Hoxford/tyler-woogduh/playground/RadioUpdater_Firmware/READ_ME.txt

This firmware is intended for use to update the BT radio module
See use instructions located in release directory
