Hoxford/tyler-woogduh/documents/mechanical/Daily Scrum and Status Reports for This Week/Kris's 10-01-14 Scrum Report.docx

10/1/2014 7:15:00 AM

Scrum Report For: Oct 1 2014

Yesterday’s Tasks

There were no OODG tasks scheduled yesterday due to other work commitments

Today’s Tasks

1. Write assembly procedure for EKG module. Identify any tools, etc., required for assembly.
2. When gaskets arrive, go to OODG and assemble Alpha 1 proto. Review and note problems or issues, and plan to make fixes. If Alpha 1 is OK, schedule visit to Out of Box.
3. Contact Sabic rep re material options, grades, etc.

GEBOWkris@gebow.com425-837-8700
