Hoxford/tyler-woogduh/documents/mechanical/Daily Scrum and Status Reports for This Week/Kris's 09-30-14 Scrum Report.docx

9/29/2014 5:12:00 PM

Scrum Report For: Sep 30 2014

Yesterday’s Tasks

Except for item 7, task list below is the same as in email sent yesterday PM with side grip pictures.

1. Reviewed Sabic site for color information. Have questions for them, left voice mail, waiting for call back.
2. Called Sabic rep re resin options, alternatives. Left voice mail, waiting for call back.
3. Talked to RTP, a materials supplier/compounder for Solid Concepts regarding resins and color input. They’ll have recommendations by sometime Wed Oct 1.
4. Could not find Skype email; could you please re-send invitation to join.
5. Sent updated cleaning instructions to Patrice cc Bob
6. Module with side grips
7. Bought adhesive and fiber washers for sealing leak test to

Today’s Tasks

Today I’ll be out of the office on other business. Please call if you have any questions. I’ll be back doing OODG work tomorrow.

Please let me know if the gaskets come in. I’ll come by ASAP to do fit checks.

GEBOWkris@gebow.com425-837-8700
