Hoxford/tyler-woogduh/documents/mechanical/Daily Scrum and Status Reports for This Week/Kris's x-x-14 Scrum Report.docx

7/9/2014 11:35:00 AM

Scrum Report For:

Yesterday’s Tasks

Today’s Tasks

GEBOWkris@gebow.com425-837-8700
