Hoxford/tyler-woogduh/documents/mechanical/Completion of PPR 100214.pdf

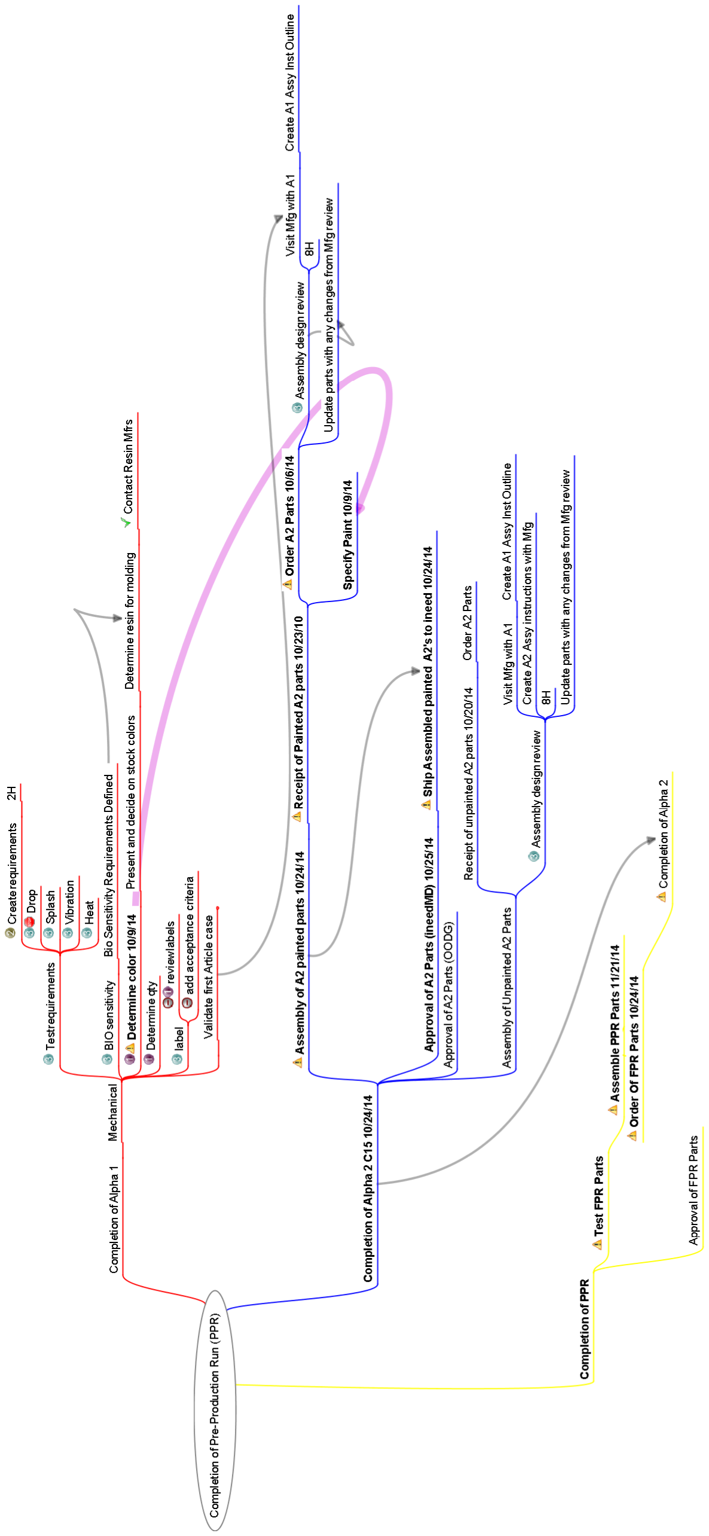
[picture p11: figure]
