Hoxford/tyler-woogduh/documents/mechanical/Current Design wAir Test Port/Notes and Parts Required for Leak Test.docx

Parts required for AT-Leakdown

1. Gauge – low pressure
2. Sealant
3. Manual Pump Bulb
4. Reservoir
5. Module fitting
6. Insert fitting
7. O-ring – 50 durometer
8. Air to Insert fitting
9. Tubing

GEBOWkris@gebow.com425-837-8700
