Hoxford/tyler-woogduh/documents/mechanical/Quotes/Ineed MD Mechanical Part Order List 090114.docx

Ineed MD Mechanical

09-01-14

Order list for proto 3

Item No | Name | P/N and Rev | Supplier | Qty | Cost (Ship not incld.) | Leadtime Business days | Quote/Notes
1 | Top | 10052 P3.3 | a. Fit Check Approval Parts a. Order 1 part from Fathom b. Shapeways Evaluation Part. Can Shapeways build good parts? c. In-house Parts - Shapeways a. After fit check Approval, order 8 parts d. Presentation Parts a. After fit check Approval, order 4 parts from Fathom | 1 1 8 2 | 120.25 26.84 214.72 240.49 | 4 est 7 7 4 | 10051_P33_10052_P33_10053_P33 Fathom quote A 10052 P3.3 Shapeways quote A 10052 P3.3 Shapeways quote C 10051_P33_10052_P33_10053_P33 Fathom quote A
2 | PCBA (Circuit Board Assy) | | See Brian, electrical assembly | 13 | 0
3 | Bottom | 10051 P3.3 | Same suppliers and instructions as Top a. Fit Check Approval Parts a. Order 1 part from Fathom, see quote b. Shapeways Evaluation Part. Can Shapeways build good parts? a. See quote c. In-house Parts - Shapeways a. After fit check Approval, order 8 parts from Shapeways, see quote d. Presentation Parts a. After fit check Approval, order 4 parts from Fathom | 1 1 8 2 | 117.61 31.58 252.64 235.23 | 4 est 7 7 4 | 10051_P33_10052_P33_10053_P33 Fathom quote A 10052 P3.3 Shapeways quote A 10052 P3.3 Shapeways quote D 10051_P33_10052_P33_10053_P33 Fathom quote B
4 | Label ineedMD 3 LED LR | 10059 P3.3 | Maverick Labels | 13 | 183.21 | | Need Artwork
5 | Lightpipe | 10053 P3.3 | From Stock | 39 | 0 | | 3 per assembly
6 | Screw Plastite or Equiv | 99461A286 | McMaster Carr | 50 | 25.00 | | Verify size 2 per assembly, order 2 pkgs of 25 Price includes shipping estimate
7 | Gasket | 10071 P3.3 | Stockwell | 150 | 230.00 | 12 | 10071 P3.3 Stockwell quote A 150 same price as 14 2 day ship est included
8 | Adhesive Pad | 10073 P3.3 | Gardico | 13 | 200.00 | | Estimate. quote coming soon
9 | Battery | | See Brian, electrical part | 13 | 0
10 | Foam Cushion | 10055 P3.4 | Stockwell | 150 | 230.00 | | 10055 P3.4 Stockwell quote A 150 same price as 14 2 day ship est included
11 | Label Serial Number | 10072 P3.3 | Maverick | 14 | 152.70 | 4 | Need Artwork
| | | | | 0
| Total | | | | 2158.18 | | Does not include Lightpipes if needed
