Hoxford/tyler-woogduh/documents/mechanical/Part Number Log.xlsx

Sheet: Part Numbers
Part number index - Object Oriented Design Group |  |  |  | Rev A 06-30-14 KCG | Create numbers 10050-10080 For ineedMD and new BOM 10050
Part Number | Description | Category | Part Replaced by | Replaced by date
10050 | Assy, ineedMD Mechanical | 01
10051 | Bottom | 05
10052 | Top | 05
10053 | Light Pipe | 05
10054 | Gasket, Die Cut | 09
10055 | Foam, Battery Cushion | 09
10056 | Label, ineedMD | 09
10057 | PCBA, ineedMD | 02
10058 | Label, ineedMD Left Right LED | 09
10059 | Label, ineedMD Upper-Lower LED | 09
10060 | Bottom 3 LED | 05
10061 | Assy Cable ECG (Spacelabs) | 03
10062 | Connector ECG
10063 | Connector Glove
10064 | PCBA, ECG Cable
10065
10066 | Assy, Overmold P2 and Cable
10067 | Garment Clip
10068 | Heat Shrink 6.4x11mm Black
10069 | PCB, ineedMD | 14
10070 | Battery
10071 | Gasket Cut
10072 | SN Label
10073 | Adhesive Pad
10074 | Gasket Molded
10075 | Bottom Audio Port
10076 | Top ATP (Audio-Test Port)
10077 | Pressure Test Connector
10078 | Assy PT Connector
10079 | ?
10080 | Assy ineedMD EKG Module
10081 | Light Pipe Holder
10082 | Label Serial Number P3
10083 | Label ineedMD Front P3
10084 | Light Pipe wDome
10085 | Battery Door
1051
1052
1053
1054
1055
1056
1057
1058
1059
1060

Sheet: Categories
Part Category Index
Category | Description | Examples
0 |  | Finished Goods, Boxed Ready to ship
01 | Finished Products | Dongle
02 | PCB Assemblies | Assemblies
03 | Cable Assemblies, External Product | Electrode Cable
04 | Cable Assemblies, Internal | Jack Harness
05 | Plastic molded part | Bottom
06 | Sheet metal part
07 | Product Subassembly
08 | Plastic molded part machined/modified/processed
09 | Die cut non-metallic parts | Gasket
10 | Plastic fabricated part
11 | Software, released, including updates
12 | Product packaging | Custom boxes
13 | Printed paper/sign material components | Display graphic foam board
14 | Printed circuit board, raw
15 | Tooling
16 | Label custom
17
18
19
20
21
22
23
24
25
26
27
28
29
30
31
32
33
34
35
36
37
38
39
40
41
42
43
44
45
46
47
48
49
50
51
52
53
54
55
56
57
58
59
60
61
62
63
64
65
66
67
68
69
70
71
72
73
74
75
76
77
78
79
80
81
82
83
84
85
86
87
88

Sheet: Readme
Part Number Category Index, Use Instructions | Rev A 6/12/13 DJD
Inneractive Enterprises, Inc.
When making any change to any sheet of the index, update the date on the top line of the first sheet.
To sort the index in non- part-number order, e.g. by category or category and description, make a copy and leave the original unchanged.
Part numbers are assigned for custom fabricated or assembled parts only, not off the shelf parts. The manufacturer or suppliers numbers are used for the latter.
Part numbers or categories may be reviewed and added to by opening, reading and or editing the appropriate page.
Note that when a change is made to a part that is not backwards or forwards compatible, the part should get a new part number and the new part noted with the date in the “Part replaced by” and “Part replaced by date” fields.
