Hoxford/tyler-woogduh/documents/mechanical/Current Design wAir Test Port/Quotes for Leak Test and Light Pipe Tool Parts.docx

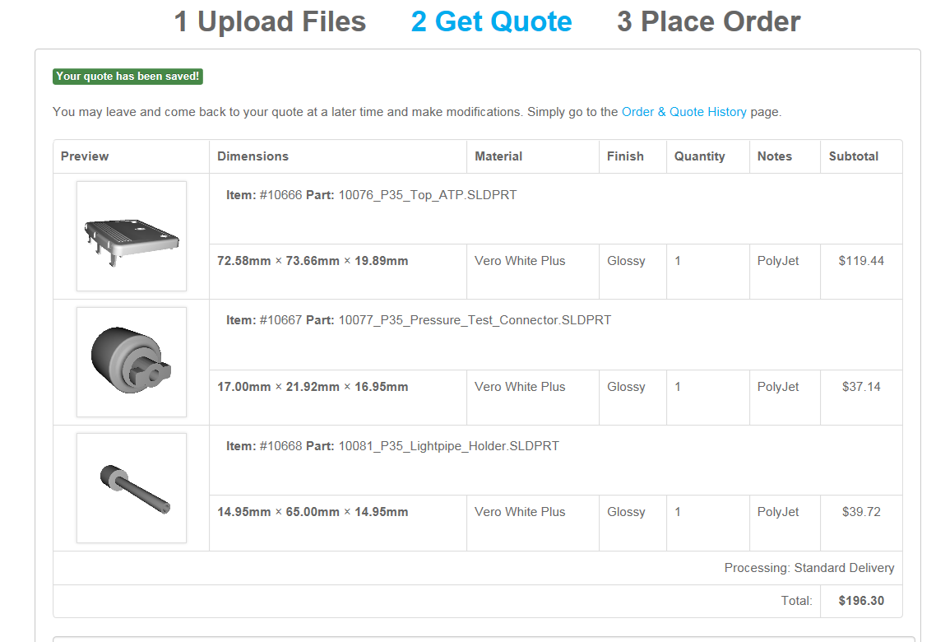
[picture p12: figure]
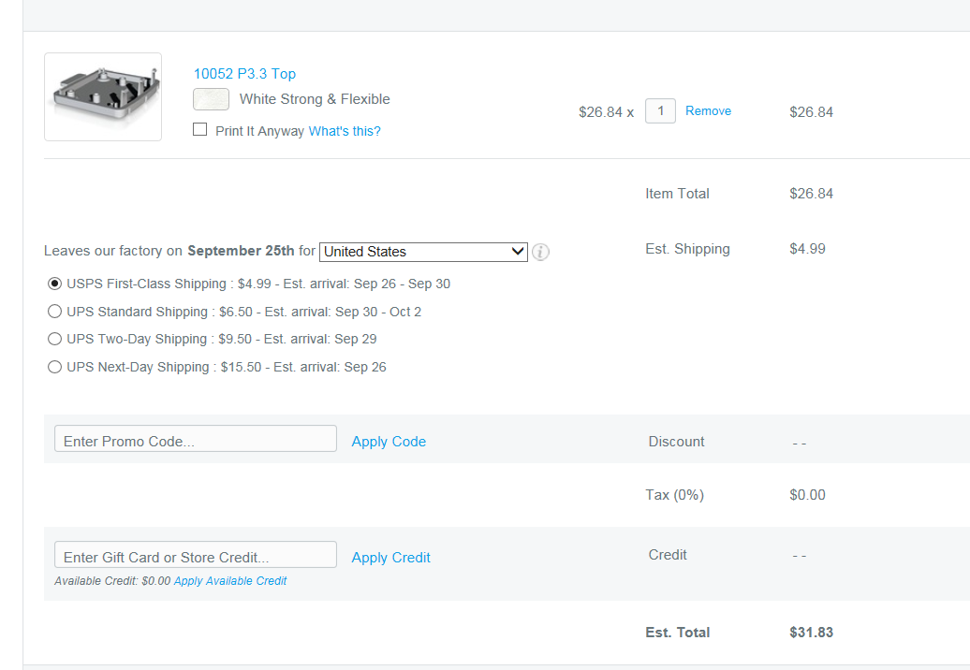
[picture p13: figure]
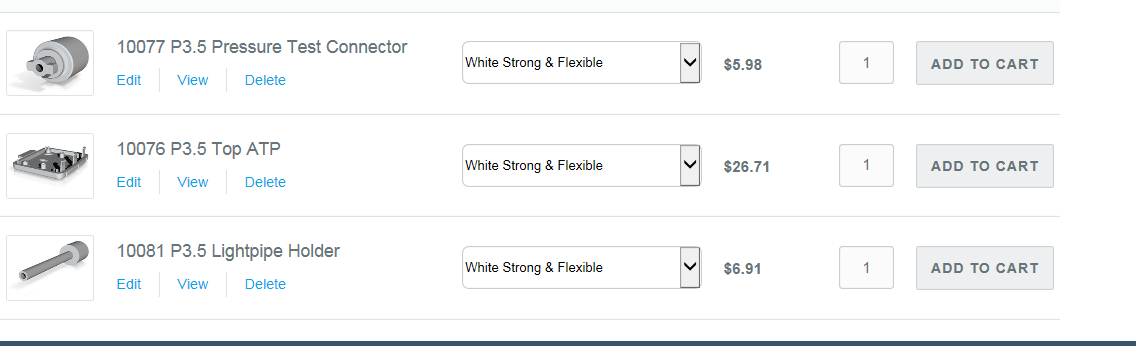
[picture p14: figure]
