Hoxford/tyler-woogduh/documents/mechanical/Current Design/Assy PT Connector.SLDASM

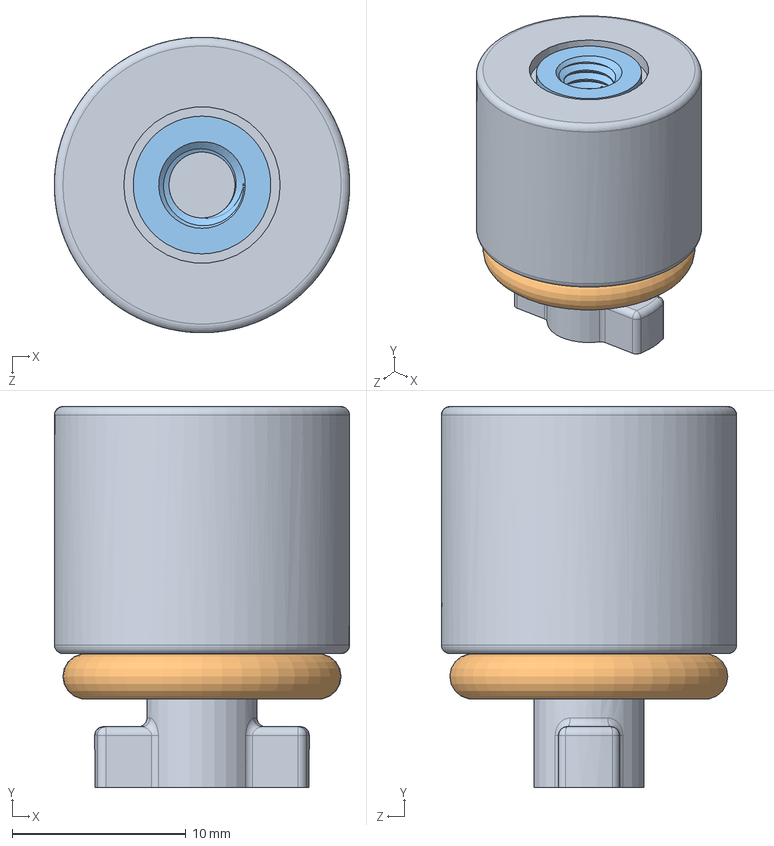
[picture p15: CAD file, 2014-10-17]
documents/mechanical/Current Design/Assy PT Connector.SLDASM
17.0 x 21.9 x 17.0 mm
10077 P3.4 Pressure Test Connector
AS568A-111
94615A115 10-32 Insert
