Hoxford/tyler-woogduh/documents/mechanical/Current Design/Assy for Light Pipe Work.SLDASM

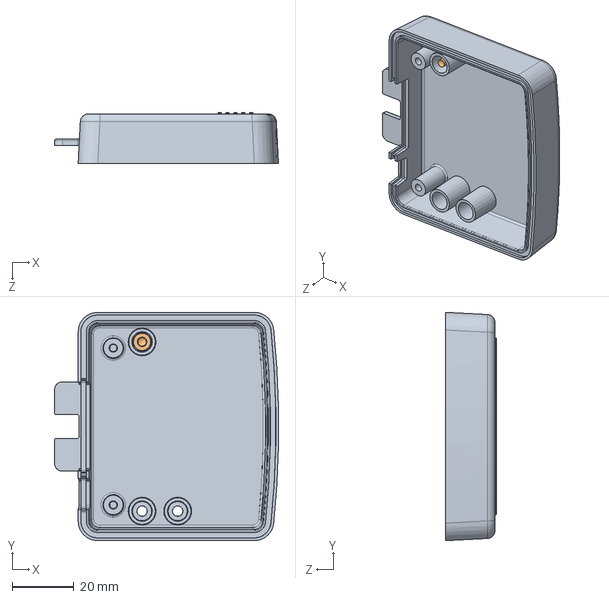
[picture p16: CAD file, 2014-10-17]
documents/mechanical/Current Design/Assy for Light Pipe Work.SLDASM
72.3 x 73.7 x 16.5 mm
10051 P3.3 Bottom
10084 P3.5 Light Pipe wDome
