Hoxford/tyler-woogduh/documents/mechanical/Current Design/SML-P24GR LED.SLDPRT

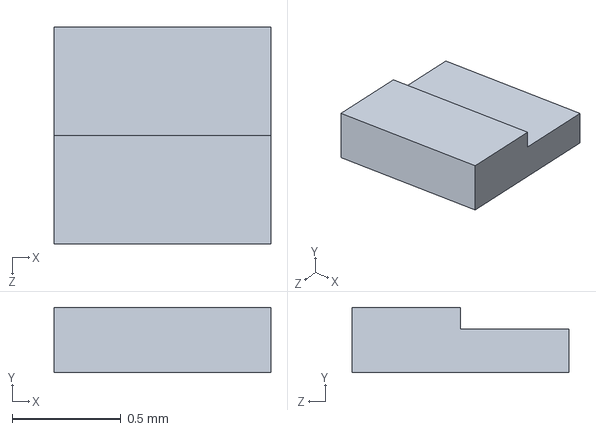
[picture p17: CAD file, 2014-10-17]
documents/mechanical/Current Design/SML-P24GR LED.SLDPRT
1.00 x 0.3 x 1.00 mm
