Hoxford/tyler-woogduh/documents/mechanical/Current Design wAir Test Port/uUSBconn.SLDPRT

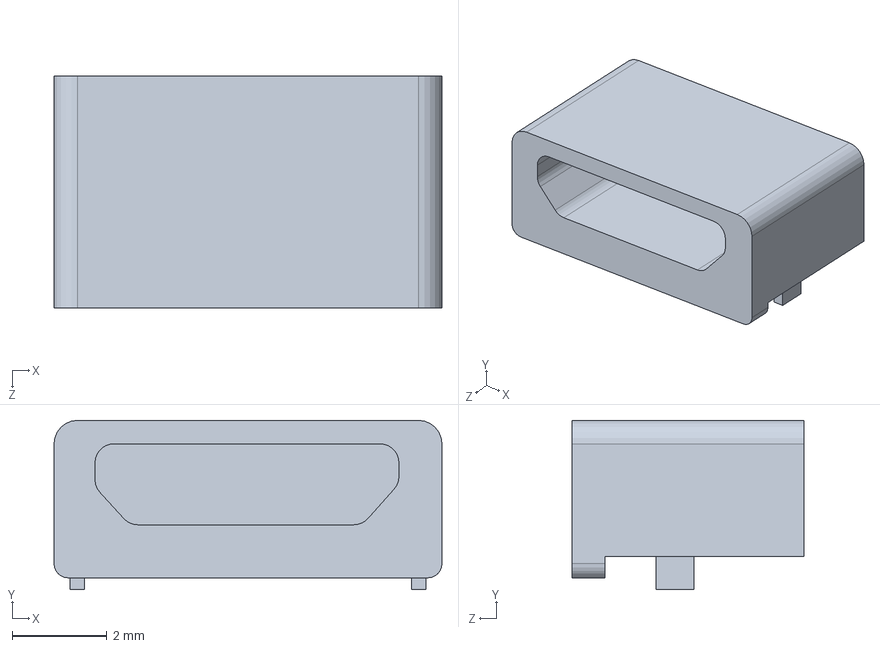
[picture p18: CAD file, 2014-10-17]
documents/mechanical/Current Design wAir Test Port/uUSBconn.SLDPRT
8.20 x 3.58 x 4.90 mm
