Hoxford/tyler-woogduh/documents/mechanical/Current Design wAir Test Port/AS568A-111.SLDPRT

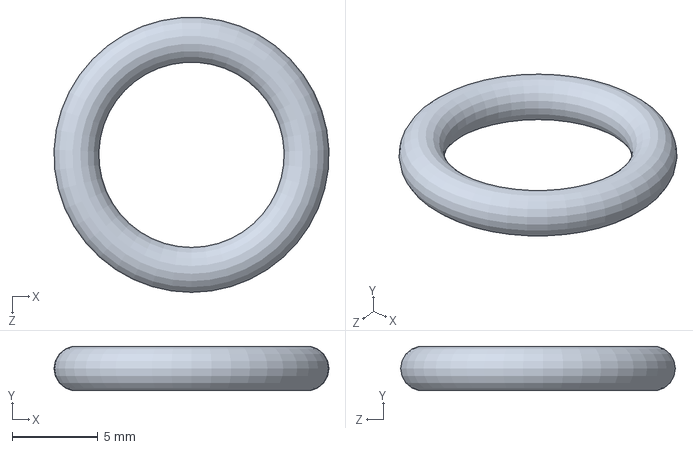
[picture p19: CAD file, 2014-10-17]
documents/mechanical/Current Design wAir Test Port/AS568A-111.SLDPRT
16.0 x 2.58 x 16.0 mm
