Hoxford/tyler-woogduh/documents/mechanical/Current Design/AAA Duracell Body-Plain.STEP

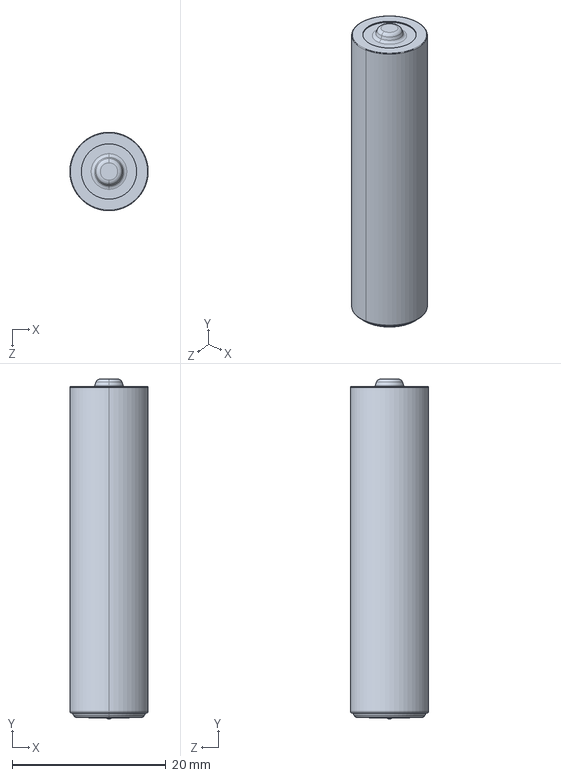
[picture p20: CAD file, 2014-10-17]
documents/mechanical/Current Design/AAA Duracell Body-Plain.STEP
10.2 x 44.2 x 10.2 mm
