Hoxford/tyler-woogduh/documents/mechanical/Current Design wAir Test Port/10057 P3.3 PCBA, ineedMD Mechanical.SLDASM

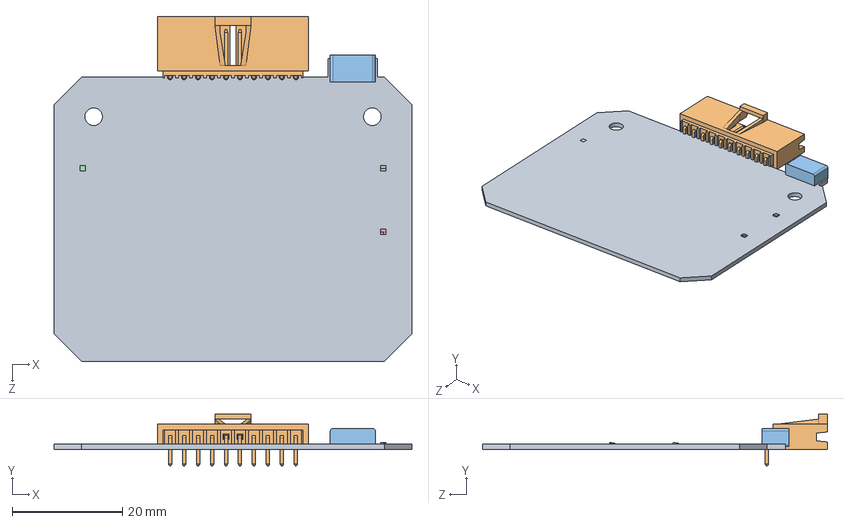
[picture p21: CAD file, 2014-10-17]
documents/mechanical/Current Design wAir Test Port/10057 P3.3 PCBA, ineedMD Mechanical.SLDASM
65.0 x 9.40 x 62.6 mm
10069 P3.3 PCB ineedMD
10pinconn
uUSBconn
SML-P24GR LED x 2
SML-P34GRB LED
