Hoxford/tyler-woogduh/(list of files, cad)

Other CAD files:
documents/mechanical/Current Design 092414/SML-P34GRB LED.SLDPRT
documents/mechanical/Current Design 092414/10pinconn.SLDPRT
documents/mechanical/Current Design/10pinconn.SLDPRT
documents/mechanical/Current Design wAir Test Port/SML-P34GRB LED.SLDPRT
documents/mechanical/Current Design wAir Test Port/10pinconn.SLDPRT
documents/mechanical/Current Design/AS568A-111.SLDPRT
documents/mechanical/Current Design/SML-P34GRB LED.SLDPRT
documents/mechanical/Current Design 092414/10050 P3.3 Assy, ineedMD Mechanical.SLDASM
documents/mechanical/Current Design 092414/10050 P3.4 Assy, ineedMD Mechanical.SLDDRW
documents/mechanical/Current Design 092414/10050 P3.5 Assy, ineedMD Mechanical.SLDDRW
documents/mechanical/Current Design 092414/10050 P3.6 Assy, ineedMD Mechanical.SLDDRW
documents/mechanical/Current Design 092414/10051 P3.3 Bottom.SLDPRT
documents/mechanical/Current Design 092414/10052 P3.3 Top.SLDPRT
documents/mechanical/Current Design 092414/10053 P3.4 Light Pipe.SLDPRT
documents/mechanical/Current Design 092414/10055 P3.4 Foam Cushion.SLDPRT
documents/mechanical/Current Design 092414/10057 P3.3 PCBA, ineedMD Mechanical.SLDASM
documents/mechanical/Current Design 092414/10059 P3.3 label, ineedMD 3 LED LR.SLDPRT
documents/mechanical/Current Design 092414/10069 P3.3 PCB ineedMD.SLDPRT
documents/mechanical/Current Design 092414/10070 P3.4 Battery.SLDPRT
documents/mechanical/Current Design 092414/10071 P3.3 Gasket Cut.SLDPRT
documents/mechanical/Current Design 092414/10072 P3.3 Serial Number Label.SLDPRT
documents/mechanical/Current Design 092414/10073 P3.3 Adhesive Pad.SLDPRT
documents/mechanical/Current Design 092414/10074 P3.4 Molded Gasket.SLDPRT
documents/mechanical/Current Design 092414/10082 P3.5 Serial Number Label.SLDPRT
documents/mechanical/Current Design 092414/10083 P3.5 Label ineedMD Front.SLDPRT
documents/mechanical/Current Design 092414/99461A286 4-20 x .5 Plastite.SLDPRT
documents/mechanical/Current Design wAir Test Port/10051 P3.3 Bottom.SLDPRT
documents/mechanical/Current Design wAir Test Port/10053 P3.4 Light Pipe.SLDPRT
documents/mechanical/Current Design wAir Test Port/10055 P3.4 Foam Cushion.SLDPRT
documents/mechanical/Current Design wAir Test Port/10057 P3.3 PCBA, ineedMD Mechanical.SLDDRW
documents/mechanical/Current Design wAir Test Port/10057 P3.4 PCBA, ineedMD Mechanical.SLDDRW
documents/mechanical/Current Design wAir Test Port/10059 P3.3 label, ineedMD 3 LED LR.SLDDRW
documents/mechanical/Current Design wAir Test Port/10059 P3.3 label, ineedMD 3 LED LR.SLDPRT
documents/mechanical/Current Design wAir Test Port/10069 P3.3 PCB ineedMD.SLDPRT
documents/mechanical/Current Design wAir Test Port/10070 P3.4 Battery.SLDPRT
documents/mechanical/Current Design wAir Test Port/10072 P3.3 Serial Number Label.SLDDRW
documents/mechanical/Current Design wAir Test Port/10072 P3.3 Serial Number Label.SLDPRT
documents/mechanical/Current Design wAir Test Port/10073 P3.3 Adhesive Pad.SLDDRW
documents/mechanical/Current Design wAir Test Port/10073 P3.3 Adhesive Pad.SLDPRT
documents/mechanical/Current Design wAir Test Port/10074 P3.4 Molded Gasket.SLDPRT
documents/mechanical/Current Design wAir Test Port/10076 P3.4 Top ATP.SLDPRT
documents/mechanical/Current Design wAir Test Port/10076 P3.5 Top ATP.SLDPRT
documents/mechanical/Current Design wAir Test Port/10076 P3.5 Top ATP.STL
documents/mechanical/Current Design wAir Test Port/10077 P3.4 Pressure Test Connector.SLDPRT
documents/mechanical/Current Design wAir Test Port/10077 P3.5 Pressure Test Connector.SLDPRT
documents/mechanical/Current Design wAir Test Port/10077 P3.5 Pressure Test Connector.STL
documents/mechanical/Current Design wAir Test Port/10078 P3.4 Assy ATP Connector.SLDASM
documents/mechanical/Current Design wAir Test Port/10080 P3.4 Assy, ineedMD Mech Module ATP.SLDASM
documents/mechanical/Current Design wAir Test Port/10081 P3.5 Lightpipe Holder.SLDPRT
documents/mechanical/Current Design wAir Test Port/10081 P3.5 Lightpipe Holder.STL
documents/mechanical/Current Design wAir Test Port/94615A115 10-32 Insert.SLDPRT
documents/mechanical/Current Design wAir Test Port/99461A286 4-20 x .5 Plastite.SLDPRT
documents/mechanical/Current Design/10050 P3.3 Assy, ineedMD Mechanical.SLDASM
documents/mechanical/Current Design/10050 P3.4 Assy, ineedMD Mechanical.SLDDRW
documents/mechanical/Current Design/10051 P3.3 Bottom.SLDPRT
documents/mechanical/Current Design/10052 P3.3 Top.SLDPRT
documents/mechanical/Current Design/10053 P3.4 Light Pipe.SLDPRT
documents/mechanical/Current Design/10055 P3.4 Foam Cushion.SLDPRT
documents/mechanical/Current Design/10057 P3.3 PCBA, ineedMD Mechanical.SLDASM
documents/mechanical/Current Design/10059 P3.3 label, ineedMD 3 LED LR.SLDPRT
documents/mechanical/Current Design/10069 P3.3 PCB ineedMD.SLDPRT
documents/mechanical/Current Design/10070 P3.4 Battery.SLDPRT
documents/mechanical/Current Design/10071 P3.3 Gasket Cut.SLDPRT
documents/mechanical/Current Design/10071 P3.4 Gasket Cut.SLDDRW
documents/mechanical/Current Design/10072 P3.3 Serial Number Label.SLDPRT
documents/mechanical/Current Design/10073 P3.3 Adhesive Pad.SLDPRT
documents/mechanical/Current Design/10074 P3.4 Molded Gasket.SLDPRT
documents/mechanical/Current Design/10077 P3.4 Pressure Test Connector.SLDPRT
documents/mechanical/Current Design/10082 P3.5 Serial Number Label.SLDPRT
documents/mechanical/Current Design/10083 P3.5 Label ineedMD Front.SLDPRT
documents/mechanical/Current Design/10084 P3.5 Light Pipe wDome.SLDPRT
documents/mechanical/Current Design/94615A115 10-32 Insert.SLDPRT
documents/mechanical/Current Design/99461A286 4-20 x .5 Plastite.SLDPRT
documents/mechanical/Current Design/AAA Duracell Body-Plain.SLDPRT
