Hoxford/tyler-woogduh/documents/mechanical/Current Design wAir Test Port/Air Supply Fitting for Low Pressure Leak Tests.docx

09-10-14

Printed fitting with O-ring and 10-32 brass insert. Leak test by attaching low pressure (< 4 psi) air supply. Uses

Audio port under serial number label.

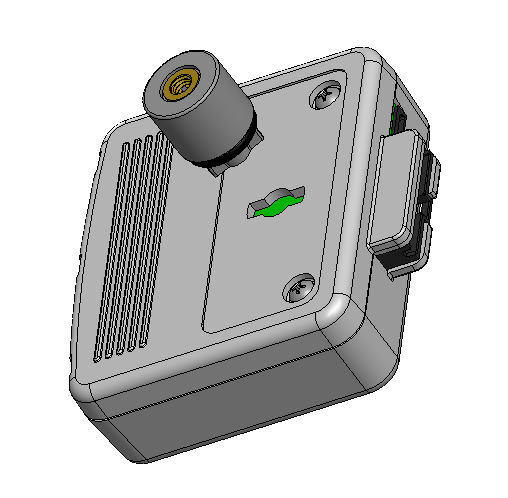
[picture p22: figure]
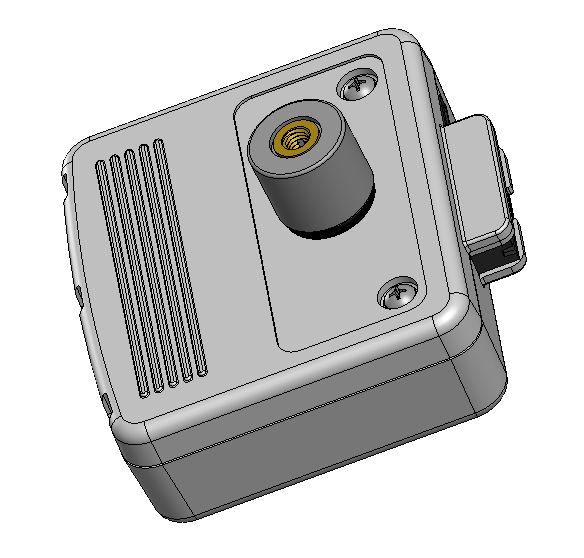
[picture p23: figure]
