Hoxford/tyler-woogduh/documents/mechanical/Current Design wAir Test Port/Tube to 10-32 fitting.docx

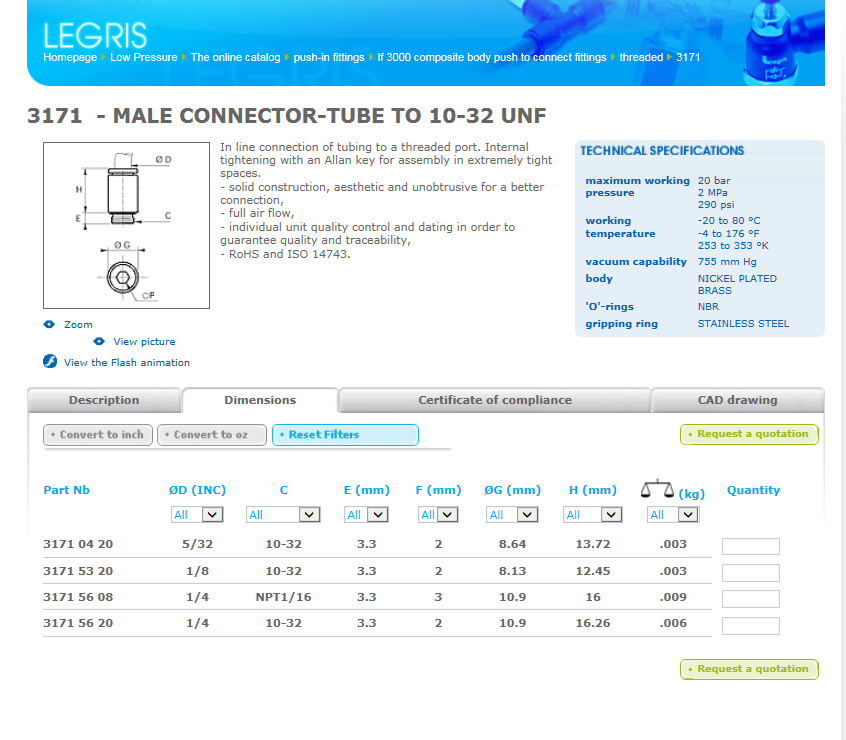
[picture p24: figure]
