Hoxford/tyler-woogduh/documents/mechanical/Tests/Mechanical Environmental Test Labs.docx

Test labs

Cascadetek Hillsboro OR

855-276-8619

Adam Yeaney

Yeaney@cascadetek.com

Element Bothell

Bothell WA

425-984-2715

Kendall Jones

Kendall.jones@element.com

GEBOWkris@gebow.com425-837-8700
