Hoxford/tyler-woogduh/documents/mechanical/10050 P3.4 Assy, ineedMD Mechanical wBOM.pdf

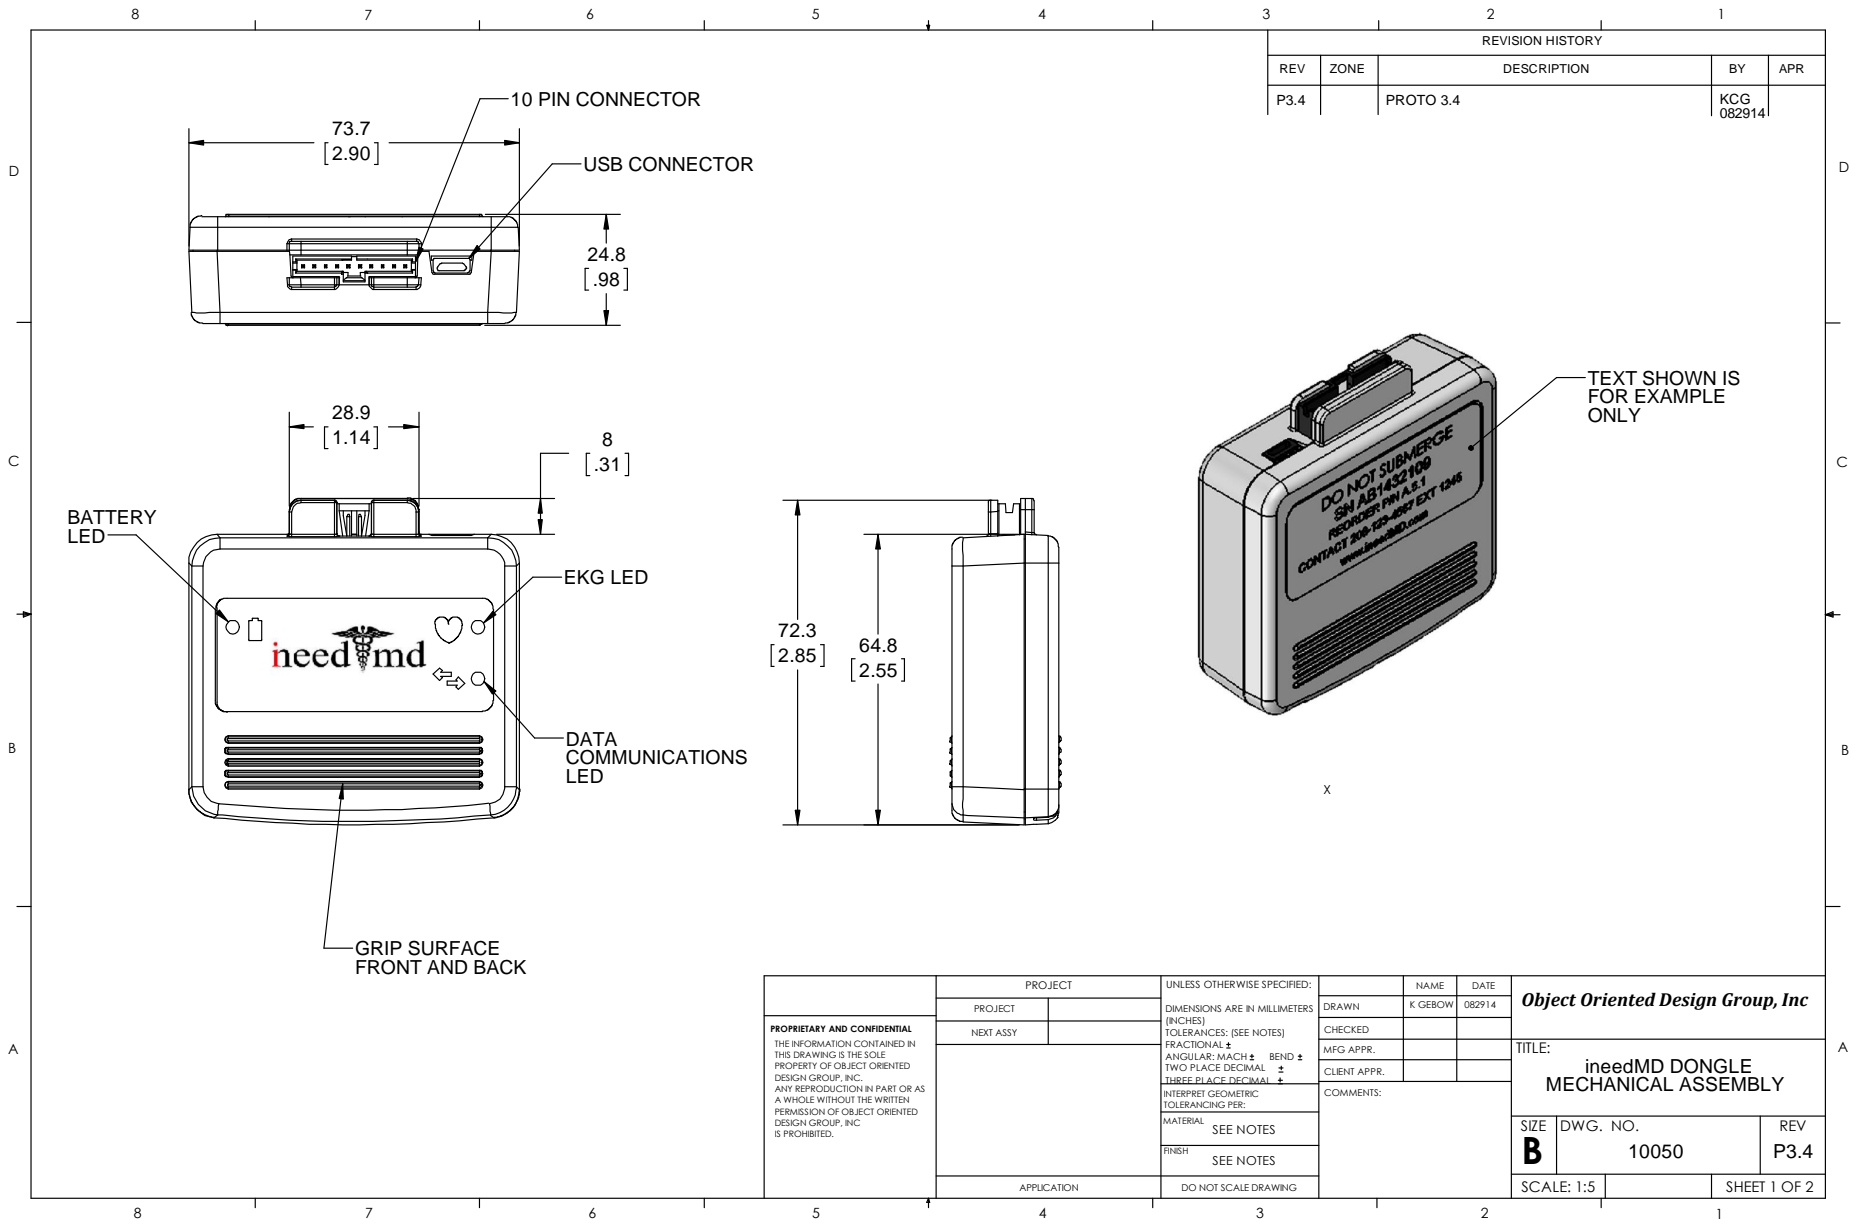
[picture p25: page 1]
10 PIN CONNECTOR; PROTO 3.4; USB CONNECTOR; KCG 082914; SEE NOTES; DO NOT SCALE DRAWING; SHEET 1 OF 2; SCALE: 1:5; APPLICATION; FINISH; LED; BATTERY; EKG LED; COMMUNICATIONS; DATA

REVISION HISTORY

REV | ZONE | DESCRIPTION | BY | APR

TEXT SHOWN IS
FOR EXAMPLE
ONLY

GRIP SURFACE
FRONT AND BACK

PROJECT | UNLESS OTHERWISE SPECIFIED: DIMENSIONS ARE IN MILLIMETERS (INCHES) TOLERANCES: (SEE NOTES) FRACTIONAL ANGULAR: MACH BEND TWO PLACE DECIMAL THREE PLACE DECIMAL | | NAME | DATE | Object Oriented Design Group, Inc

PROJECT | | | DRAWN | K GEBOW | 082914

PROPRIETARY AND CONFIDENTIAL THE INFORMATION CONTAINED IN THIS DRAWING IS THE SOLE PROPERTY OF OBJECT ORIENTED DESIGN GROUP, INC. ANY REPRODUCTION IN PART OR AS A WHOLE WITHOUT THE WRITTEN PERMISSION OF OBJECT ORIENTED DESIGN GROUP, INC IS PROHIBITED. | NEXT ASSY | | | CHECKED

MFG APPR. | | | TITLE: ineedMD DONGLE MECHANICAL ASSEMBLY

CLIENT APPR.

INTERPRET GEOMETRIC TOLERANCING PER: | COMMENTS:

MATERIAL SEE NOTES | | SIZE B | DWG. NO. 10050 | REV P3.4

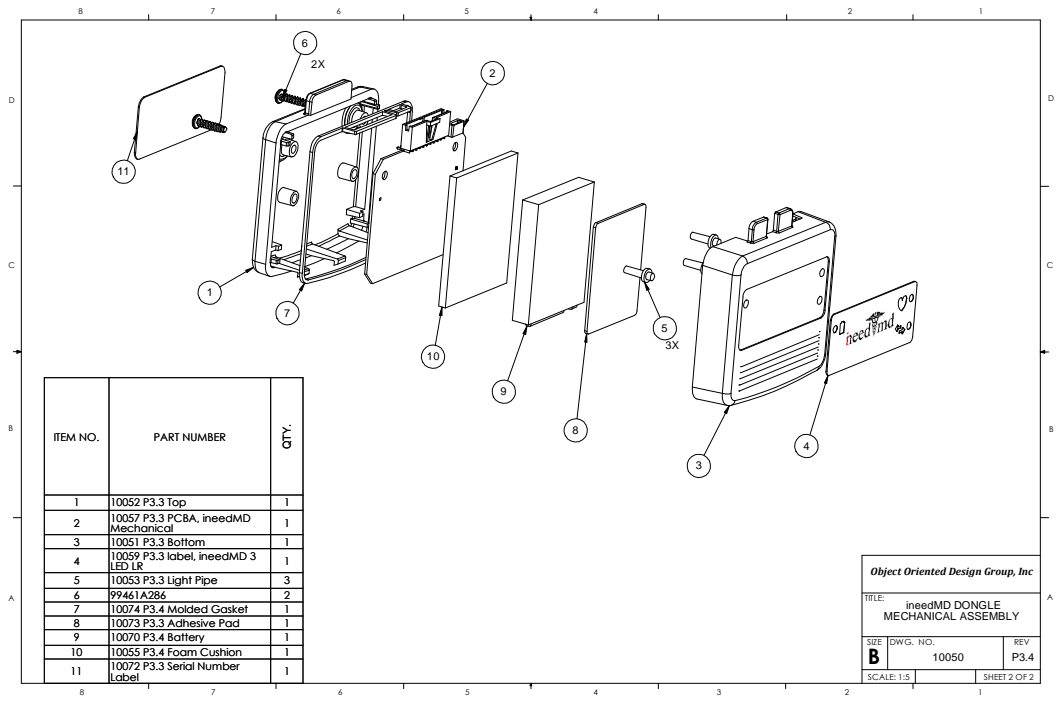
[picture p26: page 2]
ineedMD DONGLE MECHANICAL ASSEMBLY; QTY.; TITLE:

ITEM NO. | PART NUMBER

1 1 | 10052 P3.3 Top | 1 1
2 2 | 10057 P3.3 PCBA, ineedMD 10057 P3.3 PCBA, ineedMD Mechanical Mechanical | 1 1
3 3 | 10051 P3.3 Bottom | 1 1
4 4 | 10059 P3.3 label, ineedMD 3 10059 P3.3 label, ineedMD 3 LED LR LED LR | 1 1
5 5 | 10053 P3.3 Light Pipe | 3 3
6 6 | 99461A286 | 2 2
7 7 | 10074 P3.4 Molded Gasket | 1 1
8 8 | 10073 P3.3 Adhesive Pad | 1 1
9 9 | 10070 P3.4 Battery | 1 1
10 10 | 10055 P3.4 Foam Cushion | 1 1
11 11 | 10072 P3.3 Serial Number 10072 P3.3 Serial Number Label Label | 1 1

Object Oriented Design Group, Inc

SIZE B | DWG. NO. 10050 | REV P3.4

SCALE: 1:5 | | SHEET 2 OF 2
