Hoxford/tyler-woogduh/documents/mechanical/10050 P3.6 Assy, ineedMD Mechanical.pdf

092414 10 PIN CONNECTOR | P3.6 | ALPHA 2 PROTO | KCG

# USB CONNECTOR

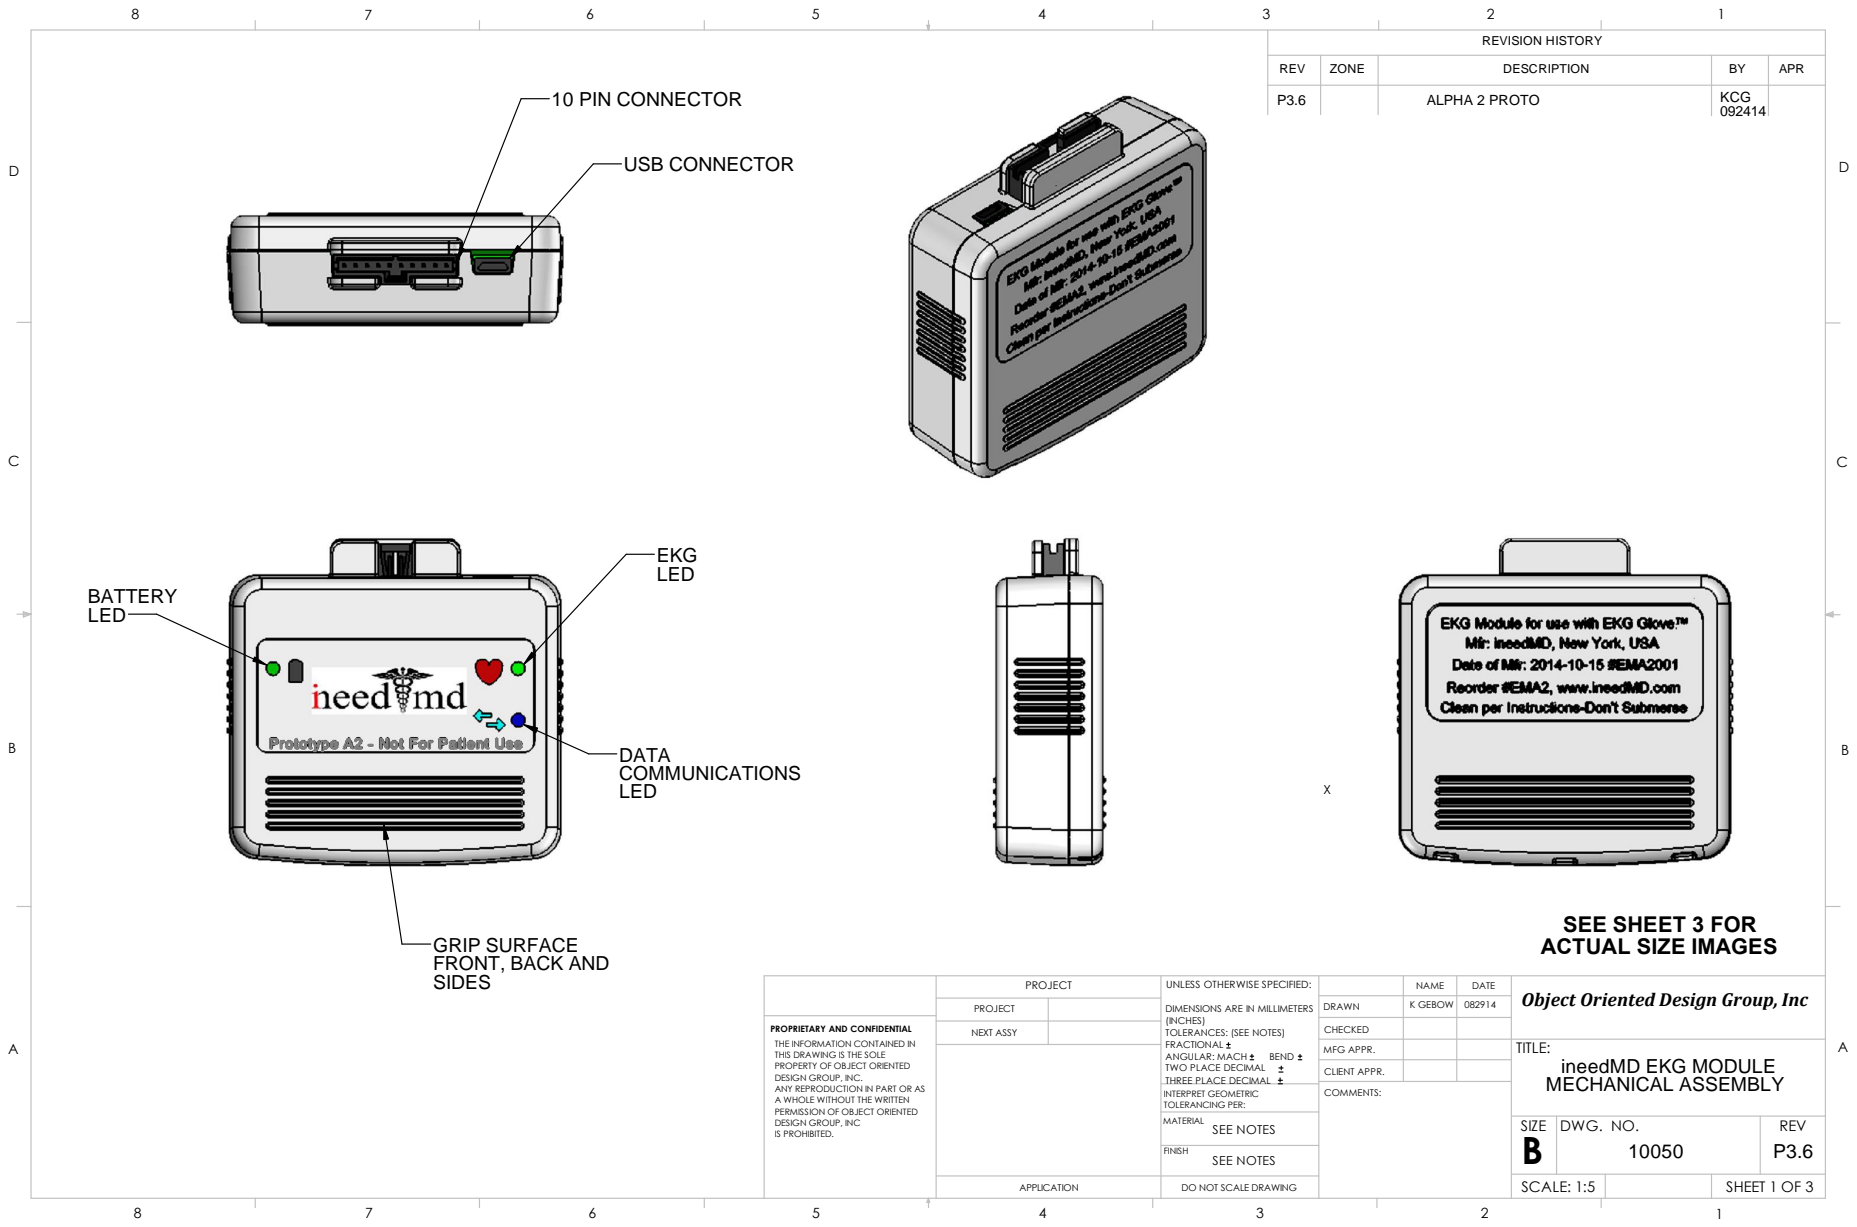
[picture p27: page 1]
SEE NOTES; DO NOT SCALE DRAWING; SHEET 1 OF 3; SCALE: 1:5; APPLICATION; FINISH; BATTERY LED; EKG LED; DATA COMMUNICATIONS LED

REVISION HISTORY

REV | ZONE | DESCRIPTION | BY | APR

SEE SHEET 3 FOR
ACTUAL SIZE IMAGES

GRIP SURFACE
FRONT, BACK AND
SIDES

PROJECT | UNLESS OTHERWISE SPECIFIED: DIMENSIONS ARE IN MILLIMETERS (INCHES) TOLERANCES: (SEE NOTES) FRACTIONAL ANGULAR: MACH BEND TWO PLACE DECIMAL THREE PLACE DECIMAL | | NAME | DATE | Object Oriented Design Group, Inc

PROJECT | | | DRAWN | K GEBOW | 082914

PROPRIETARY AND CONFIDENTIAL THE INFORMATION CONTAINED IN THIS DRAWING IS THE SOLE PROPERTY OF OBJECT ORIENTED DESIGN GROUP, INC. ANY REPRODUCTION IN PART OR AS A WHOLE WITHOUT THE WRITTEN PERMISSION OF OBJECT ORIENTED IS PROHIBITED. | NEXT ASSY | | | CHECKED

MFG APPR. | | | TITLE: ineedMD EKG MODULE MECHANICAL ASSEMBLY

CLIENT APPR.

INTERPRET GEOMETRIC TOLERANCING PER: | COMMENTS:

MATERIAL SEE NOTES | | SIZE DESIGN GROUP, INC B | DWG. NO. 10050 | REV P3.6

D
D

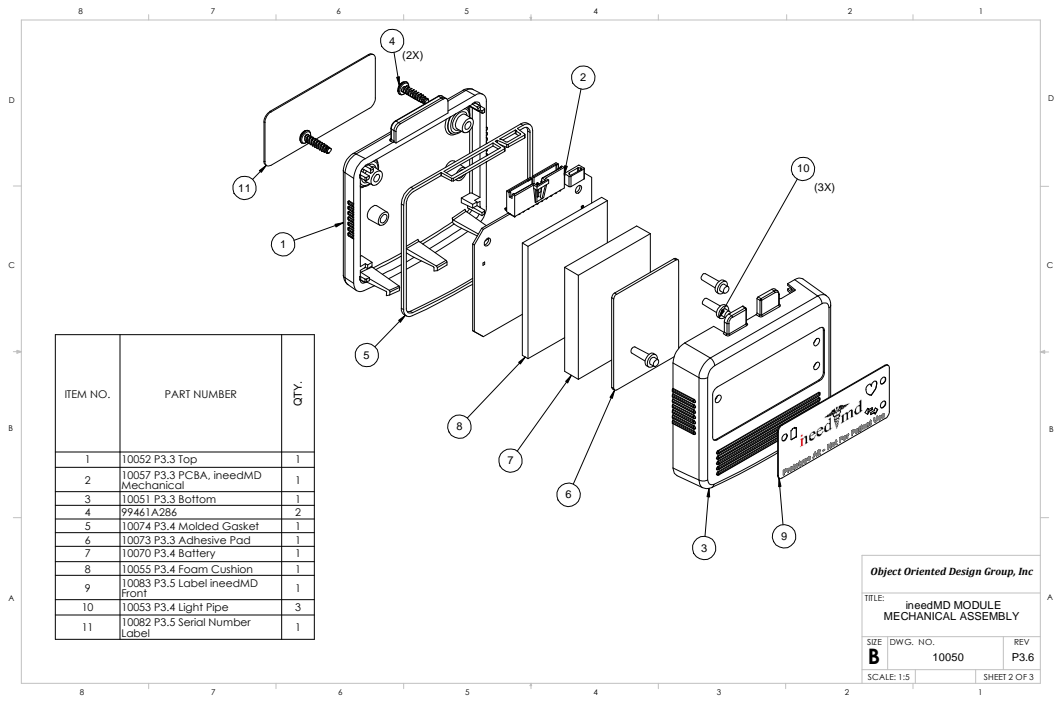
[picture p28: page 2]
TITLE:; ineedMD MODULE MECHANICAL ASSEMBLY; QTY.

ITEM NO. | PART NUMBER

1 | 10052 P3.3 Top | 1
2 | 10057 P3.3 PCBA, ineedMD Mechanical | 1
3 | 10051 P3.3 Bottom | 1
4 | 99461A286 | 2
5 | 10074 P3.4 Molded Gasket | 1
6 | 10073 P3.3 Adhesive Pad | 1
7 | 10070 P3.4 Battery | 1
8 | 10055 P3.4 Foam Cushion | 1
9 | 10083 P3.5 Label ineedMD Front | 1
10 | 10053 P3.4 Light Pipe | 3
11 | 10082 P3.5 Serial Number Label | 1

Object Oriented Design Group, Inc

SIZE B | DWG. NO. 10050 | REV P3.6

SCALE: 1:5 | | SHEET 2 OF 3

D
D

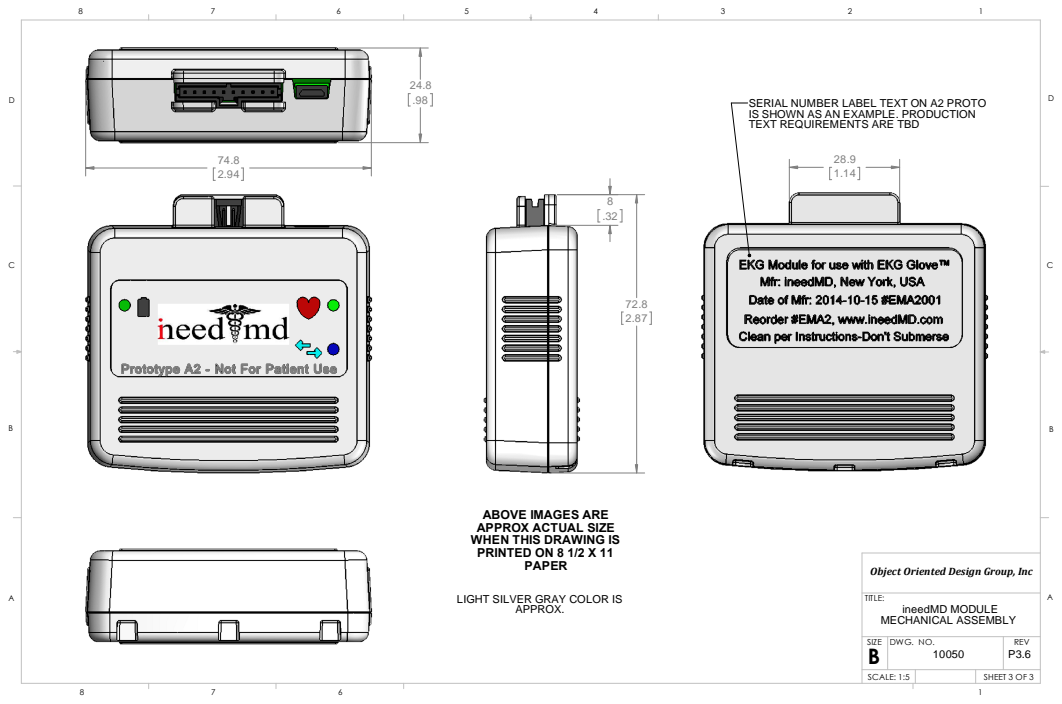
[picture p29: page 3]
TITLE:; ineedMD MODULE MECHANICAL ASSEMBLY; PAPER; APPROX.

SERIAL NUMBER LABEL TEXT ON A2 PROTO
IS SHOWN AS AN EXAMPLE. PRODUCTION
TEXT REQUIREMENTS ARE TBD

ABOVE IMAGES ARE
APPROX ACTUAL SIZE
WHEN THIS DRAWING IS
PRINTED ON 8 1/2 X 11

Object Oriented Design Group, Inc

LIGHT SILVER GRAY COLOR IS

SIZE B | DWG. NO. 10050 | REV P3.6

SCALE: 1:5 | | SHEET 3 OF 3
