Hoxford/tyler-woogduh/documents/mechanical/10057 P3.4 PCBA, ineedMD Mechanical.PDF

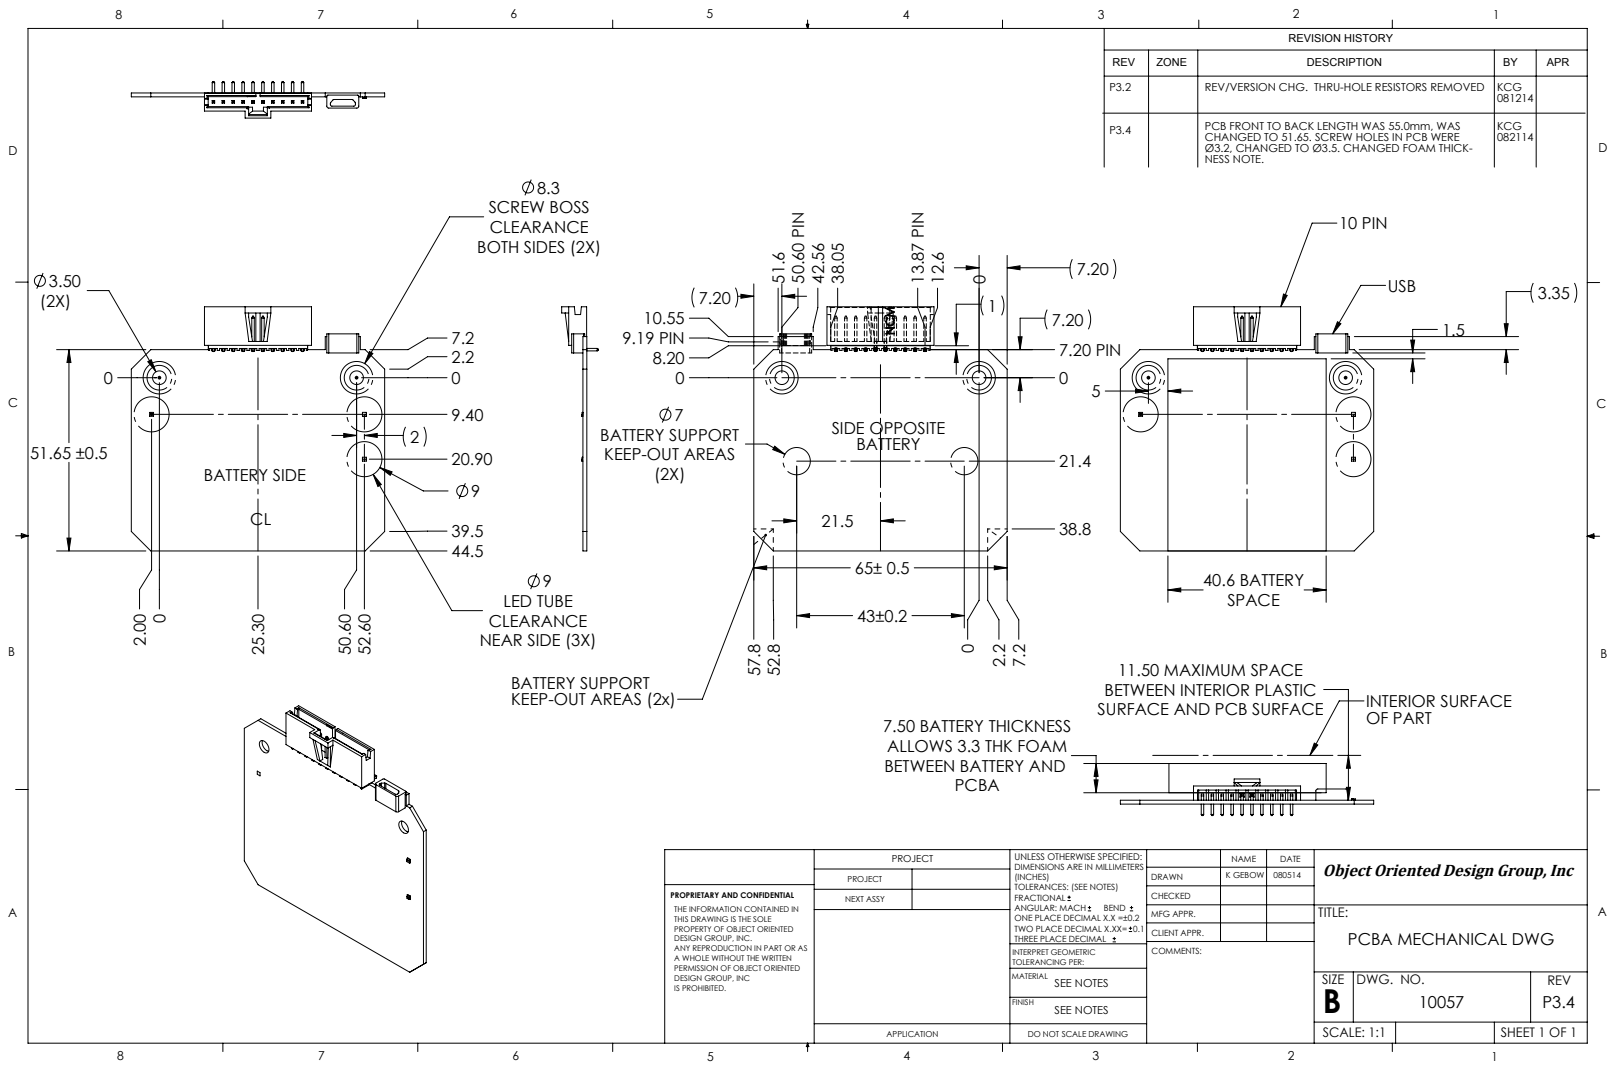
[picture p30: page 1]
SCREW BOSS; BOTH SIDES (2X); 50.60 PIN; 13.87 PIN; 7.20 PIN 9.19 PIN; 40.6 BATTERY; 10 PIN; SURFACE AND PCB SURFACE; INTERIOR SURFACE; OF PART; PCBA MECHANICAL DWG; K GEBOW 080514; REV/VERSION CHG. THRU-HOLE RESISTORS REMOVED KCG; BATTERY SIDE; SIDE OPPOSITE; PCB FRONT TO BACK LENGTH WAS 55.0mm, WAS; PROPRIETARY AND CONFIDENTIAL; NEXT ASSY; ANGULAR: MACH; BEND; MFG APPR.; CLIENT APPR.; DWG. NO.; REV; SCALE: 1:1; DO NOT SCALE DRAWING; SHEET 1 OF 1; REVISION HISTORY

CHANGED TO 51.65. SCREW HOLES IN PCB WERE
Ø3.2, CHANGED TO Ø3.5. CHANGED FOAM THICK-
NESS NOTE.

BATTERY SUPPORT
KEEP-OUT AREAS

LED TUBE
CLEARANCE
NEAR SIDE (3X)
KEEP-OUT AREAS (2x)

11.50 MAXIMUM SPACE
BETWEEN INTERIOR PLASTIC

7.50 BATTERY THICKNESS
ALLOWS 3.3 THK FOAM
BETWEEN BATTERY AND

UNLESS OTHERWISE SPECIFIED:
DIMENSIONS ARE IN MILLIMETERS
(INCHES)
TOLERANCES: (SEE NOTES)
FRACTIONAL
ONE PLACE DECIMAL X.X =±0.2
TWO PLACE DECIMAL X.XX= 0.1
THREE PLACE DECIMAL
INTERPRET GEOMETRIC
TOLERANCING PER:
MATERIAL
SEE NOTES

Object Oriented Design Group, Inc

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
