Hoxford/tyler-woogduh/documents/mechanical/Current Design wAir Test Port/10071 P3.3 Gasket Cut.PDF

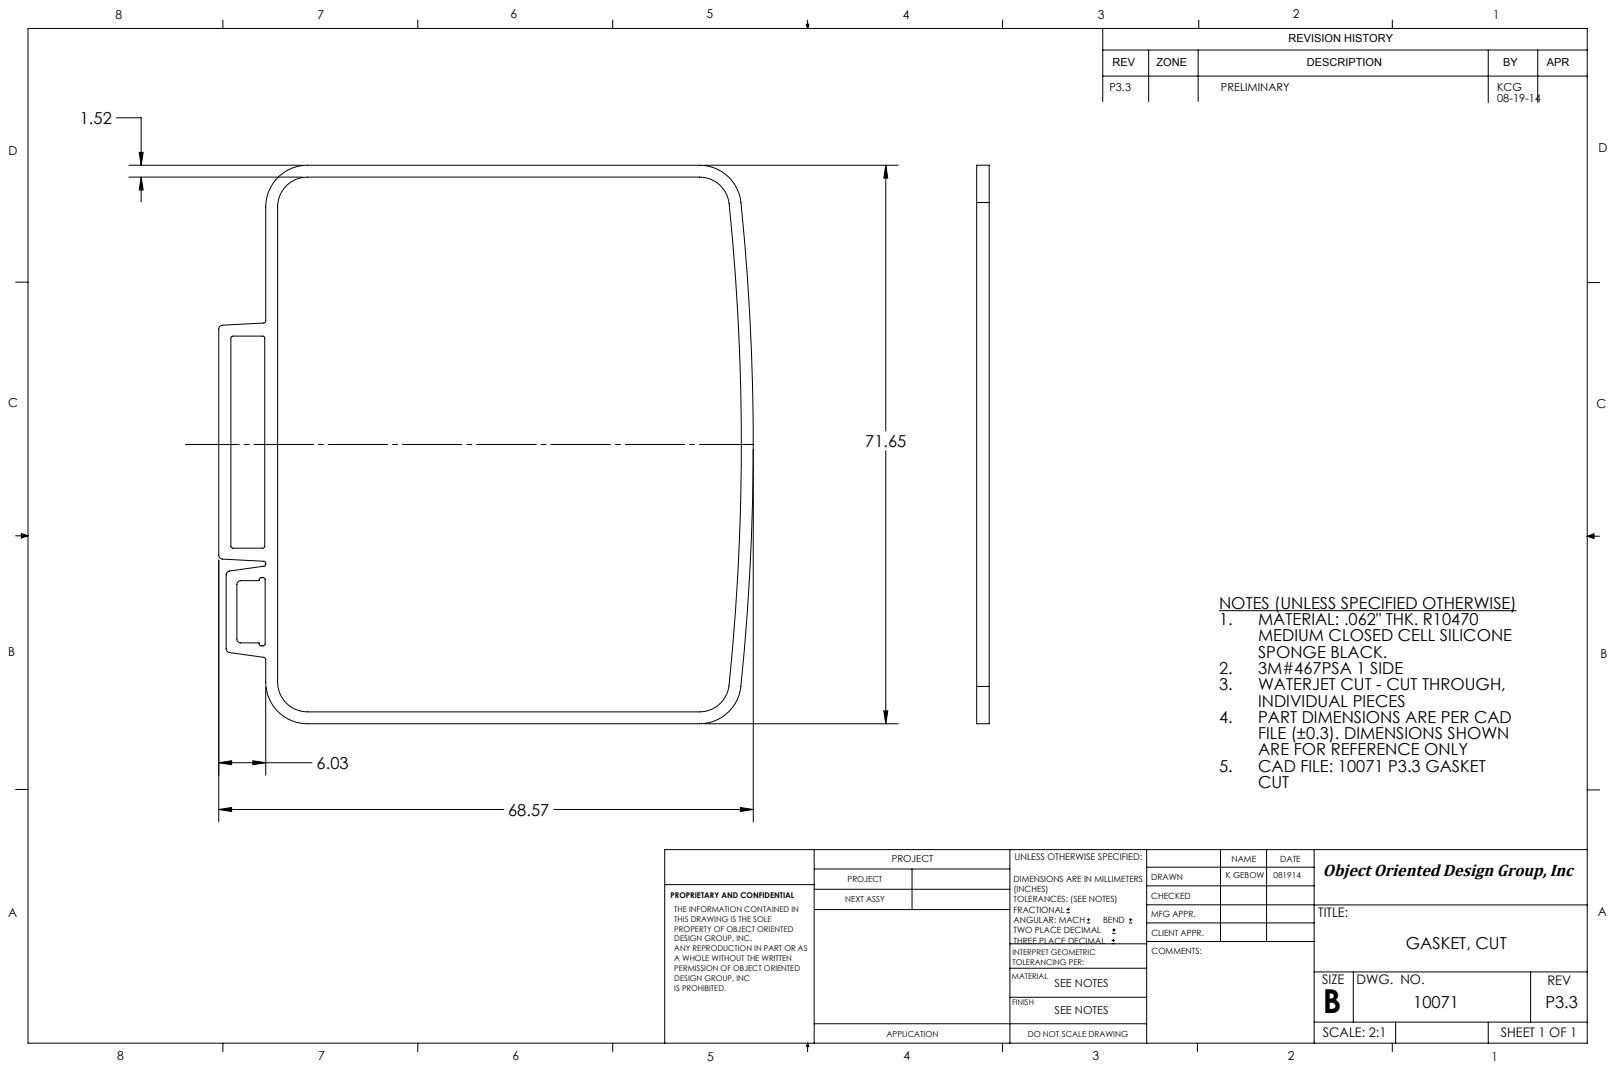
[picture p31: page 1]
GASKET, CUT; K GEBOW 081914; PROPRIETARY AND CONFIDENTIAL; NEXT ASSY; ANGULAR: MACH; BEND; MFG APPR.; CLIENT APPR.; DWG. NO.; REV; SCALE: 2:1; DO NOT SCALE DRAWING; SHEET 1 OF 1; REVISION HISTORY

NOTES (UNLESS SPECIFIED OTHERWISE)
1. MATERIAL: .062" THK. R10470
MEDIUM CLOSED CELL SILICONE
SPONGE BLACK.
2. 3M#467PSA 1 SIDE
3. WATERJET CUT - CUT THROUGH,
INDIVIDUAL PIECES
4. PART DIMENSIONS ARE PER CAD
FILE (±0.3). DIMENSIONS SHOWN
ARE FOR REFERENCE ONLY
5. CAD FILE: 10071 P3.3 GASKET
CUT

UNLESS OTHERWISE SPECIFIED:

Object Oriented Design Group, Inc

DIMENSIONS ARE IN MILLIMETERS
(INCHES)
TOLERANCES: (SEE NOTES)
FRACTIONAL
TWO PLACE DECIMAL
THREE PLACE DECIMAL
INTERPRET GEOMETRIC
TOLERANCING PER:
MATERIAL
SEE NOTES

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
