Hoxford/tyler-woogduh/documents/mechanical/Spec Sheets/94615A115 10-32 Insert.pdf

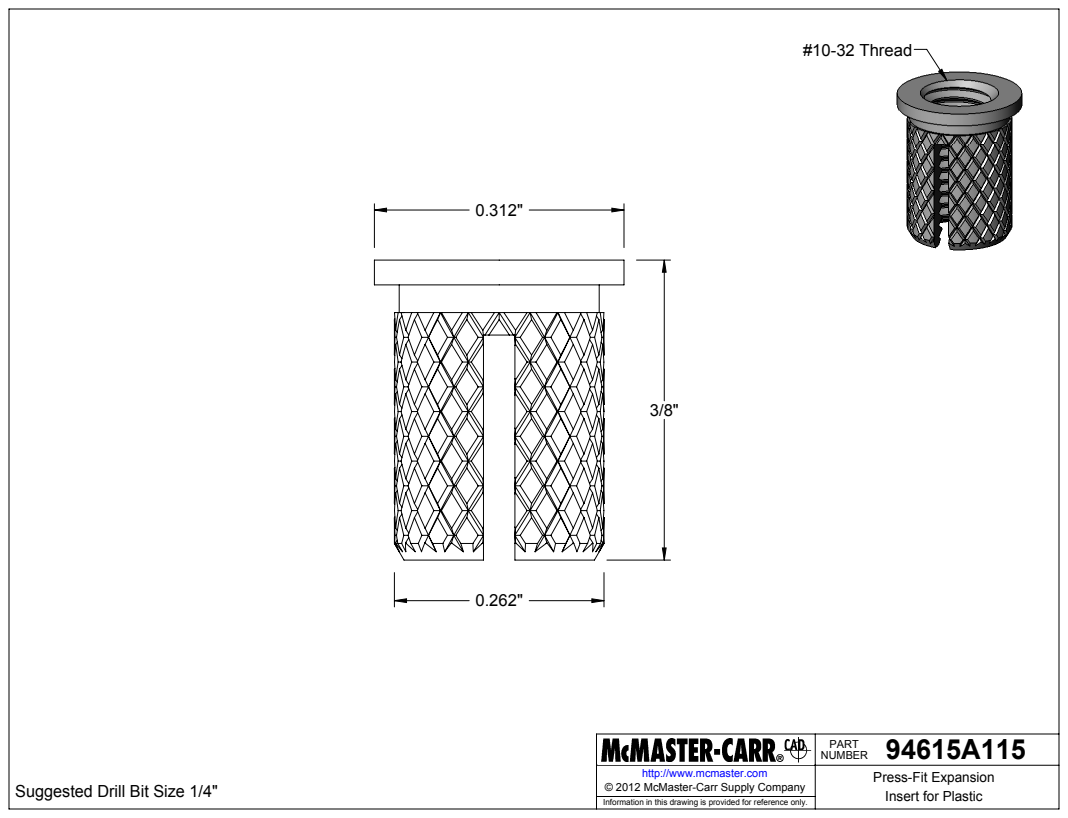
[picture p32: page 1]
#10-32 Thread; Suggested Drill Bit Size 1/4"; Insert for Plastic © 2012 McMaster-Carr Supply Company

94615A115 PART NUMBER

http://www.mcmaster.com | Press-Fit Expansion

Information in this drawing is provided for reference only.
