Hoxford/tyler-woogduh/documents/mechanical/Mech Part Deliveries A2 010614.pdf

# Mech Part Deliveries

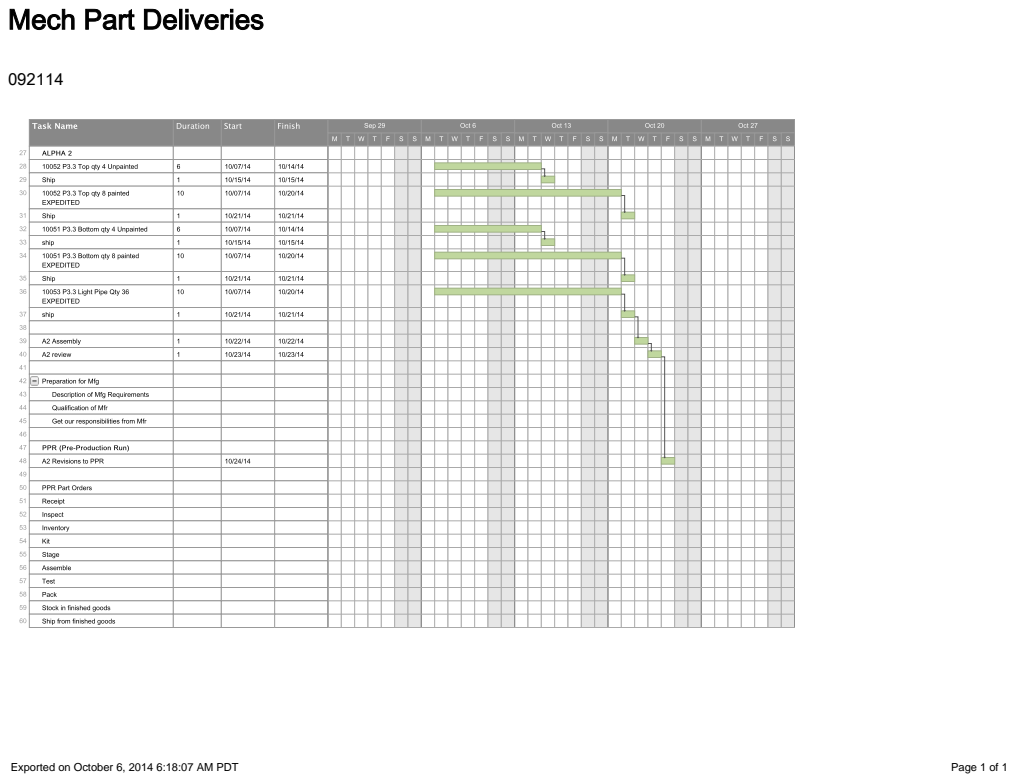
[picture p33: page 1]
Exported on October 6, 2014 6:18:07 AM PDT; Page 1 of
