Hoxford/tyler-woogduh/documents/mechanical/Design Archive/Mech Part Deliveries 092114.pdf

# Mech Part Deliveries

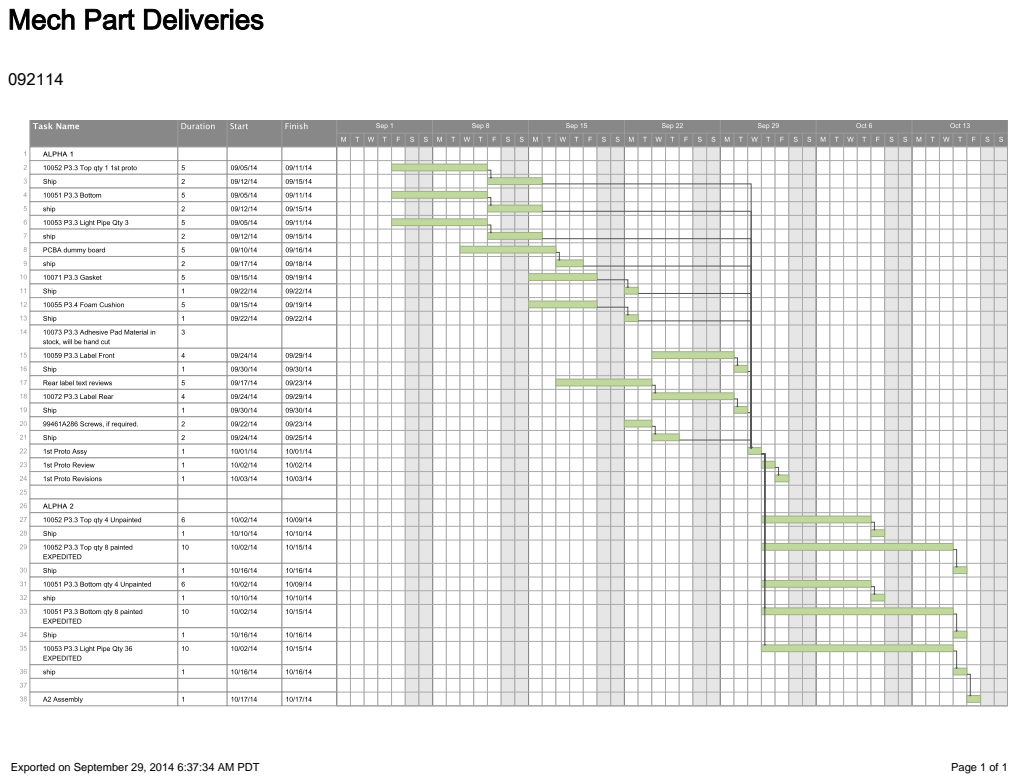
[picture p34: page 1]
Exported on September 29, 2014 6:37:34 AM PDT; Page 1 of
