Hoxford/tyler-woogduh/platform/dongle/ti/rev03/board.c

//*****************************************************************************
// Copyright (c) 2014 Texas Instruments Incorporated.  All rights reserved.
// Software License Agreement
// 
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
//   Redistributions of source code must retain the above copyright
//   notice, this list of conditions and the following disclaimer.
// 
//   Redistributions in binary form must reproduce the above copyright
//   notice, this list of conditions and the following disclaimer in the
//   documentation and/or other materials provided with the  
//   distribution.
// 
//   Neither the name of Texas Instruments Incorporated nor the names of
//   its contributors may be used to endorse or promote products derived
//   from this software without specific prior written permission.
// 
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
// This file was automatically generated by the Tiva C Series PinMux Utility
// Version: 1.0.4
//
//*****************************************************************************

#ifndef __BOARD_C__
#define __BOARD_C__
/******************************************************************************
* includes ////////////////////////////////////////////////////////////////////////////////////////////////////////////////////////////////////////////////////
******************************************************************************/
#include "file.h"
#include <stdint.h>
#include <stdbool.h>
#include <stdio.h>
#include <string.h>
#include <xdc/runtime/Types.h>
#include <ti/sysbios/BIOS.h>
#include "inc/hw_types.h"
#include "inc/hw_memmap.h"
#include "inc/hw_nvic.h"
#include "inc/hw_gpio.h"
#include "inc/hw_sysctl.h"
#include "inc/hw_uart.h"
#include "driverlib/adc.h"
#include "driverlib/debug.h"
#include "driverlib/gpio.h"
#include "driverlib/i2c.h"
#include "driverlib/pin_map.h"
#include "driverlib/rom.h"
#include "driverlib/rom_map.h"
#include "driverlib/ssi.h"
#include "driverlib/sysctl.h"
#include "driverlib/timer.h"
#include "driverlib/uart.h"
#include "driverlib/usb.h"
#include "driverlib/udma.h"
//USB Lib inc
#ifdef USE_USBLIB
  #include "usblib/usblib.h"
  #include "usblib/usb-ids.h"
  #include "usblib/device/usbdevice.h"
  #include "usblib/device/usbdbulk.h"
#endif //#ifdef USE_USBLIB
//end USB Lib inc

#include "utils_inc/error_codes.h"
#include "utils_inc/proj_debug.h"

#include "inc/tm4c1233h6pm.h"
#include "board.h"


/******************************************************************************
* defines /////////////////////////////////////////////////////////////////////////////////////////////////////////////////////////////////////////////////////
******************************************************************************/
//radio uart DMA defines
#define USE_RADIO_UART_DMA      false
#define DMA_RDIO_RCV_BUFFSZ     1024
#define NUM_DMA_RDIO_RCV_BUFFS  3

#define DMA_RDIO_TX_BUFFSZ             256
#define NUM_DMA_RDIO_TX_BUFFS          3
#define RADIO_TX_UDMA_CHANNEL_BITMASK  0b00000000100000000000000000000000
#define RADIO_RX_UDMA_CHANNEL_BITMASK  0b00000000010000000000000000000000

//USB defines
#define USB_THREE_SEC_DATA_CONN_DELAY   3000

//HW delay defines
//#define HW_DELAY_MSDIV 1000
#define HW_DELAY_MSDIV 3000

/******************************************************************************
* variables ///////////////////////////////////////////////////////////////////////////////////////////////////////////////////////////////////////////////////
******************************************************************************/
//UART variables
volatile bool bIs_usart_data = false;
volatile bool bIs_uart_done = false;
volatile uint32_t uiCTS_int_status = 0;
volatile bool bIs_usart_timeout = false;
volatile bool bRdio_track_timeout_tick = false;
volatile uint32_t uiRdio_timeout_tick = 0;
volatile int  iNum_cmnd_buffs = 0;
volatile int  iNum_cts_procs = 0;
volatile bool bIs_DMA_transmit_in_process = false;

///////////////////////////////////////////////////////////////////////////////
//USB variables
bool bIs_USB_Enabled = false;
volatile bool bIs_USB_sof = false;
#ifdef USE_USBLIB
//*****************************************************************************
//
// The size of the transmit and receive buffers used. 256 is chosen pretty
// much at random though the buffer should be at least twice the size of
// a maximum-sized USB packet.
//
//*****************************************************************************
#define BULK_BUFFER_SIZE 256

extern uint32_t RxHandler(void *pvCBData, uint32_t ui32Event,
                          uint32_t ui32MsgValue, void *pvMsgData);
extern uint32_t TxHandler(void *pvi32CBData, uint32_t ui32Event,
                          uint32_t ui32MsgValue, void *pvMsgData);

extern const tUSBBuffer g_sTxBuffer;
extern const tUSBBuffer g_sRxBuffer;
extern tUSBDBulkDevice g_sBulkDevice;
extern uint8_t g_pui8USBTxBuffer[];
extern uint8_t g_pui8USBRxBuffer[];

//*****************************************************************************
//
// The languages supported by this device.
//
//*****************************************************************************
const uint8_t g_pui8LangDescriptor[] =
{
    4,
    USB_DTYPE_STRING,
    USBShort(USB_LANG_EN_US)
};

//*****************************************************************************
//
// The manufacturer string.
//
//*****************************************************************************
const uint8_t g_pui8ManufacturerString[] =
{
    (17 + 1) * 2,
    USB_DTYPE_STRING,
    'T', 0, 'e', 0, 'x', 0, 'a', 0, 's', 0, ' ', 0, 'I', 0, 'n', 0, 's', 0,
    't', 0, 'r', 0, 'u', 0, 'm', 0, 'e', 0, 'n', 0, 't', 0, 's', 0,
};

//*****************************************************************************
//
// The product string.
//
//*****************************************************************************
const uint8_t g_pui8ProductString[] =
{
    (19 + 1) * 2,
    USB_DTYPE_STRING,
    'G', 0, 'e', 0, 'n', 0, 'e', 0, 'r', 0, 'i', 0, 'c', 0, ' ', 0, 'B', 0,
    'u', 0, 'l', 0, 'k', 0, ' ', 0, 'D', 0, 'e', 0, 'v', 0, 'i', 0, 'c', 0,
    'e', 0
};

//*****************************************************************************
//
// The serial number string.
//
//*****************************************************************************
const uint8_t g_pui8SerialNumberString[] =
{
    (8 + 1) * 2,
    USB_DTYPE_STRING,
    '1', 0, '2', 0, '3', 0, '4', 0, '5', 0, '6', 0, '7', 0, '8', 0
};

//*****************************************************************************
//
// The data interface description string.
//
//*****************************************************************************
const uint8_t g_pui8DataInterfaceString[] =
{
    (19 + 1) * 2,
    USB_DTYPE_STRING,
    'B', 0, 'u', 0, 'l', 0, 'k', 0, ' ', 0, 'D', 0, 'a', 0, 't', 0,
    'a', 0, ' ', 0, 'I', 0, 'n', 0, 't', 0, 'e', 0, 'r', 0, 'f', 0,
    'a', 0, 'c', 0, 'e', 0
};

//*****************************************************************************
//
// The configuration description string.
//
//*****************************************************************************
const uint8_t g_pui8ConfigString[] =
{
    (23 + 1) * 2,
    USB_DTYPE_STRING,
    'B', 0, 'u', 0, 'l', 0, 'k', 0, ' ', 0, 'D', 0, 'a', 0, 't', 0,
    'a', 0, ' ', 0, 'C', 0, 'o', 0, 'n', 0, 'f', 0, 'i', 0, 'g', 0,
    'u', 0, 'r', 0, 'a', 0, 't', 0, 'i', 0, 'o', 0, 'n', 0
};

//*****************************************************************************
//
// The descriptor string table.
//
//*****************************************************************************
const uint8_t * const g_ppui8StringDescriptors[] =
{
    g_pui8LangDescriptor,
    g_pui8ManufacturerString,
    g_pui8ProductString,
    g_pui8SerialNumberString,
    g_pui8DataInterfaceString,
    g_pui8ConfigString
};

#define NUM_STRING_DESCRIPTORS (sizeof(g_ppui8StringDescriptors) /                \
                                sizeof(uint8_t *))

//*****************************************************************************
//
// The bulk device initialization and customization structures. In this case,
// we are using USBBuffers between the bulk device class driver and the
// application code. The function pointers and callback data values are set
// to insert a buffer in each of the data channels, transmit and receive.
//
// With the buffer in place, the bulk channel callback is set to the relevant
// channel function and the callback data is set to point to the channel
// instance data. The buffer, in turn, has its callback set to the application
// function and the callback data set to our bulk instance structure.
//
//*****************************************************************************

tUSBDBulkDevice g_sBulkDevice =
{
    USB_VID_TI_1CBE,
    USB_PID_BULK,
    500,
    USB_CONF_ATTR_SELF_PWR,
    USBBufferEventCallback,
    (void *)&g_sRxBuffer,
    USBBufferEventCallback,
    (void *)&g_sTxBuffer,
    g_ppui8StringDescriptors,
    NUM_STRING_DESCRIPTORS
};

//*****************************************************************************
//
// Receive buffer (from the USB perspective).
//
//*****************************************************************************
uint8_t g_pui8USBRxBuffer[BULK_BUFFER_SIZE];
uint8_t g_pui8RxBufferWorkspace[USB_BUFFER_WORKSPACE_SIZE];
const tUSBBuffer g_sRxBuffer =
{
    false,                           // This is a receive buffer.
    RxHandler,                       // pfnCallback
    (void *)&g_sBulkDevice,          // Callback data is our device pointer.
    USBDBulkPacketRead,              // pfnTransfer
    USBDBulkRxPacketAvailable,       // pfnAvailable
    (void *)&g_sBulkDevice,          // pvHandle
    g_pui8USBRxBuffer,               // pi8Buffer
    BULK_BUFFER_SIZE,                // ui32BufferSize
    g_pui8RxBufferWorkspace          // pvWorkspace
};

//*****************************************************************************
//
// Transmit buffer (from the USB perspective).
//
//*****************************************************************************
uint8_t g_pui8USBTxBuffer[BULK_BUFFER_SIZE];
uint8_t g_pui8TxBufferWorkspace[USB_BUFFER_WORKSPACE_SIZE];
const tUSBBuffer g_sTxBuffer =
{
    true,                            // This is a transmit buffer.
    TxHandler,                       // pfnCallback
    (void *)&g_sBulkDevice,          // Callback data is our device pointer.
    USBDBulkPacketWrite,             // pfnTransfer
    USBDBulkTxPacketAvailable,       // pfnAvailable
    (void *)&g_sBulkDevice,          // pvHandle
    g_pui8USBTxBuffer,               // pi8Buffer
    BULK_BUFFER_SIZE,                // ui32BufferSize
    g_pui8TxBufferWorkspace          // pvWorkspace
};
#endif //#ifdef USE_USBLIB
//end USB variables
///////////////////////////////////////////////////////////////////////////////

//Waverform timer variables
volatile bool bWaveform_timer_tick = false;

//adc variables

//HW delay variables
uint32_t uiHW_delay_Sys_speed_1ms_ticks = 0;

//system speed variables
uint32_t uiCurrent_sys_speed = 0;
uint32_t uiSystem_Speed_Freq[INEEDMD_CPU_SPEED_INDEX_COUNT] =
{
  0,         //INEEDMD_CPU_SPEED_NOT_SET
  80000000,  //INEEDMD_CPU_SPEED_FULL_EXTERNAL,
  40000000,  //INEEDMD_CPU_SPEED_HALF_EXTERNAL,
  20000000,  //INEEDMD_CPU_SPEED_QUARTER_EXTERNAL,
  80000000,  //INEEDMD_CPU_SPEED_FULL_INTERNAL,
  40000000,  //INEEDMD_CPU_SPEED_HALF_INTERNAL,
  40000000,  //INEEDMD_CPU_SPEED_HALF_INTERNAL_OSC,
  500000,    //INEEDMD_CPU_SPEED_SLOW_INTERNAL,
  30000      //INEEDMD_CPU_SPEED_REALLY_SLOW,
};

//Total time running variables
volatile uintmax_t uiRunClock_Sys_ms_count = 0;
volatile uint16_t  uiRunClock_Sys_ms       = 0;
volatile uint16_t  uiRunClock_Sys_sec      = 0;
volatile uint16_t  uiRunClock_Sys_min      = 0;
volatile uint16_t  uiRunClock_Sys_hour     = 0;
volatile uint16_t  uiRunClock_Sys_days     = 0;
volatile uint16_t  uiRunClock_Sys_years    = 0;

//Batt measure variables
bool bIs_Batt_measACD_enabled = false;

//LED and LED I2C variables
bool bIs_LEDI2D_Enabled = false;

//System sleep variables
bool bSystem_sleep_timer_expired = false;

// BIOS variables
bool bIs_BIOS_running = false;

//*****************************************************************************
// The control table used by the uDMA controller. This table must be aligned to a 1024 byte boundary.
//*****************************************************************************
#if defined(ewarm)
#pragma data_alignment=1024
uint8_t ui8ControlTable[1024];
#elif defined(ccs)
#pragma DATA_ALIGN(ui8ControlTable, 1024)
uint8_t ui8ControlTable[1024];
#else
uint8_t ui8ControlTable[1024] __attribute__ ((aligned(1024)));
#endif

/******************************************************************************
* external variables //////////////////////////////////////////////////////////////////////////////////////////////////////////////////////////////////////////
******************************************************************************/

/******************************************************************************
* enums ///////////////////////////////////////////////////////////////////////////////////////////////////////////////////////////////////////////////////////
******************************************************************************/
typedef enum
{
  RB_NONE,
  RB_IWRAP_CMND,
  RB_INEEDMD_CMND,
  RB_OTHER
}eRcv_Buff_type;

eSYSTEM_SPEED_INDEX eCurrent_sys_speed_index = INEEDMD_CPU_SPEED_NOT_SET;
/******************************************************************************
* structures //////////////////////////////////////////////////////////////////////////////////////////////////////////////////////////////////////////////////
******************************************************************************/
//DMA RX struct
typedef struct
{
  bool bBuff_free;
  eRcv_Buff_type eApp_Buff_Dest;
  uint8_t uiRcv_Buff[DMA_RDIO_RCV_BUFFSZ];
  uint16_t uiRcv_data_len;
}tDMA_RX_struct;  //dma transmit data struct

//DMA TX struct
typedef struct
{
  bool bBuff_free;
  uint8_t uiTx_Buff[DMA_RDIO_TX_BUFFSZ];
  uint16_t uiTx_data_len;
  bool bTx_done;
}tDMA_TX_struct;  //dma transmit data struct

#if USE_RADIO_UART_DMA == true
tDMA_RX_struct tDMA_RX_struct_array[NUM_DMA_RDIO_RCV_BUFFS];
tDMA_TX_struct tDMA_TX_struct_array[NUM_DMA_RDIO_TX_BUFFS];
#endif

//UART parameters
UART_Handle sRadio_UART_handle;
UART_Params sRadio_UART_params;

//CPU frequency parameters
Types_FreqHz sCPU_freq;

//SPI parameters
SPI_Handle tSPI_ADC_handle;
SPI_Params tSPI_ADC_params;

/******************************************************************************
* external functions //////////////////////////////////////////////////////////////////////////////////////////////////////////////////////////////////////////
******************************************************************************/
extern void vIneedMD_radio_read_cb(UART_Handle sHandle, void *buf, int count);
extern void vIneedMD_radio_write_cb(UART_Handle sHandle, void *buf, int count);

//
////*****************************************************************************
//// private function declarations
////*****************************************************************************
//ERROR_CODE Radio_UART_DMA_Config(void); //configures the DMA tied to the radio UART
//void vRadio_interface_DMA_tx_service(void);
//void vRadio_interface_DMA_rcv_service(void);
//ERROR_CODE eGet_curr_DMA_fill_buff(tDMA_RX_struct ** ptDMA_curr_rx_buff);
//ERROR_CODE eBSP_Set_System_Timers(void);
//
////*****************************************************************************
//// private functions
////*****************************************************************************
///******************************************************************************
//* name: Radio_UART_DMA_Config
//* description: configures the DMA for the radio uart
//* param description:
//* return value description:
//******************************************************************************/
//ERROR_CODE Radio_UART_DMA_Config(void)
//{
//  ERROR_CODE  eEC = ER_OK;
//#if USE_RADIO_UART_DMA == true
//  int i;
//  bool bDMA_is_enabled = false;
//  uint32_t  uiDMA_mode = 0;
//
//  tDMA_RX_struct * ptFirst_DMA_RX_struct;
//
//  //init the UART DMA rcv buffers
//  for(i = 0; i < NUM_DMA_RDIO_RCV_BUFFS; i++)
//  {
//    tDMA_RX_struct_array[i].eApp_Buff_Dest = RB_NONE;
//    tDMA_RX_struct_array[i].bBuff_free       = true;
//    tDMA_RX_struct_array[i].uiRcv_data_len   = 0;
//    memset(&tDMA_RX_struct_array[i].uiRcv_Buff, 0x00, DMA_RDIO_RCV_BUFFSZ);
//  }
//
//  //init the UART DMA tx buffers
//  for(i = 0; i < NUM_DMA_RDIO_TX_BUFFS; i++)
//  {
//    tDMA_TX_struct_array[i].bBuff_free     = true;
//    tDMA_TX_struct_array[i].uiTx_data_len  = 0;
//    tDMA_TX_struct_array[i].bTx_done  = true;
//    memset(&tDMA_TX_struct_array[i].uiTx_Buff, 0x00, DMA_RDIO_TX_BUFFSZ);
//  }
//
//  //keep track of the first buffer to use
//  ptFirst_DMA_RX_struct = &tDMA_RX_struct_array[0];
//
//  // Enable the uDMA controller at the system level.  Enable it to continue
//  // to run while the processor is in sleep.
//  MAP_SysCtlPeripheralEnable(SYSCTL_PERIPH_UDMA);
//  MAP_SysCtlPeripheralSleepEnable(SYSCTL_PERIPH_UDMA);
//
//  // Enable the uDMA controller error interrupt.  This interrupt will occur
//  // if there is a bus error during a transfer.
//  MAP_IntEnable(INT_UDMAERR);
//
//  // Enable the uDMA controller.
//  MAP_uDMAEnable();
//
//  // Point at the control table to use for channel control structures.
//  MAP_uDMAControlBaseSet(ui8ControlTable);
//
//  //
//  // Set both the TX and RX trigger thresholds to 4.  This will be used by
//  // the uDMA controller to signal when more data should be transferred.  The
//  // uDMA TX and RX channels will be configured so that it can transfer 4
//  // bytes in a burst when the UART is ready to transfer more data.
//  //
////  MAP_UARTFIFOLevelSet(INEEDMD_RADIO_UART, UART_FIFO_TX4_8, UART_FIFO_RX4_8);
//  MAP_UARTFIFOLevelSet(INEEDMD_RADIO_UART, UART_FIFO_TX7_8, UART_FIFO_RX1_8);
//
//  // Enable the uDMA interface for both TX and RX channels.
//  MAP_UARTDMAEnable(INEEDMD_RADIO_UART, UART_DMA_RX | UART_DMA_TX);
//
//  // Enable the UART peripheral interrupts.  Note that no UART interrupts
//  // were enabled, but the uDMA controller will cause an interrupt on the
//  // UART interrupt signal when a uDMA transfer is complete.
//  //
////  MAP_IntEnable(INEEDMD_RADIO_UART_INT);
////  MAP_UARTIntEnable(INEEDMD_RADIO_UART, UART_INT_RX | UART_INT_RT | UART_INT_CTS);
//  iRadio_interface_int_enable();
//
//  //
//  //configure the Radio UART receive DMA
//  //
//
//  // Put the attributes in a known state for the uDMA RADIO UART RX channel.  These
//  // should already be disabled by default.
//  //
//  MAP_uDMAChannelAttributeDisable(UDMA_CHANNEL_RADIO_RX,
//                                  UDMA_ATTR_USEBURST |
//                                  UDMA_ATTR_HIGH_PRIORITY |
//                                  UDMA_ATTR_REQMASK);
//
//  MAP_uDMAChannelAttributeEnable(UDMA_CHANNEL_RADIO_RX, UDMA_ATTR_HIGH_PRIORITY);
//
//  // Configure the control parameters for the primary control structure for
//  // the UART RX channel.  The transfer data size is 8 bits, the
//  // source address does not increment since it will be reading from a
//  // register.  The destination address increment is byte 8-bit bytes.  The
//  // arbitration size is set to 4 to match the RX FIFO trigger threshold.
//  // The uDMA controller will use a 4 byte burst transfer if possible.
//  MAP_uDMAChannelControlSet(UDMA_CHANNEL_RADIO_RX | UDMA_PRI_SELECT,
//                            UDMA_SIZE_8 | UDMA_SRC_INC_NONE | UDMA_DST_INC_8 |
//                            UDMA_ARB_1);
//
//  // Set up the transfer parameters for the UART RX primary control
//  // structure.
//  MAP_uDMAChannelTransferSet(UDMA_CHANNEL_RADIO_RX | UDMA_PRI_SELECT,
//                             UDMA_MODE_BASIC,
//                             (void *)(INEEDMD_RADIO_UART + UART_O_DR),
//                             ptFirst_DMA_RX_struct->uiRcv_Buff, DMA_RDIO_RCV_BUFFSZ);
//
//  ptFirst_DMA_RX_struct->bBuff_free = false;
//
//  //Enable the Radio DMA UART receive channel
//  MAP_uDMAChannelEnable(UDMA_CHANNEL_RADIO_RX);
//
//  //
//  //configure the Radio UART transmit DMA
//  //
//
//  // Put the attributes in a known state for the uDMA Radio UART TX channel.  These
//  // should already be disabled by default.
//  MAP_uDMAChannelAttributeDisable(UDMA_CHANNEL_RADIO_TX,
//                                  UDMA_ATTR_HIGH_PRIORITY |
//                                  UDMA_ATTR_REQMASK);
//
//  // Set the USEBURST attribute for the uDMA UART TX channel.  This will
//  // force the controller to always use a burst when transferring data from
//  // the TX buffer to the UART.
////  MAP_uDMAChannelAttributeEnable(UDMA_CHANNEL_RADIO_TX, UDMA_ATTR_USEBURST);
//  MAP_uDMAChannelAttributeEnable(UDMA_CHANNEL_RADIO_TX, UDMA_ATTR_HIGH_PRIORITY);
//
//  // Configure the control parameters for the Radio UART TX.  The uDMA UART TX
//  // channel is used to transfer a block of data from a buffer to the UART.
//  // The data size is 8 bits.  The source address increment is 8-bit bytes
//  // since the data is coming from a buffer.  The destination increment is
//  // none since the data is to be written to the UART data register.  The
//  // arbitration size is set to 4, which matches the UART TX FIFO trigger
//  // threshold.
//  MAP_uDMAChannelControlSet(UDMA_CHANNEL_RADIO_TX | UDMA_PRI_SELECT,
//                            UDMA_SIZE_8 | UDMA_SRC_INC_8 | UDMA_DST_INC_NONE |
//                            UDMA_ARB_1);
//
//  //Performing setup checks
//  //
//  //check if the DMA's are enabled
//  if(eEC == ER_OK)
//  {
//    //check if RX DMA is enabled
//    bDMA_is_enabled = MAP_uDMAChannelIsEnabled(UDMA_CHANNEL_RADIO_RX);
//    if(bDMA_is_enabled == false)
//    {
//      eEC = ER_NOT_ENABLED;
//    }
//    else
//    {
//      //todo: this check may not be needed since we have nothing to send yet
////      //check if the TX DMA is enabled
////      bDMA_is_enabled = MAP_uDMAChannelIsEnabled(UDMA_CHANNEL_RADIO_TX);
////      if(bDMA_is_enabled == false)
////      {
////        eEC = ER_NOT_ENABLED;
////      }
////      else
////      {
//        eEC = ER_OK;
////      }
//    }
//  }
//
//  //check the DMA's mode
//  if(eEC == ER_OK)
//  {
//    //check RX DMA mode
//    uiDMA_mode = ROM_uDMAChannelModeGet((UDMA_CHANNEL_RADIO_RX | UDMA_PRI_SELECT));
//    if((uiDMA_mode && UDMA_MODE_BASIC) != UDMA_MODE_BASIC)
//    {
//      eEC = ER_MODE;
//    }
//    else
//    {
//      //todo: this check may not be needed since we have nothing to send yet
////      //check if the TX DMA mode
////      uiDMA_mode = ROM_uDMAChannelModeGet((UDMA_CHANNEL_RADIO_TX | UDMA_PRI_SELECT));
////      if((uiDMA_mode && UDMA_MODE_BASIC) != UDMA_MODE_BASIC)
////      {
////        eEC = ER_MODE;
////      }
////      else
////      {
//        eEC = ER_OK;
////      }
//    }
//  }
//
//  if(eEC == ER_OK)
//  {
//    //set the UART using dma control variable
//    bIs_Radio_UART_using_dma = true;
//  }
//#elif  USE_RADIO_UART_DMA == false
//  eEC = ER_NOT_ENABLED;
//#endif //USE_RADIO_UART_DMA
//  return eEC;
//}
//
////*****************************************************************************
//// name:
//// description:
//// param description:
//// return value description:
////*****************************************************************************
//void vRadio_interface_DMA_tx_service(void)
//{
//#if USE_RADIO_UART_DMA == true
//  int index;
//  tDMA_TX_struct * ptDMA_tx_buff = NULL;
//
//  //cycle through the buffers and find the one that was transmitted
//  for(index = 0; index < NUM_DMA_RDIO_TX_BUFFS; index++)
//  {
//    ptDMA_tx_buff = &tDMA_TX_struct_array[index];
//
//    //check if the buffer is NOT free, therefore filled for TX
//    if(ptDMA_tx_buff->bBuff_free == false)
//    {
//      ptDMA_tx_buff->bBuff_free = true;
//      memset(ptDMA_tx_buff->uiTx_Buff, 0x00, DMA_RDIO_TX_BUFFSZ);
//    }else{/*nothing*/}
//  }
//#endif
//}
//
////*****************************************************************************
//// name:
//// description:
//// param description:
//// return value description:
////*****************************************************************************
//void vRadio_interface_DMA_rcv_service(void)
//{
//#define DEBUG_vRadio_interface_DMA_rcv_service
//#ifdef DEBUG_vRadio_interface_DMA_rcv_service
//  #define  vDEBUG_DMA_RCV_SRVC  vDEBUG
//#else
//  #define vDEBUG_DMA_RCV_SRVC(a)
//#endif
//#if USE_RADIO_UART_DMA == true
//  ERROR_CODE eEC = ER_FAIL;
//  int index;
//  tDMA_RX_struct * ptDMA_que_buff = NULL;
//
//  //cycle through the buffers and find the one that was filled
//  for(index = 0; index < NUM_DMA_RDIO_RCV_BUFFS; index++)
//  {
//    ptDMA_que_buff = &tDMA_RX_struct_array[index];
//
//    //check if the buffer is NOT free, therefore potentially was filled via DMA
//    if(ptDMA_que_buff->bBuff_free == false)
//    {
//      //check if the buffer was NOT already queued for an app to review
//      if(ptDMA_que_buff->eApp_Buff_Dest == RB_NONE)
//      {
//        eEC = eIs_radio_in_cmnd_mode();
//        if(eEC == ER_TRUE)
//        {
//          ptDMA_que_buff->eApp_Buff_Dest = RB_IWRAP_CMND;
//          eEC = ER_OK;
//          continue;
//        }
//        else
//        {
//          eEC = ER_OK;
//        }
//
//        if(ptDMA_que_buff->uiRcv_Buff[0] == 0x9C)
//        {
//          ptDMA_que_buff->eApp_Buff_Dest = RB_INEEDMD_CMND;
//          continue;
//        }
//      }else{/*nothing*/}
//    }else{/*nothing*/}
//  }
//
//  //check the error code to determine if none of the buffers were serviced
//  if(eEC == ER_FAIL)
//  {
//    //There is no data to send to the application
//    eEC = ER_NODATA;
//  }else{/*nothing*/}
//
//  //check the error status and proceed accordingly
//  if(eEC == ER_OK)
//  {
////    MAP_uDMAChannelDisable(UDMA_CHANNEL_RADIO_RX);
//
//    //preset the error code
//    eEC = ER_FAIL;
//
//    //cycle the buffers and fine a free one to assign to the DMA
//    for(index = 0; index < NUM_DMA_RDIO_RCV_BUFFS; index++)
//    {
//      ptDMA_que_buff = &tDMA_RX_struct_array[index];
//
//      //check if the buffer is free to fill via DMA
//      if(ptDMA_que_buff->bBuff_free == true)
//      {
//        //check if the buffer was NOT already queued for an app to review
//        if(ptDMA_que_buff->eApp_Buff_Dest == RB_NONE)
//        {
//          //set the DMA RX to the next rcv buffer
//          ROM_uDMAChannelTransferSet(UDMA_CHANNEL_UART1RX | UDMA_PRI_SELECT,
//                                     UDMA_MODE_BASIC,
//                                     (void *)(INEEDMD_RADIO_UART + UART_O_DR),
//                                     ptDMA_que_buff->uiRcv_Buff, DMA_RDIO_RCV_BUFFSZ);
//
//          //mark the buffer as in use
//          ptDMA_que_buff->bBuff_free = false;
//          MAP_uDMAChannelEnable(UDMA_CHANNEL_RADIO_RX);
//          eEC = ER_OK;
//          break;
//
//        }else{/*nothing*/}
//      }else{/*nothing*/}
//    }
//  }else{/*nothing*/}
//
//  //check if a free buffer was not allocated
//  if(eEC == ER_FAIL)
//  {
//    eEC = ER_NO_BUFF_AVAILABLE;
//  }else{/*nothing*/}
//
//
//  //check for errors
//  if(eEC == ER_NO_BUFF_AVAILABLE)
//  {
//#ifdef DEBUG
//    // Catch no buffers available
//    vDEBUG_DMA_RCV_SRVC("Dma rcv srvc SYS HALT, no buff available");
//    while(1){};
//#else
//    //todo: perform a system reset maybe?
//#endif
//  }
//  else if(eEC == ER_NODATA)
//  {
//    //todo: need a nodata counter maybe?
//#ifdef DEBUG
//    // Catch no data available
//    vDEBUG_DMA_RCV_SRVC("Dma rcv srvc SYS HALT, no data available");
//    while(1){};
//#else
//    //todo: need a nodata counter maybe?
//#endif
//  }
//  else{/*nothing*/}
//#endif //USE_RADIO_UART_DMA
//  return;
//}
//
////*****************************************************************************
//// name:
//// description:
//// param description:
//// return value description:
////*****************************************************************************
//ERROR_CODE eGet_curr_DMA_fill_buff(tDMA_RX_struct ** ptDMA_curr_rx_buff)
//{
//  ERROR_CODE eEC = ER_FAIL;
//#if USE_RADIO_UART_DMA == true
//  int index = 0;
//  tDMA_RX_struct * ptDMA_rx_buff = NULL;
//
//  //cycle through the buffers and find the one that was filled
//  for(index = 0; index < NUM_DMA_RDIO_RCV_BUFFS; index++)
//  {
//    ptDMA_rx_buff = &tDMA_RX_struct_array[index];
//
//    //check if the buffer is NOT free, therefore potentially was filled via DMA
//    if(ptDMA_rx_buff->bBuff_free == false)
//    {
//      //check if the buffer was NOT already queued for an app to review
//      if(ptDMA_rx_buff->eApp_Buff_Dest == RB_NONE)
//      {
//        *ptDMA_curr_rx_buff = ptDMA_rx_buff;
//        eEC = ER_OK;
//      }else{/*nothing*/}
//    }else{/*nothing*/}
//  }
//#endif
//  return eEC;
//}
//
//
///******************************************************************************
//* name: eBSP_Set_System_Timers
//* description: private function that sets all the timer values. It should be
//*   used during system initalization and when ever the sys speed changes.
//* param description: none
//* return value description:
//******************************************************************************/
//ERROR_CODE eBSP_Set_System_Timers(void)
//{
//  ERROR_CODE eEC = ER_OK;
//
//  eBSP_Systick_Init();
//
//  //todo: add more functions that require the current sys clock value
//
//  return eEC;
//}
////*****************************************************************************
//
//// external functions
////*****************************************************************************
////
////a processor loop wait timer.  The number of cycles are calculated from the frequency of the main clock.
////
//void wait_time (unsigned int tenths_of_seconds)
//{
//	MAP_SysCtlDelay(( MAP_SysCtlClockGet() / 30  )*tenths_of_seconds );
//}
//
//
////
////a 2 BYTE i2C WRITE ROUTINE.  No error checking is implemented
////
//void write_2_byte_i2c (unsigned char device_id, unsigned char first_byte, unsigned char second_byte)
//
//{
//
//  I2CMasterSlaveAddrSet(I2C0_BASE, device_id, false);
//    I2CMasterDataPut(I2C0_BASE, first_byte);
//    I2CMasterControl(I2C0_BASE, I2C_MASTER_CMD_BURST_SEND_START);
//    while(I2CMasterBusy(I2C0_BASE));
//    I2CMasterDataPut(I2C0_BASE, second_byte);
//    I2CMasterControl(I2C0_BASE, I2C_MASTER_CMD_BURST_SEND_FINISH);
//    while(I2CMasterBusy(I2C0_BASE));
//
//}

//*****************************************************************************
// name:
// description: sets the system speed according to the passed in parameter
// param description:
// return value description:
//*****************************************************************************
ERROR_CODE set_system_speed (eSYSTEM_SPEED_INDEX eHow_Fast)
{
//#define DEBUG_set_system_speed
#ifdef DEBUG_set_system_speed
  #define  vDEBUG_SET_SYS_SPEED  vDEBUG
#else
  #define vDEBUG_SET_SYS_SPEED(a)
#endif
  ERROR_CODE eEC = ER_OK;
  uint32_t uiRCC_reg = 0;

  if(eCurrent_sys_speed_index == INEEDMD_CPU_SPEED_NOT_SET)
  {
    BIOS_getCpuFreq(&sCPU_freq);
    uiCurrent_sys_speed = (uint32_t)sCPU_freq.lo;

    //determine if the clock source is internal or external
    uiRCC_reg = HWREG(SYSCTL_RCC);
    if((uiRCC_reg & SYSCTL_RCC_MOSCDIS) == SYSCTL_RCC_MOSCDIS)
    {
      //clock source is internal
      //
      //set the sys speed index to the proper value
      if(uiCurrent_sys_speed == uiSystem_Speed_Freq[INEEDMD_CPU_SPEED_FULL_INTERNAL])
      {
        eCurrent_sys_speed_index = INEEDMD_CPU_SPEED_FULL_INTERNAL;
      }
      else if((uiCurrent_sys_speed == uiSystem_Speed_Freq[INEEDMD_CPU_SPEED_HALF_INTERNAL]) |
              (uiCurrent_sys_speed == uiSystem_Speed_Freq[INEEDMD_CPU_SPEED_HALF_INTERNAL_OSC]))
      {
        //determine if the internal oscillator being used is the PISOC
        if((uiRCC_reg & SYSCTL_RCC_OSCSRC_INT) == SYSCTL_RCC_OSCSRC_INT)
        {
          //clock source is PISOC
          //
          eCurrent_sys_speed_index = INEEDMD_CPU_SPEED_HALF_INTERNAL_OSC;
        }
        else
        {
          //clock source is Main internal
          //
          eCurrent_sys_speed_index = INEEDMD_CPU_SPEED_HALF_INTERNAL;
        }
      }
      else if(uiCurrent_sys_speed == uiSystem_Speed_Freq[INEEDMD_CPU_SPEED_SLOW_INTERNAL])
      {
        eCurrent_sys_speed_index = INEEDMD_CPU_SPEED_SLOW_INTERNAL;
      }
      else if(uiCurrent_sys_speed == uiSystem_Speed_Freq[INEEDMD_CPU_SPEED_REALLY_SLOW])
      {
        eCurrent_sys_speed_index = INEEDMD_CPU_SPEED_REALLY_SLOW;
      }
      else
      {
        vDEBUG_SET_SYS_SPEED("Sys speed SYS HALT, unknown system speed");
        while(1){};
      }
    }
    else
    {
      //Clock source is external
      //
      //set the sys speed index to the proper value
      if(uiCurrent_sys_speed == uiSystem_Speed_Freq[INEEDMD_CPU_SPEED_FULL_EXTERNAL])
      {
        eCurrent_sys_speed_index = INEEDMD_CPU_SPEED_FULL_EXTERNAL;
      }
      else if(uiCurrent_sys_speed == uiSystem_Speed_Freq[INEEDMD_CPU_SPEED_HALF_EXTERNAL])
      {
        eCurrent_sys_speed_index = INEEDMD_CPU_SPEED_HALF_EXTERNAL;
      }
      else if(uiCurrent_sys_speed == uiSystem_Speed_Freq[INEEDMD_CPU_SPEED_QUARTER_EXTERNAL])
      {
        eCurrent_sys_speed_index = INEEDMD_CPU_SPEED_QUARTER_EXTERNAL;
      }
      else
      {
        vDEBUG_SET_SYS_SPEED("Sys speed SYS HALT, unknown system speed");
        while(1){};
      }
    }
  }

  //check if the system speed needs to be chaged if it is not at what is being requested
  if(eCurrent_sys_speed_index != eHow_Fast)
  {
    switch (eHow_Fast)
    {
      case INEEDMD_CPU_SPEED_FULL_EXTERNAL:
        //WARNING - do not use on first board rev!!!!
        //turn on the external oscillator
//        MAP_GPIOPinWrite (GPIO_PORTD_BASE, INEEDMD_PORTD_XTAL_ENABLE, INEEDMD_PORTD_XTAL_ENABLE);
        GPIO_write(EK_TM4C123GXL_XTAL_ENABLE, INEEDMD_XTAL_ENABLE_PIN_SET);
        // let it stabalise
        MAP_SysCtlDelay(1000);
        //setting to run on the PLL from the external xtal and switch off the internal oscillator this gives us an 80Mhz clock
//        SysCtlClockSet( SYSCTL_SYSDIV_2_5 | SYSCTL_USE_PLL | SYSCTL_OSC_MAIN | SYSCTL_XTAL_16MHZ );
        sCPU_freq.lo = uiSystem_Speed_Freq[eHow_Fast];
        sCPU_freq.hi = 0;
        BIOS_setCpuFreq(&sCPU_freq);

        vDEBUG_SET_SYS_SPEED("Sys speed, INEEDMD_CPU_SPEED_FULL_EXTERNAL");
        break;

      case INEEDMD_CPU_SPEED_HALF_EXTERNAL:
        //WARNING - do not use on first board rev!!!!
        //turn on the external oscillator
//        MAP_GPIOPinWrite (GPIO_PORTD_BASE, INEEDMD_PORTD_XTAL_ENABLE, INEEDMD_PORTD_XTAL_ENABLE);
        GPIO_write(EK_TM4C123GXL_XTAL_ENABLE, INEEDMD_XTAL_ENABLE_PIN_SET);
        // let it stabalise
        MAP_SysCtlDelay(1000);
        //setting to run on the PLL from the external xtal and switch off the internal oscillator this gives us an 80Mhz clock
//        SysCtlClockSet( SYSCTL_SYSDIV_5 | SYSCTL_USE_PLL | SYSCTL_OSC_MAIN | SYSCTL_XTAL_16MHZ);
        sCPU_freq.lo = uiSystem_Speed_Freq[eHow_Fast];
        sCPU_freq.hi = 0;
        BIOS_setCpuFreq(&sCPU_freq);

        vDEBUG_SET_SYS_SPEED("Sys speed, INEEDMD_CPU_SPEED_HALF_EXTERNAL");

        break;

      case INEEDMD_CPU_SPEED_QUARTER_EXTERNAL:
        //WARNING - do not use on first board rev!!!!
        //turn on the external oscillator
//        MAP_GPIOPinWrite (GPIO_PORTD_BASE, INEEDMD_PORTD_XTAL_ENABLE, INEEDMD_PORTD_XTAL_ENABLE);
        GPIO_write(EK_TM4C123GXL_XTAL_ENABLE, INEEDMD_XTAL_ENABLE_PIN_SET);
        // let it stabalise
        MAP_SysCtlDelay(1000);
        //setting to run on the PLL from the external xtal and switch off the internal oscillator this gives us an 80Mhz clock
//        SysCtlClockSet( SYSCTL_SYSDIV_10 | SYSCTL_USE_PLL | SYSCTL_OSC_MAIN | SYSCTL_XTAL_16MHZ);(uint32_t)sCPU_freq.lo = uiSystem_Speed_Freq[eHow_Fast];
        sCPU_freq.lo = uiSystem_Speed_Freq[eHow_Fast];
        sCPU_freq.hi = 0;
        BIOS_setCpuFreq(&sCPU_freq);

        vDEBUG_SET_SYS_SPEED("Sys speed, INEEDMD_CPU_SPEED_QUARTER_EXTERNAL");

        break;

      case INEEDMD_CPU_SPEED_FULL_INTERNAL:
        //setting to run on the PLL from the internal clock and switch off the external xtal pads and pin this gives us an 80 Mhz clock
//        SysCtlClockSet( SYSCTL_SYSDIV_2_5 | SYSCTL_USE_PLL | SYSCTL_OSC_INT | SYSCTL_MAIN_OSC_DIS);
        sCPU_freq.lo = uiSystem_Speed_Freq[eHow_Fast];
        sCPU_freq.hi = 0;
        BIOS_setCpuFreq(&sCPU_freq);
        // switch off the external oscillator
//        MAP_GPIOPinWrite (GPIO_PORTD_BASE, INEEDMD_PORTD_XTAL_ENABLE, 0x00);
        GPIO_write(EK_TM4C123GXL_XTAL_ENABLE, INEEDMD_XTAL_ENABLE_PIN_CLEAR);
        vDEBUG_SET_SYS_SPEED("Sys speed, INEEDMD_CPU_SPEED_FULL_INTERNAL");

        break;

      case INEEDMD_CPU_SPEED_HALF_INTERNAL:
        //setting to run on the  the internal OSC and switch off the external xtal pads and pin.. Setting the divider to run us at 40Mhz
//        SysCtlClockSet( SYSCTL_SYSDIV_5 | SYSCTL_USE_PLL | SYSCTL_OSC_INT | SYSCTL_MAIN_OSC_DIS);
        sCPU_freq.lo = uiSystem_Speed_Freq[eHow_Fast];
        sCPU_freq.hi = 0;
        BIOS_setCpuFreq(&sCPU_freq);
        // switch off the external oscillator
//        MAP_GPIOPinWrite (GPIO_PORTD_BASE, INEEDMD_PORTD_XTAL_ENABLE, 0x00);
        GPIO_write(EK_TM4C123GXL_XTAL_ENABLE, INEEDMD_XTAL_ENABLE_PIN_CLEAR);

        vDEBUG_SET_SYS_SPEED("Sys speed, INEEDMD_CPU_SPEED_HALF_INTERNAL");

        break;

      case INEEDMD_CPU_SPEED_HALF_INTERNAL_OSC:
        //setting to run on the  the internal OSC and switch off the external xtal pads and pin.. Setting the divider to run us at 500khz
//        SysCtlClockSet( SYSCTL_SYSDIV_1 | SYSCTL_USE_OSC | SYSCTL_OSC_INT | SYSCTL_MAIN_OSC_DIS);
        sCPU_freq.lo = uiSystem_Speed_Freq[eHow_Fast];
        sCPU_freq.hi = 0;
        BIOS_setCpuFreq(&sCPU_freq);
        // switch off the external oscillator
//        MAP_GPIOPinWrite (GPIO_PORTD_BASE, INEEDMD_PORTD_XTAL_ENABLE, 0x00);
        GPIO_write(EK_TM4C123GXL_XTAL_ENABLE, INEEDMD_XTAL_ENABLE_PIN_CLEAR);

        vDEBUG_SET_SYS_SPEED("Sys speed, INEEDMD_CPU_SPEED_HALF_INTERNAL_OSC");

        break;

      case INEEDMD_CPU_SPEED_SLOW_INTERNAL:
        //setting to run on the  the internal OSC and switch off the external xtal pads and pin.. Setting the divider to run us at 500khz
//        SysCtlClockSet( SYSCTL_SYSDIV_8 | SYSCTL_USE_OSC | SYSCTL_OSC_INT4 | SYSCTL_MAIN_OSC_DIS);
        sCPU_freq.lo = uiSystem_Speed_Freq[eHow_Fast];
        sCPU_freq.hi = 0;
        BIOS_setCpuFreq(&sCPU_freq);
        // switch off the external oscillator
//        MAP_GPIOPinWrite (GPIO_PORTD_BASE, INEEDMD_PORTD_XTAL_ENABLE, 0x00);
        GPIO_write(EK_TM4C123GXL_XTAL_ENABLE, INEEDMD_XTAL_ENABLE_PIN_CLEAR);

        vDEBUG_SET_SYS_SPEED("Sys speed, INEEDMD_CPU_SPEED_SLOW_INTERNAL");

        break;

      case INEEDMD_CPU_SPEED_REALLY_SLOW:
        //setting to run on the  the internal OSC and switch off the external xtal pads and pin.. Setting the divider to run us at 30Khz.
        //Communication is't possible.. we are in hibernation
//        SysCtlClockSet( SYSCTL_SYSDIV_1 | SYSCTL_OSC_INT30 | SYSCTL_OSC_INT | SYSCTL_MAIN_OSC_DIS);
        sCPU_freq.lo = uiSystem_Speed_Freq[eHow_Fast];
        sCPU_freq.hi = 0;
        BIOS_setCpuFreq(&sCPU_freq);
        // switch off the external oscillator
//        MAP_GPIOPinWrite (GPIO_PORTD_BASE, INEEDMD_PORTD_XTAL_ENABLE, 0x00);
        GPIO_write(EK_TM4C123GXL_XTAL_ENABLE, INEEDMD_XTAL_ENABLE_PIN_CLEAR);

        vDEBUG_SET_SYS_SPEED("Sys speed, INEEDMD_CPU_SPEED_REALLY_SLOW");

        break;

      default:
        //setting the intrnal at full speed as the default.
//        SysCtlClockSet( SYSCTL_SYSDIV_1 | SYSCTL_USE_OSC | SYSCTL_OSC_INT | SYSCTL_MAIN_OSC_DIS);
        sCPU_freq.lo = uiSystem_Speed_Freq[eHow_Fast];
        sCPU_freq.hi = 0;
        BIOS_setCpuFreq(&sCPU_freq);
        // switch off the external oscillator
//        MAP_GPIOPinWrite (GPIO_PORTD_BASE, INEEDMD_PORTD_XTAL_ENABLE, 0x00);
        GPIO_write(EK_TM4C123GXL_XTAL_ENABLE, INEEDMD_XTAL_ENABLE_PIN_CLEAR);

        vDEBUG_SET_SYS_SPEED("Sys speed, default");

        break;
    }

    //preserve the system speed
    eCurrent_sys_speed_index = eHow_Fast;
    uiCurrent_sys_speed = uiSystem_Speed_Freq[eHow_Fast];

    //reset all the functions that require the current sys speed
//    eBSP_Set_System_Timers();
    //set the system tic to compensate for the new system speed
//    eBSP_Systick_Init();
//    eBSP_LEDI2C_clock_set();
  }

  return eEC;

#undef vDEBUG_SET_SYS_SPEED
}

//
//ERROR_CODE  eGet_system_speed(uint16_t * uiSys_speed)
//{
//  ERROR_CODE eEC = ER_OK;
//
//  if(uiCurrent_sys_speed == INEEDMD_CPU_SPEED_NOT_SET)
//  {
//    *uiSys_speed = INEEDMD_CPU_SPEED_NOT_SET;
//    eEC = ER_NOT_SET;
//  }
//  else
//  {
//    *uiSys_speed = uiCurrent_sys_speed;
//    eEC = ER_OK;
//  }
//
//  return eEC;
//}
//
//void
//Set_Timer0_Sleep()
//{
//    //
//    // The Timer0 peripheral must be enabled for use.
//    //
//    SysCtlPeripheralEnable(SYSCTL_PERIPH_TIMER0);
//    //
//    // The Timer0 peripheral must be enabled for use.
//    //
////    TimerConfigure(TIMER0_BASE, TIMER_CFG_SPLIT_PAIR | TIMER_CFG_B_ONE_SHOT);
//    TimerConfigure(TIMER0_BASE, TIMER_CFG_A_ONE_SHOT);
//
//}
//
///******************************************************************************
//* name:
//* description:
//* param description:
//* return value description:
//******************************************************************************/
//ERROR_CODE  eBSP_Timer0_Int_Serivce(uint32_t uiInt_Status)
//{
//  ERROR_CODE eEC = ER_OK;
//  if((uiInt_Status & TIMER_TIMA_TIMEOUT) == TIMER_TIMA_TIMEOUT)
//  {
//    bSystem_sleep_timer_expired = true;
//  }
//
//  return eEC;
//}
//
///******************************************************************************
//* name:
//* description:
//* param description:
//* return value description:
//******************************************************************************/
//ERROR_CODE  eBSP_Did_Timer0_Expire(bool bClear_status)
//{
//  ERROR_CODE eEC = ER_FAIL;
//  bool bPrevious_System_sleep_timer_expired = bSystem_sleep_timer_expired;
//
//  if(bClear_status == true)
//  {
//    bSystem_sleep_timer_expired = false;
//  }
//
//  if(bPrevious_System_sleep_timer_expired == true)
//  {
//    eEC = ER_TRUE;
//  }
//  else
//  {
//    eEC = ER_FALSE;
//  }
//
//  return eEC;
//}
//
///******************************************************************************
//* name:
//* description: services the sys tick interrupt that is proced every ms
//* param description:
//* return value description:
//******************************************************************************/
//void vSystick_int_service(void)
//{
//  bWaveform_timer_tick = true;
//
//  if(bRdio_track_timeout_tick == true)
//  {
//    uiRdio_timeout_tick++;
//  }
//
//  uiRunClock_Sys_ms_count++;
//
//  uiRunClock_Sys_ms++;
//  if(uiRunClock_Sys_ms >= 1000)
//  {
//    uiRunClock_Sys_ms = 0;
//    uiRunClock_Sys_sec++;
//
//    if(uiRunClock_Sys_sec >= 60)
//    {
//      uiRunClock_Sys_sec = 0;
//      uiRunClock_Sys_min++;
//
//      if(uiRunClock_Sys_min >= 60)
//      {
//        uiRunClock_Sys_min = 0;
//        uiRunClock_Sys_hour++;
//
//        if(uiRunClock_Sys_hour >= 24)
//        {
//          uiRunClock_Sys_hour = 0;
//          uiRunClock_Sys_days++;
//
//          if(uiRunClock_Sys_days >= 365)
//          {
//            uiRunClock_Sys_days = 0;
//            uiRunClock_Sys_years++;
//          }else{/*do nothing*/}
//        }else{/*do nothing*/}
//      }else{/*do nothing*/}
//    }else{/*do nothing*/}
//  }else{/*do nothing*/}
//
//  //todo: add other tick variables here
//}
//
///******************************************************************************
//* name: eBSP_Get_Current_ms_count
//* description: returns in the pointer parameter the current run clock system
//*   milisecond count value. This value is the total number of milisecond ticks
//*   the system had since it was first turned on. The value can be between 0 and
//*   1.84467440737E+19 or 0x0 and 0xFFFFFFFFFFFFFFFF. The counter will reset to
//*   0 in approximatly 584,555,012 years, give or take a few millenia.
//* param description: pointer to an unsigned long long variable
//* return value description: ERROR_CODE
//******************************************************************************/
//ERROR_CODE eBSP_Get_Current_ms_count(uintmax_t * uiCurrent_ms_count)
//{
//  ERROR_CODE eEC = ER_OK;
//
//  *uiCurrent_ms_count = uiRunClock_Sys_ms_count;
//
//  return eEC;
//}
//
///******************************************************************************
//* name: eBSP_Get_Current_ms
//* description: returns in the pointer parameter the current run clock system
//*   milisecond value. The run clock milisecond is a real time clock type
//*   value. This value runs between 0 and 999 ms.
//* param description:
//* return value description:
//******************************************************************************/
//ERROR_CODE eBSP_Get_Current_ms(uint16_t * uiCurrent_ms)
//{
//  ERROR_CODE eEC = ER_OK;
//
//  *uiCurrent_ms = uiRunClock_Sys_ms;
//
//  return eEC;
//}
//
///******************************************************************************
//* name: bWaveform_did_timer_tick
//* description:
//* param description:
//* return value description:
//******************************************************************************/
//bool bWaveform_did_timer_tick(void)
//{
//  bool bDid_waveform_timer_tick = false;
//  bDid_waveform_timer_tick = bWaveform_timer_tick;
//
//  //todo: disable interrupts
//  bWaveform_timer_tick = false;
//  //todo: enable interrupts
//
//  return bDid_waveform_timer_tick;
//}
//
//void
//PowerInitFunction(void)
//{
//  // set the brown out detection registers
//
//  HWREG(SYSCTL_PBORCTL_R)=SYSCTL_PBORCTL_BOR0;
//
//  // set the LDO in sleep and deep sleep...
//
//  SysCtlLDODeepSleepSet(SYSCTL_LDO_0_90V);
//  SysCtlLDOSleepSet(SYSCTL_LDO_0_90V);
//
//  SysCtlDeepSleepPowerSet (SYSCTL_FLASH_LOW_POWER |  SYSCTL_TEMP_LOW_POWER | SYSCTL_SRAM_LOW_POWER );
//
//}
//
//void
//GPIOEnable(void)
//{
//    //
//    // Enable Peripheral Clocks
//    // These have to be switched on in order... who knew!
//    //
//    MAP_SysCtlPeripheralEnable(SYSCTL_PERIPH_GPIOA);
//    MAP_SysCtlPeripheralEnable(SYSCTL_PERIPH_GPIOB);
//    MAP_SysCtlPeripheralEnable(SYSCTL_PERIPH_GPIOC);
//    MAP_SysCtlPeripheralEnable(SYSCTL_PERIPH_GPIOD);
//    MAP_SysCtlPeripheralEnable(SYSCTL_PERIPH_GPIOE);
//    MAP_SysCtlPeripheralEnable(SYSCTL_PERIPH_GPIOF);
//
//}
//
//void
//GPIODisable(void)
//{
//    //
//    // Enable Peripheral Clocks
//    // These have to be switched on in order... who knew!
//    //
//    MAP_SysCtlPeripheralDisable(SYSCTL_PERIPH_GPIOA);
//    MAP_SysCtlPeripheralDisable(SYSCTL_PERIPH_GPIOB);
//    MAP_SysCtlPeripheralDisable(SYSCTL_PERIPH_GPIOC);
//    MAP_SysCtlPeripheralDisable(SYSCTL_PERIPH_GPIOD);
//    MAP_SysCtlPeripheralDisable(SYSCTL_PERIPH_GPIOE);
//    MAP_SysCtlPeripheralDisable(SYSCTL_PERIPH_GPIOF);
//
//}
//
////*****************************************************************************
//// name:
//// description:
//// param description:
//// return value description:
////*****************************************************************************
//ERROR_CODE BatMeasureADCEnable(void)
//{
//  ERROR_CODE eEC = ER_OK;
//  uint32_t uiData = 0;
//
//  if(bIs_Batt_measACD_enabled == false)
//  {
//    //Enable the ADC Clock
//    MAP_SysCtlPeripheralEnable(BATTERY_SYSCTL_PERIPH_ADC);
//
//    MAP_GPIOPinTypeADC(INEEDMD_BATTERY_PORT, INEEDMD_BATTERY_MEASUREMENT_IN_PIN);
//
//
//
//    MAP_ADCSequenceDisable(BATTERY_ADC, 3);
//    MAP_ADCSequenceConfigure(BATTERY_ADC, 3, ADC_TRIGGER_PROCESSOR, 0);
//    MAP_ADCSequenceStepConfigure(BATTERY_ADC, 3, 0, BATTERY_ADC_CTL_CH0 | ADC_CTL_IE | ADC_CTL_END );
//    MAP_ADCIntClear(BATTERY_ADC, 3);
//
//    MAP_ADCSequenceEnable(BATTERY_ADC, 3);
//
//    //measure the ADC to verify it was enabled
//    ADCProcessorTrigger(BATTERY_ADC, 3);
//    //
//    // Wait for conversion to be completed.
//    //
//    while(!ADCIntStatus(BATTERY_ADC, 3, false))
//    {
//      uiData++;
//    }
//    //
//    // Clear the ADC interrupt flag.
//    //
//    ADCIntClear(BATTERY_ADC, 3);
//
//    uiData = 0;
//    MAP_ADCSequenceDataGet(BATTERY_ADC, 3, &uiData);
//
//    //check returned data to determine if the batt ADC is enabled and working
//    if(uiData != 0)
//    {
//      //batt ADC working, set control and error variables
//      eEC = ER_OK;
//      bIs_Batt_measACD_enabled = true;
//    }
//    else
//    {
//      //batt ADC not working, set control and error variables
//      eEC = ER_FAIL;
//      bIs_Batt_measACD_enabled = false;
//    }
//  }
//  else
//  {
//    //batt measurement ADC alread enabled, set error code
//    eEC = ER_OK;
//  }
//
//  return eEC;
//}
//
////*****************************************************************************
//// name:
//// description:
//// param description:
//// return value description:
////*****************************************************************************
//int BatMeasureADCDisable(void)
//{
//  if(bIs_Batt_measACD_enabled == true)
//  {
//    while(!SysCtlPeripheralReady(SYSCTL_PERIPH_ADC0));
//   //Disable the ADC Clock
//    MAP_SysCtlPeripheralDisable(SYSCTL_PERIPH_ADC0);
//    bIs_Batt_measACD_enabled = false;
//  }
//  else
//  {
//    bIs_Batt_measACD_enabled = false;
//  }
//  return 1;
//}
//
///******************************************************************************
//* name: eBSP_ADCMeasureBatt
//* description: Performs the measurement of the system battery. The measurement
//*  is interrupt based so they must be enabled before calling this function.
//* param description:  uint32_t * - pointer to the variable to store the measured voltage
//* return value description:
//*   ERROR_CODE - error code return value for error compensation
//*     ER_OK - battery successfully measured
//*     ER_FAIL - battery not successfully measured
//*     ER_NOT_ENABLED - the ADC to measure the battery is not enabled
//******************************************************************************/
//ERROR_CODE eBSP_ADCMeasureBatt(uint32_t * puiBatt_voltage)
//{
//  ERROR_CODE eEC = ER_FAIL;
//  uint32_t uiData = 0;
//
//  if(bIs_Batt_measACD_enabled == true)
//  {
//    ADCProcessorTrigger(BATTERY_ADC, 3);
//    //
//    // Wait for conversion to be completed.
//    //
//    while(!ADCIntStatus(BATTERY_ADC, 3, false))
//    {
//    }
//    //
//    // Clear the ADC interrupt flag.
//    //
//    ADCIntClear(BATTERY_ADC, 3);
//    //
//    // Read ADC Value.
//    //
//    ADCSequenceDataGet(BATTERY_ADC, 3, &uiData);
//
//    if(uiData != 0)
//    {
//      *puiBatt_voltage = uiData;
//      eEC = ER_OK;
//    }
//    else
//    {
//      *puiBatt_voltage = 0;
//      eEC = ER_FAIL;
//    }
//  }
//  else
//  {
//    eEC = ER_NOT_ENABLED;
//    *puiBatt_voltage = 0;
//  }
//
//  return eEC;
//}
//

ERROR_CODE eBSP_TemperatureMeasureADCEnable(void)
{

    //uint32_t uiData;

    //Enable the ADC Clock
    MAP_SysCtlPeripheralEnable(TEMPERATURE_SYSCTL_PERIPH_ADC);

    MAP_ADCSequenceDisable(TEMPERATURE_ADC, 3);
    MAP_ADCSequenceConfigure(TEMPERATURE_ADC, 3, ADC_TRIGGER_PROCESSOR, 0);
    MAP_ADCSequenceStepConfigure(TEMPERATURE_ADC, 3, 0, TEMPERATURE_ADC_CTL | ADC_CTL_IE | ADC_CTL_END );
    MAP_ADCIntClear(TEMPERATURE_ADC, 3);

    MAP_ADCSequenceEnable(TEMPERATURE_ADC, 3);

    //MAP_ADCSequenceDataGet(BATTERY_ADC, 3, &uiData);


    return ER_OK;
}

//*****************************************************************************
// name:
// description:
// param description:
// return value description:
//*****************************************************************************
ERROR_CODE eBSP_TemperatureMeasureADCDisable(void)
{
    while(!SysCtlPeripheralReady(TEMPERATURE_SYSCTL_PERIPH_ADC));
   //Disable the ADC Clock
    MAP_SysCtlPeripheralDisable(TEMPERATURE_SYSCTL_PERIPH_ADC);
    return ER_OK;
}

////*****************************************************************************
//// name:
//// description:
//// param description:
//// return value description:
////*****************************************************************************
//bool bIs_battery_low(void)
//{
////#define DEBUG_bIs_battery_low
//#ifdef DEBUG_bIs_battery_low
//  #define  vDEBUG_IS_BATT_LOW  vDEBUG
//#else
//  #define vDEBUG_IS_BATT_LOW(a)
//#endif
//  #ifdef INEEDMD_RADIO_LOW_BATT_INTERUPT_PIN
//    uint8_t uiLow_batt;
//    bool bIs_batt_low = false;
//
//    uiLow_batt = GPIOPinRead(GPIO_PORTE_BASE, INEEDMD_RADIO_LOW_BATT_INTERUPT_PIN);
//
//    if(uiLow_batt == INEEDMD_RADIO_LOW_BATT_INTERUPT_PIN)
//    {
//      bIs_batt_low = true;
//    }
//
//    return bIs_batt_low;
//  #else
//    //INEEDMD_RADIO_LOW_BATT_INTERUPT_PIN no longer supported on board 03
//    vDEBUG_IS_BATT_LOW("Is Batt low SYS HALTED, LOW_BATT_INTERUPT_PIN no longer supported on board 03");
//    while(1){};
//  #endif //INEEDMD_RADIO_LOW_BATT_INTERUPT_PIN
//#undef vDEBUG_IS_BATT_LOW
//}
//

//
//int
//EKGSPIDisable(void)
//{
////  while(!SysCtlPeripheralReady(INEEDMD_ADC_SPI));
//  SSIDisable(INEEDMD_ADC_SPI);
//  MAP_SysCtlPeripheralDisable(SYSCTL_PERIPH_SSI0);
//  // power down the ADC
//  MAP_GPIOPinWrite(GPIO_PORTA_BASE, INEEDMD_PORTA_ADC_PWRDN_OUT_PIN, 0x00);
//
//  return 1;
//
//}

/******************************************************************************
* name:
* description:
* param description:
* return value description:
******************************************************************************/
ERROR_CODE eBSP_Set_radio_uart_baud(uint32_t uiBaud_rate_to_set)
{
#define DEBUG_eBSP_Set_radio_uart_baud
#ifdef DEBUG_eBSP_Set_radio_uart_baud
  #define  vDEBUG_BSB_UART_BAUD  vDEBUG
#else
  #define vDEBUG_BSB_UART_BAUD(a)
#endif
  ERROR_CODE eEC = ER_OK;

  ASSERT((uiBaud_rate_to_set == INEEDMD_RADIO_UART_BAUD_57600)   || \
         (uiBaud_rate_to_set == INEEDMD_RADIO_UART_BAUD_76800)   || \
         (uiBaud_rate_to_set == INEEDMD_RADIO_UART_BAUD_115200)  || \
         (uiBaud_rate_to_set == INEEDMD_RADIO_UART_BAUD_230400)  || \
         (uiBaud_rate_to_set == INEEDMD_RADIO_UART_BAUD_460800)  || \
         (uiBaud_rate_to_set == INEEDMD_RADIO_UART_BAUD_921600)  || \
         (uiBaud_rate_to_set == INEEDMD_RADIO_UART_BAUD_1382400) || \
         (uiBaud_rate_to_set == INEEDMD_RADIO_UART_BAUD_1843200) || \
         (uiBaud_rate_to_set == INEEDMD_RADIO_UART_BAUD_2764800) || \
         (uiBaud_rate_to_set == INEEDMD_RADIO_UART_BAUD_3686400));

//  MAP_UARTDisable(INEEDMD_RADIO_UART);
//  MAP_UARTConfigSetExpClk( INEEDMD_RADIO_UART, INEEDMD_RADIO_UART_CLK, uiBaud_rate_to_set, ( UART_CONFIG_WLEN_8 | UART_CONFIG_STOP_ONE | UART_CONFIG_PAR_NONE ));
//  MAP_UARTEnable(INEEDMD_RADIO_UART);

  if(sRadio_UART_handle != NULL)
  {
    UART_close(sRadio_UART_handle);
  }else{/*do nothing*/}

//  sRadio_UART_params.readMode       = UART_MODE_CALLBACK;              /*!< Mode for all read calls */
//  sRadio_UART_params.writeMode      = UART_MODE_CALLBACK;              /*!< Mode for all write calls */
  sRadio_UART_params.readMode       = UART_MODE_BLOCKING;              /*!< Mode for all read calls */
  sRadio_UART_params.writeMode      = UART_MODE_BLOCKING;              /*!< Mode for all write calls */
  sRadio_UART_params.readTimeout    = 1000;                            /*!< Timeout for read semaphore */
  sRadio_UART_params.writeTimeout   = 1000;                            /*!< Timeout for write semaphore */
//  sRadio_UART_params.readCallback   = vIneedMD_radio_read_cb;          /*!< Pointer to read callback */
//  sRadio_UART_params.writeCallback  = vIneedMD_radio_write_cb;         /*!< Pointer to write callback */
  sRadio_UART_params.readCallback   = NULL;          /*!< Pointer to read callback */
  sRadio_UART_params.writeCallback  = NULL;         /*!< Pointer to write callback */
//  sRadio_UART_params.readReturnMode = UART_RETURN_NEWLINE;             /*!< Receive return mode */
  sRadio_UART_params.readReturnMode = UART_RETURN_FULL;             /*!< Receive return mode */
  sRadio_UART_params.readDataMode   = UART_DATA_BINARY;                /*!< Type of data being read */
  sRadio_UART_params.writeDataMode  = UART_DATA_BINARY;                /*!< Type of data being written */
  sRadio_UART_params.readEcho       = UART_ECHO_OFF;                   /*!< Echo received data back */
  sRadio_UART_params.baudRate       = uiBaud_rate_to_set;              /*!< Baud rate for UART */
  sRadio_UART_params.dataLength     = UART_LEN_8;                      /*!< Data length for UART */
  sRadio_UART_params.stopBits       = UART_STOP_ONE;                   /*!< Stop bits for UART */
  sRadio_UART_params.parityType     = UART_PAR_NONE;                   /*!< Parity bit type for UART */

  sRadio_UART_handle = UART_open(INEEDMD_RADIO_UART_INDEX, &sRadio_UART_params);

  if(sRadio_UART_handle == NULL)
  {
    eEC = ER_FAIL;
  }
  else
  {
    eEC = ER_OK;
  }

  iHW_delay(500);

#ifdef DEBUG_eBSP_Set_radio_uart_baud
  vDEBUG_BSB_UART_BAUD("BSB uart baud set to:");
  if(uiBaud_rate_to_set == INEEDMD_RADIO_UART_BAUD_57600)
    vDEBUG_BSB_UART_BAUD("57600");
  else if(uiBaud_rate_to_set == INEEDMD_RADIO_UART_BAUD_76800)
    vDEBUG_BSB_UART_BAUD("76800");
  else if(uiBaud_rate_to_set == INEEDMD_RADIO_UART_BAUD_115200)
    vDEBUG_BSB_UART_BAUD("115200");
  else if(uiBaud_rate_to_set == INEEDMD_RADIO_UART_BAUD_230400)
    vDEBUG_BSB_UART_BAUD("230400");
  else if(uiBaud_rate_to_set == INEEDMD_RADIO_UART_BAUD_460800)
    vDEBUG_BSB_UART_BAUD("460800");
  else if(uiBaud_rate_to_set == INEEDMD_RADIO_UART_BAUD_921600)
    vDEBUG_BSB_UART_BAUD("921600");
  else if(uiBaud_rate_to_set == INEEDMD_RADIO_UART_BAUD_1382400)
    vDEBUG_BSB_UART_BAUD("1382400");
  else if(uiBaud_rate_to_set == INEEDMD_RADIO_UART_BAUD_1843200)
    vDEBUG_BSB_UART_BAUD("1843200");
  else if(uiBaud_rate_to_set == INEEDMD_RADIO_UART_BAUD_2764800)
    vDEBUG_BSB_UART_BAUD("2764800");
  else if(uiBaud_rate_to_set == INEEDMD_RADIO_UART_BAUD_3686400)
    vDEBUG_BSB_UART_BAUD("3686400");
  else{/*do nothing*/}
#endif

  return eEC;
#undef vDEBUG_BSB_UART_BAUD
}

/******************************************************************************
* name:
* description:
* param description:
* return value description:
******************************************************************************/
ERROR_CODE eBSP_Get_radio_uart_baud(uint32_t * uiBaud_rate_to_get)
{
#define DEBUG_eBSP_Get_radio_uart_baud
#ifdef DEBUG_eBSP_Get_radio_uart_baud
  #define  vDEBUG_BSB_GET_BAUD  vDEBUG
#else
  #define vDEBUG_BSB_GET_BAUD(a)
#endif
  ERROR_CODE eEC = ER_OK;
  uint32_t uiCurrent_Baud_rate = 0;

  if(sRadio_UART_handle == NULL)
  {
    eEC = ER_FAIL;
#ifdef DEBUG
    vDEBUG_BSB_GET_BAUD("Get baud SYS HALT, baud not set");
    while(1){};
#endif
  }
  else
  {
    if(uiCurrent_Baud_rate != sRadio_UART_params.baudRate)
    {
      uiCurrent_Baud_rate = sRadio_UART_params.baudRate;
    }
    *uiBaud_rate_to_get = uiCurrent_Baud_rate;
    eEC = ER_OK;
  }

  return eEC;
#undef vDEBUG_BSB_GET_BAUD
}

ERROR_CODE eBSP_Set_radio_uart_to_blocking(void)
{
  ERROR_CODE eEC = ER_FAIL;

  if(sRadio_UART_handle != NULL)
  {
    UART_close(sRadio_UART_handle);
  }else{/*do nothing*/}

//  sRadio_UART_params.readMode       = UART_MODE_CALLBACK;              /*!< Mode for all read calls */
//  sRadio_UART_params.writeMode      = UART_MODE_CALLBACK;              /*!< Mode for all write calls */
  sRadio_UART_params.readMode       = UART_MODE_BLOCKING;              /*!< Mode for all read calls */
  sRadio_UART_params.writeMode      = UART_MODE_BLOCKING;              /*!< Mode for all write calls */
  sRadio_UART_params.readTimeout    = 1000;                            /*!< Timeout for read semaphore */
  sRadio_UART_params.writeTimeout   = 1000;                            /*!< Timeout for write semaphore */
  sRadio_UART_params.readCallback   = vIneedMD_radio_read_cb;          /*!< Pointer to read callback */
//  sRadio_UART_params.writeCallback  = vIneedMD_radio_write_cb;         /*!< Pointer to write callback */
//  sRadio_UART_params.readCallback   = NULL;          /*!< Pointer to read callback */
  sRadio_UART_params.writeCallback  = NULL;         /*!< Pointer to write callback */
//  sRadio_UART_params.readReturnMode = UART_RETURN_NEWLINE;             /*!< Receive return mode */
  sRadio_UART_params.readReturnMode = UART_RETURN_FULL;             /*!< Receive return mode */
  sRadio_UART_params.readDataMode   = UART_DATA_BINARY;                /*!< Type of data being read */
  sRadio_UART_params.writeDataMode  = UART_DATA_BINARY;                /*!< Type of data being written */
  sRadio_UART_params.readEcho       = UART_ECHO_OFF;                   /*!< Echo received data back */
  sRadio_UART_params.baudRate       = INEEDMD_RADIO_UART_BAUD_1382400;              /*!< Baud rate for UART */
  sRadio_UART_params.dataLength     = UART_LEN_8;                      /*!< Data length for UART */
  sRadio_UART_params.stopBits       = UART_STOP_ONE;                   /*!< Stop bits for UART */
  sRadio_UART_params.parityType     = UART_PAR_NONE;                   /*!< Parity bit type for UART */

  sRadio_UART_handle = UART_open(INEEDMD_RADIO_UART_INDEX, &sRadio_UART_params);

  if(sRadio_UART_handle == NULL)
  {
    eEC = ER_FAIL;
  }
  else
  {
    eEC = ER_OK;
  }
  return eEC;
}

ERROR_CODE  eBSP_Set_radio_uart_to_callback(void)
{
  ERROR_CODE eEC = ER_FAIL;

  if(sRadio_UART_handle != NULL)
  {
    UART_close(sRadio_UART_handle);
  }else{/*do nothing*/}

  sRadio_UART_params.readMode       = UART_MODE_CALLBACK;              /*!< Mode for all read calls */
//  sRadio_UART_params.writeMode      = UART_MODE_CALLBACK;              /*!< Mode for all write calls */
//  sRadio_UART_params.readMode       = UART_MODE_BLOCKING;              /*!< Mode for all read calls */
  sRadio_UART_params.writeMode      = UART_MODE_BLOCKING;              /*!< Mode for all write calls */
  sRadio_UART_params.readTimeout    = BIOS_WAIT_FOREVER;                            /*!< Timeout for read semaphore */
  sRadio_UART_params.writeTimeout   = 1000;                            /*!< Timeout for write semaphore */
  sRadio_UART_params.readCallback   = vIneedMD_radio_read_cb;          /*!< Pointer to read callback */
//  sRadio_UART_params.writeCallback  = vIneedMD_radio_write_cb;         /*!< Pointer to write callback */
//  sRadio_UART_params.readCallback   = NULL;          /*!< Pointer to read callback */
  sRadio_UART_params.writeCallback  = NULL;         /*!< Pointer to write callback */
//  sRadio_UART_params.readReturnMode = UART_RETURN_NEWLINE;             /*!< Receive return mode */
  sRadio_UART_params.readReturnMode = UART_RETURN_FULL;             /*!< Receive return mode */
  sRadio_UART_params.readDataMode   = UART_DATA_BINARY;                /*!< Type of data being read */
  sRadio_UART_params.writeDataMode  = UART_DATA_BINARY;                /*!< Type of data being written */
  sRadio_UART_params.readEcho       = UART_ECHO_OFF;                   /*!< Echo received data back */
  sRadio_UART_params.baudRate       = INEEDMD_RADIO_UART_BAUD_1382400;              /*!< Baud rate for UART */
  sRadio_UART_params.dataLength     = UART_LEN_8;                      /*!< Data length for UART */
  sRadio_UART_params.stopBits       = UART_STOP_ONE;                   /*!< Stop bits for UART */
  sRadio_UART_params.parityType     = UART_PAR_NONE;                   /*!< Parity bit type for UART */

  sRadio_UART_handle = UART_open(INEEDMD_RADIO_UART_INDEX, &sRadio_UART_params);

  if(sRadio_UART_handle == NULL)
  {
    eEC = ER_FAIL;
  }
  else
  {
    eEC = ER_OK;
  }
  return eEC;
}

//*****************************************************************************
// name: RadioUARTEnable
// description: configures and enables the usart for the BT radio
// param description: none
// return value description: none
//*****************************************************************************
ERROR_CODE  eBSP_RadioUARTEnable(void)
{
  ERROR_CODE eEC = ER_FAIL;

  eEC = eBSP_Set_radio_uart_baud(INEEDMD_RADIO_UART_BAUD_1382400);
//  eEC = eBSP_Set_radio_uart_baud(INEEDMD_RADIO_UART_BAUD_115200);

  if(eEC == ER_OK)
  {
    //Config the uart speed, len, stop bits and parity
    //
//    MAP_UARTConfigSetExpClk( INEEDMD_RADIO_UART, INEEDMD_RADIO_UART_CLK, INEEDMD_RADIO_UART_BAUD, ( UART_CONFIG_WLEN_8 | UART_CONFIG_STOP_ONE | UART_CONFIG_PAR_NONE ));

    //Config the uart flow control
    //
//    MAP_UARTFlowControlSet(INEEDMD_RADIO_UART, (UART_FLOWCONTROL_TX | UART_FLOWCONTROL_RX));
  }
  else
  {
    eEC = ER_FAIL;
  }

//  //RADIO_CONFIG
//  //
//  MAP_SysCtlPeripheralEnable(SYSCTL_PERIPH_UART1);
//
//  // Enable pin PE0 for GPIOOutput - this is the reset for the radio.
//  //
//  MAP_GPIOPinTypeGPIOOutput(INEEDMD_GPIO_RST_PORT, INEEDMD_RADIO_RESET_PIN);
//
//  // Radio command mode, set pin to gpio output
//  //
//  MAP_GPIOPinTypeGPIOOutput(INEEDMD_GPIO_CMND_PORT, INEEDMD_RADIO_CMND_PIN);
//
//  // Radio enable, set pin to gpio output
//  //
//  MAP_GPIOPinTypeGPIOOutput(INEEDMD_GPIO_EN_PORT, INEEDMD_RADIO_ENABLE_PIN);
//
//  //
//  // Enable pin PF0 for UART1 U1RTS
//  // First open the lock and select the bits we want to modify in the GPIO commit register.
//  //
//  HWREG(INEEDMD_RADIO_RTS_PORT + INEEDMD_GPIO_RTS_LOCK) = GPIO_LOCK_KEY;
//  HWREG(INEEDMD_RADIO_RTS_PORT + INEEDMD_GPIO_RTS_CR) = 0x1;  //todo: no magic number!
//
//  // Configure the alternate function for UART RTS pin
//  //
//  MAP_GPIOPinConfigure(INEEDMD_GPIO_UARTRTS);
//  MAP_GPIOPinTypeUART(INEEDMD_RADIO_RTS_PORT, INEEDMD_RADIO_RTS_PIN);
//
//  // Configure the alternate function for UART CTS pin
//  //
//  MAP_GPIOPinConfigure(INEEDMD_GPIO_UARTCTS);
//  MAP_GPIOPinTypeUART(INEEDMD_RADIO_CTS_PORT, INEEDMD_RADIO_CTS_PIN);
//
//  // Configure the alternate function for UART TX and RX pins
//  //
//  MAP_GPIOPinConfigure(INEEDMD_GPIO_UARTTX);
//  MAP_GPIOPinConfigure(INEEDMD_GPIO_UARTRX);
//
//  // Set the TX pin type for the radio uart
//  //
//  MAP_GPIOPinTypeUART(INEEDMD_GPIO_TX_PORT, INEEDMD_GPIO_TX_PIN);
//
//  // Set the RX pin type for the radio uart
//  //
//  MAP_GPIOPinTypeUART(INEEDMD_GPIO_RX_PORT, INEEDMD_GPIO_RX_PIN);
//
//  //Set the UART clock source to internal
//  //
//  MAP_UARTClockSourceSet(INEEDMD_RADIO_UART, UART_CLOCK_PIOSC);
//
//  //Config the uart speed, len, stop bits and parity
//  //
//  MAP_UARTConfigSetExpClk( INEEDMD_RADIO_UART, INEEDMD_RADIO_UART_CLK, INEEDMD_RADIO_UART_BAUD, ( UART_CONFIG_WLEN_8 | UART_CONFIG_STOP_ONE | UART_CONFIG_PAR_NONE ));
//  MAP_UARTEnable(INEEDMD_RADIO_UART); //todo: can this function call be removed since it is called at the end?
//
//  //Config the uart flow control
//  //
//  MAP_UARTFlowControlSet(INEEDMD_RADIO_UART, (UART_FLOWCONTROL_TX | UART_FLOWCONTROL_RX));
//
//  // Enable the communication FIFO
//  //
//  MAP_UARTFIFOEnable(INEEDMD_RADIO_UART);
//  MAP_UARTFIFOLevelSet(INEEDMD_RADIO_UART, UART_FIFO_TX7_8, UART_FIFO_RX1_8);
//
//  //Do the final UART enable to begin transmitting and receiving
//  //
//  MAP_UARTEnable(INEEDMD_RADIO_UART);

  return eEC;
}

//*****************************************************************************
// name: iRadioPowerOn
// description: sets the gpio pin to the radio high to turn on the radio
// param description: none
// return value description: 1 if success
//*****************************************************************************
int iRadio_Power_On(void)
{
  GPIO_write(EK_TM4C123GXL_RADIO_POWER, INEEDMD_RADIO_ENABLE_PIN_SET);
  return 1;
}

//*****************************************************************************
// name: iRadioPowerOff
// description: sets the gpio pin to the radio low to turn the radio off
// param description: none
// return value description: 1 if success
//*****************************************************************************
int iRadio_Power_Off(void)
{
  GPIO_write(EK_TM4C123GXL_RADIO_POWER, INEEDMD_RADIO_ENABLE_PIN_CLEAR);
  return 1;
}

///******************************************************************************
//* name: eBSP_Radio_Power_Cycle
//* description:
//* param description:
//* return value description:
//******************************************************************************/
//ERROR_CODE  eBSP_Radio_Power_Cycle(void)
//{
//  ERROR_CODE eEC = ER_OK;
//  uint32_t uiPin_State = 0;
//
//  //turn the radio power off
//  iRadio_Power_Off();
//
//  //delay for 100ms
//  iHW_delay(100);
//
//  //turn the radio power on
//  iRadio_Power_On();
//
//  //Check to make sure th radio power pin is "on"
//  uiPin_State = MAP_GPIOPinRead(GPIO_PORTE_BASE, INEEDMD_RADIO_ENABLE_PIN);
//  if(uiPin_State == INEEDMD_RADIO_ENABLE_PIN)
//  {
//    eEC = ER_OK;
//  }
//  else
//  {
//    eEC = ER_FAIL;
//  }
//
//  return eEC;
//}

/******************************************************************************
* name:
* description:
* param description:
* return value description:
******************************************************************************/
ERROR_CODE  eBSP_Radio_Enable(void)
{
  ERROR_CODE eEC = ER_OK;
  uint32_t uiPin_Read = 0;

  GPIO_write(EK_TM4C123GXL_RADIO_RESET, INEEDMD_RADIO_RESET_PIN_CLEAR);

  uiPin_Read = GPIO_read(EK_TM4C123GXL_RADIO_RESET);

  if((uiPin_Read & INEEDMD_RADIO_RESET_PIN) == INEEDMD_RADIO_RESET_PIN_CLEAR)
  {
    eEC = ER_OK;
  }
  else
  {
    eEC = ER_FAIL;
  }

  return eEC;
}

/******************************************************************************
* name:
* description:
* param description:
* return value description:
******************************************************************************/
ERROR_CODE  eBSP_Radio_Disable(void)
{
  ERROR_CODE eEC = ER_OK;
  uint32_t uiPin_value = 0;

//  MAP_GPIOPinWrite (INEEDMD_GPIO_RST_PORT, INEEDMD_RADIO_RESET_PIN,  INEEDMD_RADIO_RESET_PIN_SET );

  GPIO_write(EK_TM4C123GXL_RADIO_RESET, INEEDMD_RADIO_RESET_PIN_SET);

  uiPin_value = GPIO_read(EK_TM4C123GXL_RADIO_RESET);

  if((uiPin_value & INEEDMD_RADIO_RESET_PIN) == INEEDMD_RADIO_RESET_PIN_SET)
  {
    eEC = ER_OK;
  }
  else
  {
    eEC = ER_FAIL;
  }

  return eEC;
}

/******************************************************************************
* name:
* description:
* param description:
* return value description:
******************************************************************************/
ERROR_CODE  eBSP_Radio_Reset(void)
{
  ERROR_CODE eEC = ER_OK;

  //exert the radio rest pin
  eBSP_Radio_Disable();

  //delay for 100ms
  iHW_delay(100);

  //de-exert,sets it low, reset pin
  eBSP_Radio_Enable();

  return eEC;
}

//*****************************************************************************
// name:
// description:
// param description:
// return value description:
//*****************************************************************************
ERROR_CODE eSet_radio_to_cmnd_mode(void)
{
//#define DEBUG_eSet_radio_to_cmnd_mode
#ifdef DEBUG_eSet_radio_to_cmnd_mode
  #define  SND_BUFF_SZ  32
  #define  vDEBUG_BRD_SET_RDIO_CMND_MODE  vDEBUG
  char cDbg_snd_buff[SND_BUFF_SZ];
  uint32_t uiGPIO_rd = 0;
#else
  #define vDEBUG_BRD_SET_RDIO_CMND_MODE(a)
#endif
  ERROR_CODE eEC = ER_FAIL;
  uint32_t uiPin_value = 0;

//  MAP_SysCtlPeripheralEnable(SYSCTL_PERIPH_GPIOE);
//  MAP_GPIOPinTypeGPIOOutput(GPIO_PORTE_BASE, GPIO_PIN_1);
//  MAP_GPIOPinWrite(GPIO_PORTE_BASE, GPIO_PIN_1, GPIO_PIN_1);
////  iRadio_gpio_config(INEEDMD_RADIO_PORT, INEEDMD_RADIO_CMND_PIN);
////  MAP_GPIOPinWrite(INEEDMD_RADIO_PORT, INEEDMD_RADIO_CMND_PIN, 0);
//  iHW_delay(10);
//  MAP_GPIOPinWrite(INEEDMD_GPIO_CMND_PORT, INEEDMD_RADIO_CMND_PIN, INEEDMD_RADIO_CMND_PIN_SET);

  GPIO_write(EK_TM4C123GXL_RADIO_CMND_MODE, INEEDMD_RADIO_CMND_PIN_SET);

  uiPin_value =  GPIO_read(EK_TM4C123GXL_RADIO_CMND_MODE);
  if(uiPin_value != INEEDMD_RADIO_CMND_PIN_SET)
  {
    eEC = ER_FAIL;
  }
  else
  {
    eEC = ER_OK;
  }
#ifdef DEBUG_eSet_radio_to_cmnd_mode
  memset(cDbg_snd_buff, 0x00, SND_BUFF_SZ);
  uiGPIO_rd = MAP_GPIOPinRead(INEEDMD_RADIO_PORT, INEEDMD_RADIO_CMND_PIN);
  snprintf(cDbg_snd_buff, SND_BUFF_SZ, "Set rdio cmnd md, %.4x", uiGPIO_rd);
  vDEBUG_BRD_SET_RDIO_CMND_MODE(cDbg_snd_buff);
#endif

  return eEC;
#undef  vDEBUG_BRD_SET_RDIO_CMND_MODE
}

//*****************************************************************************
// name:
// description:
// param description:
// return value description:
//*****************************************************************************
ERROR_CODE eIs_radio_in_cmnd_mode(void)
{
  ERROR_CODE eEC = ER_FAIL;
  uint32_t uiPin_Read = 0;

  uiPin_Read = MAP_GPIOPinRead(INEEDMD_GPIO_CMND_PORT, INEEDMD_RADIO_CMND_PIN);

  if((uiPin_Read & INEEDMD_RADIO_CMND_PIN) == INEEDMD_RADIO_CMND_PIN)
  {
    eEC = ER_TRUE;
  }
  else
  {
    eEC = ER_FALSE;
  }

  return eEC;
}

//*****************************************************************************
// name:
// description:
// param description:
// return value description:
//*****************************************************************************
ERROR_CODE eSet_radio_to_data_mode(void)
{
//#define DEBUG_eSet_radio_to_data_mode
#ifdef DEBUG_eSet_radio_to_data_mode
  #define  SND_BUFF_SZ  32
  #define  vDEBUG_BRD_SET_RDIO_DTA_MODE  vDEBUG
  char cDbg_snd_buff[SND_BUFF_SZ];
  uint32_t uiGPIO_rd = 0;
#else
  #define vDEBUG_BRD_SET_RDIO_DTA_MODE(a)
#endif
  ERROR_CODE eEC = ER_FAIL;
  uint32_t uiPin_value = 0;

//  MAP_GPIOPinWrite(INEEDMD_GPIO_CMND_PORT, INEEDMD_RADIO_CMND_PIN, INEEDMD_RADIO_CMND_PIN_CLEAR);
  GPIO_write(EK_TM4C123GXL_RADIO_CMND_MODE, INEEDMD_RADIO_CMND_PIN_CLEAR);

  uiPin_value =  GPIO_read(EK_TM4C123GXL_RADIO_CMND_MODE);
  if(uiPin_value != INEEDMD_RADIO_CMND_PIN_CLEAR)
  {
    eEC = ER_FAIL;
  }
  else
  {
    eEC = ER_OK;
  }
#ifdef DEBUG_eSet_radio_to_data_mode
  memset(cDbg_snd_buff, 0x00, SND_BUFF_SZ);
  uiGPIO_rd = MAP_GPIOPinRead(INEEDMD_RADIO_PORT, INEEDMD_RADIO_CMND_PIN);
  snprintf(cDbg_snd_buff, SND_BUFF_SZ, "Set rdio dta md, %.4x", uiGPIO_rd);
  vDEBUG_BRD_SET_RDIO_DTA_MODE(cDbg_snd_buff);
#endif

  return eEC;
#undef vDEBUG_BRD_SET_RDIO_DTA_MODE
}

//*****************************************************************************
// name:
// description:
// param description:
// return value description:
//*****************************************************************************
ERROR_CODE eUsing_radio_uart_dma(void)
{
  ERROR_CODE eEC = ER_FAIL;

  if(USE_RADIO_UART_DMA == true)
  {
    eEC = ER_TRUE;
  }
  else
  {
    eEC = ER_FALSE;
  }

  return eEC;
}

//*****************************************************************************
// name: iRadio_interface_enable
// description: enables the serial interface to the external radio
// param description: none
// return value description: 1 if success
//*****************************************************************************
ERROR_CODE eRadio_interface_enable(void)
{
  ERROR_CODE eEC = ER_OK;

  eEC = eBSP_RadioUARTEnable();

  if(eEC == ER_OK)
  {
    //check if UART DMA is enabled
    if(USE_RADIO_UART_DMA == true)
    {
      //configure the radio UART to use DMA
      //todo: implement dma config
//      eEC = Radio_UART_DMA_Config();
      eEC = ER_FAIL; //DMA not implemented yet
    }else{/*do nothing*/}
  }

  //check the error codes
  if(eEC != ER_OK)
  {
    eEC = ER_FAIL;
  }else{/*do nothing*/}

  return eEC;
}

//*****************************************************************************
// name:
// description:
// param description:
// return value description:
//*****************************************************************************
int iRadio_send_char(char * byte)
{

  UARTCharPut(INEEDMD_RADIO_UART, *byte);

  return 1;
}

//*****************************************************************************
// name:
// description:
// param description:
// return value description:
//*****************************************************************************
int iRadio_send_string(char *cSend_string, uint16_t uiBuff_size)
{
  uint32_t i;
  int iBytes_sent = 0;
  i = strlen(cSend_string);
  if(i != uiBuff_size)
  {
    return 0;
  }

  iBytes_sent = UART_write(sRadio_UART_handle, cSend_string, i);

  return iBytes_sent;
}

//*****************************************************************************
// name:
// description:
// param description:
// return value description:
//*****************************************************************************
ERROR_CODE eRadio_DMA_send_string(char *cSend_string, uint16_t uiBuff_size)
{
#define DEBUG_eRadio_DMA_send_string
#ifdef DEBUG_eRadio_DMA_send_string
  #define  vDEBUG_RDIO_DMA_SNDSTR  vDEBUG
#else
  #define vDEBUG_RDIO_DMA_SNDSTR(a)
#endif
  ERROR_CODE eEC = ER_FAIL;
#if USE_RADIO_UART_DMA == true
  int i = 0;
  tDMA_TX_struct * ptDMA_TX_Send = NULL;
  uint32_t uiModem_status_get = 0;

  //find a free TX buffer
  for(i = 0; i < NUM_DMA_RDIO_TX_BUFFS; i++)
  {
    if(tDMA_TX_struct_array[i].bBuff_free == true)
    {
      //ensure the TX buffer is erased
      memset(&tDMA_TX_struct_array[i].uiTx_Buff, 0x00, DMA_RDIO_TX_BUFFSZ);

      //fill the TX buffer with the data to send
      memcpy(&tDMA_TX_struct_array[i].uiTx_Buff, cSend_string, uiBuff_size);

      //save the buffer size
      tDMA_TX_struct_array[i].uiTx_data_len  = uiBuff_size;

      //save the pointer to the struct to use to send
      ptDMA_TX_Send = &tDMA_TX_struct_array[i];

      tDMA_TX_struct_array[i].bBuff_free = false;
      tDMA_TX_struct_array[i].bTx_done = false;

      eEC = ER_OK;
      break;
    }
    else
    {
      //set the error code to no buff available
      eEC = ER_NO_BUFF_AVAILABLE;
    }
  }

  //check if it is ok to start the DMA
  if(eEC == ER_OK)
  {
    // Set up the transfer parameters for the uDMA Radio UART TX channel.  This will
    // configure the transfer source and destination and the transfer size.
    // Basic mode is used because the peripheral is making the uDMA transfer
    // request.  The source is the TX buffer and the destination is the UART
    // data register.
    //
    MAP_UARTModemControlSet(INEEDMD_RADIO_UART, UART_OUTPUT_RTS);

    uiModem_status_get = MAP_UARTModemStatusGet(INEEDMD_RADIO_UART);
    while((uiModem_status_get & UART_INPUT_CTS) != UART_INPUT_CTS)
    {
      uiModem_status_get = MAP_UARTModemStatusGet(INEEDMD_RADIO_UART);
    }

    MAP_uDMAChannelTransferSet(UDMA_CHANNEL_RADIO_TX | UDMA_PRI_SELECT,
                               UDMA_MODE_AUTO, ptDMA_TX_Send->uiTx_Buff,
                               (void *)(INEEDMD_RADIO_UART + UART_O_DR),
                               ptDMA_TX_Send->uiTx_data_len);

    MAP_uDMAChannelEnable(UDMA_CHANNEL_RADIO_TX);

    bIs_DMA_transmit_in_process = true;
  }
  else if(eEC == ER_NO_BUFF_AVAILABLE)
  {
#ifdef DEBUG
    vDEBUG_RDIO_DMA_SNDSTR("DMA send str SYS HALTED, no buff available to send");
    while(1){};
#endif
  }else{/*nothing*/}
#elif  USE_RADIO_UART_DMA == false
  eEC = ER_NOT_ENABLED;
#endif //USE_RADIO_UART_DMA
  return eEC;
#undef vDEBUG_RDIO_DMA_SNDSTR
}

//*****************************************************************************
// name:
// description:
// param description:
// return value description:
//*****************************************************************************
int iRadio_send_frame(uint8_t *cSend_frame, uint16_t uiFrame_size)
{
  int i;

  i = UART_write(sRadio_UART_handle, cSend_frame, uiFrame_size);

  if(i == UART_ERROR)
  {
    i = -1;
  }else{/*do nothing*/}
  return i;
}

//*****************************************************************************
// name:
// description:
// param description:
// return value description:
//*****************************************************************************
ERROR_CODE eRadio_rcv_string(char *cRcv_string, uint16_t uiBuff_size)
{
  ERROR_CODE eEC = ER_FAIL;
  int i = 0;

  i = UART_read(sRadio_UART_handle, cRcv_string, uiBuff_size);

  if(i == UART_ERROR)
  {
    eEC = ER_FAIL;
  }
  else
  {
    eEC = ER_OK;
  }
  return eEC;

//  for(i = 0; i < uiBuff_size; i++)
//  {
//    //receive a character from the USART
//    cRcv_string[i] = UARTCharGet(INEEDMD_RADIO_UART);
//
//    //check if the end of the radio frame is received
//    if(cRcv_string[i] == '\n')
//    {
//      if(i < 2)
//      {
//        i = -1;
//        continue;
//      }
//      else
//      {
//        break;
//      }
//    }
//  }
//  return i;
}

//*****************************************************************************
// name:
// description:
// param description:
// return value description:
//*****************************************************************************
ERROR_CODE iRadio_rcv_char(char *cRcv_char)
{
  ERROR_CODE eEC = ER_FAIL;
  int i = 0;

  i = UART_read(sRadio_UART_handle, cRcv_char, 1);

//  bChar_avail = UARTCharsAvail(INEEDMD_RADIO_UART);
//  if(bChar_avail == false)
//  {
//    while(bChar_avail == false)
//    {
//      uiTimeout += iHW_delay(1);
//      bChar_avail = UARTCharsAvail(INEEDMD_RADIO_UART);
//      if(uiTimeout >= 200) //todo: MAGIC Number!
//      {
//        eEC = ER_TIMEOUT;
//        break;
//      }
//    }
//  }else{/*do nothing*/}
//
//  if(eEC == ER_OK)
//  {
//    //get the character
//    *cRcv_char = UARTCharGetNonBlocking(INEEDMD_RADIO_UART);
//  }else{/*do nothing */}

  if(i == UART_ERROR)
  {
    eEC = ER_FAIL;
  }
  else if(i == 0)
  {
    eEC = ER_TIMEOUT;
  }
  else
  {
    eEC = ER_OK;
  }
  return eEC;
}

ERROR_CODE  eRadio_rcv_frame(uint8_t * cRcv_frame, uint32_t uiFrame_len)
{
  ERROR_CODE eEC = ER_FAIL;

  UART_read(sRadio_UART_handle, cRcv_frame, uiFrame_len);

  return eEC;
}

//*****************************************************************************
// name: eRadio_clear_rcv_buffer
// description: performs a non-blocking receive on the radio UART untill there
//   is no more data to receive. This function has a timeout which is its
//   primary method of determining if there is any more data to receive.
// param description:
// return value description: returns an error code
//                           ER_OK     - this is an invalid error code and should not be returned
//                           ER_NODATA - there was never any data on the UART to receive
//                           ER_CLEAR  - there was data on the UART and it was cleared
//
//*****************************************************************************
ERROR_CODE  eRadio_clear_rcv_buffer(void)
{
//#define DEBUG_eRadio_clear_rcv_buffer
#ifdef DEBUG_eRadio_clear_rcv_buffer
  #define  vDEBUG_RDIO_RCV_CLR  vDEBUG
#else
  #define vDEBUG_RDIO_RCV_CLR(a)
#endif
  ERROR_CODE eEC = ER_OK;
  int32_t iRcv_data;
  bool bWas_data = false;
  int i = 0;

  while(eEC == ER_OK)
  {
    //get any data on the radio uart
    iRcv_data = UARTCharGetNonBlocking(INEEDMD_RADIO_UART);

    //check if data was received
    if(iRcv_data != -1)
    {
      //mark that data was received
      bWas_data = true;
    }else{/*do nothing*/}

    //while there is no data perform a delay, and increment a timeout counter
    while(iRcv_data == -1)
    {
      i += iHW_delay(1);
      //check if the timeout was reached
      if(i == 100)
      {
        //set the no data error code
        eEC = ER_NODATA;
        break;
      }else{/*do nothing*/}

      iRcv_data = UARTCharGetNonBlocking(INEEDMD_RADIO_UART);
      //check if data was received
      if(iRcv_data != -1)
      {
        //if data was receive reset the timeout counter
        i = 0;

        //mark that data was received
        bWas_data = true;
      }else{/*do nothing*/}
    }
  }

  //check if ANY data was received and set the proper error code
  if(bWas_data == true)
  {
    vDEBUG_RDIO_RCV_CLR("Rdio rcv clr, there was rcv data to clear");
    eEC = ER_CLEAR;
  }
  else
  {
    vDEBUG_RDIO_RCV_CLR("Rdio rcv clr, no rcv data to clear");
  }

  return eEC;
#undef vDEBUG_RDIO_RCV_CLR
}

//*****************************************************************************
// name:
// description:
// param description:
// return value description:
//*****************************************************************************
bool bRadio_is_data(void)
{
  //todo: disable interrupts
  bool bWas_usart_data = bIs_usart_data;

  bIs_usart_data = false;
//todo: enable interrupts
  return bWas_usart_data;
}

//*****************************************************************************
// name: eGet_Radio_CTS_status
// description:
// param description:
// return value description: returns an error code
//                           ER_FAIL    - unknown return value, should not occure
//                           ER_TRUE    - UART CTS is set
//                           ER_FALSE   - UART CTS is not set
//*****************************************************************************
ERROR_CODE  eGet_Radio_CTS_status(void)
{
  ERROR_CODE eEC = ER_FAIL;
  uint32_t uiModem_status_get = 0;

  uiModem_status_get = MAP_UARTModemStatusGet(INEEDMD_RADIO_UART);
  if((uiModem_status_get & UART_INPUT_CTS) == UART_INPUT_CTS)
  {
    eEC = ER_TRUE;
  }
  else
  {
    eEC = ER_FALSE;
  }

  return eEC;
}


////*****************************************************************************
//// name: eGet_Radio_CTS_INT_status
//// description:
//// param description:
//// return value description: returns an error code
////                           ER_FAIL    - unknown return value, should not occure
////                           ER_SET     - CTS Interrupt was set
////                           ER_NOT_SET - CTS Interrupt was not set
////*****************************************************************************
//ERROR_CODE  eGet_Radio_CTS_INT_status(void)
//{
//  ERROR_CODE eEC = ER_FAIL;
//  uint32_t uiWas_cts_set = 0;
//
//  uiWas_cts_set = uiCTS_int_status;
//  uiCTS_int_status = 0;
//
//  if((uiWas_cts_set & UART_INT_CTS) == UART_INT_CTS)
//  {
//    eEC = ER_SET;
//  }
//  else
//  {
//    eEC = ER_NOT_SET;
//  }
//
//  return eEC;
//}
//
////*****************************************************************************
//// name:
//// description:
//// param description:
//// return value description:
////*****************************************************************************
//void
//SDCardSPIInit(void)
//{
//  //
//  //SPI 1 is used for the FLASH
//  MAP_SysCtlPeripheralEnable(SYSCTL_PERIPH_SSI1);
//  //
//  // Enable pin PD2 for SSI1 SSI1RX
//  //
//  MAP_GPIOPinConfigure(GPIO_PD2_SSI1RX);
//  MAP_GPIOPinTypeSSI(GPIO_PORTD_BASE, GPIO_PIN_2);
//  //
//  // Enable pin PD3 for SSI1 SSI1TX
//  //
//  MAP_GPIOPinConfigure(GPIO_PD3_SSI1TX);
//  MAP_GPIOPinTypeSSI(GPIO_PORTD_BASE, GPIO_PIN_3);
//  //
//  // Enable pin PD0 for SSI1 SSI1CLK
//  //
//  MAP_GPIOPinConfigure(GPIO_PD0_SSI1CLK);
//  MAP_GPIOPinTypeSSI(GPIO_PORTD_BASE, GPIO_PIN_0);
//  //
//  // Enable pin PD1 for SSI1 SSI1FSS
//  //
//  MAP_GPIOPinConfigure(GPIO_PD1_SSI1FSS);
//  MAP_GPIOPinTypeSSI(GPIO_PORTD_BASE, GPIO_PIN_1);
//
//
//  MAP_SSIClockSourceSet(INEEDMD_FLASH_SPI, SSI_CLOCK_PIOSC);
//
//  SSIEnable(INEEDMD_FLASH_SPI);
//  SSIConfigSetExpClk(INEEDMD_FLASH_SPI, INEEDMD_SPI_CLK, SSI_FRF_MOTO_MODE_2, SSI_MODE_MASTER, 1000000, 8);
//  SSIEnable(INEEDMD_FLASH_SPI);
//  /*  while(!SysCtlPeripheralReady(INEEDMD_FLASH_SPI));
//
//  //
//  //SPI 1 is used for the FLASH
//  MAP_SysCtlPeripheralEnable(SYSCTL_PERIPH_SSI1);
//  //
//  // Enable pin PD2 for SSI1 SSI1RX
//  //
//  MAP_GPIOPinConfigure(GPIO_PD2_SSI1RX);
//  MAP_GPIOPinTypeSSI(GPIO_PORTD_BASE, GPIO_PIN_2);
//  //
//  // Enable pin PD3 for SSI1 SSI1TX
//  //
//  MAP_GPIOPinConfigure(GPIO_PD3_SSI1TX);
//  MAP_GPIOPinTypeSSI(GPIO_PORTD_BASE, GPIO_PIN_3);
//  //
//  // Enable pin PD0 for SSI1 SSI1CLK
//  //
//  MAP_GPIOPinConfigure(GPIO_PD0_SSI1CLK);
//  MAP_GPIOPinTypeSSI(GPIO_PORTD_BASE, GPIO_PIN_0);
//  //
//  // Enable pin PD1 for SSI1 SSI1FSS
//  //
//  MAP_GPIOPinConfigure(GPIO_PD1_SSI1FSS);
//  MAP_GPIOPinTypeSSI(GPIO_PORTD_BASE, GPIO_PIN_1);
//  SSIEnable(INEEDMD_FLASH_SPI);
//  SSIConfigSetExpClk(INEEDMD_FLASH_SPI, INEEDMD_RADIO_UART_CLK(), SSI_FRF_MOTO_MODE_2, SSI_MODE_MASTER, 1000000, 8);
//  SSIEnable(INEEDMD_FLASH_SPI);
//  //  while(!SysCtlPeripheralReady(INEEDMD_FLASH_SPI));
//
//*/
//}
//
///******************************************************************************
//* name:
//* description:
//* param description:
//* return value description:
//******************************************************************************/
//void
//SDCardSPIDisable(void)
//{
//  //  while(!SysCtlPeripheralReady(INEEDMD_FLASH_SPI));
//  SSIDisable(INEEDMD_FLASH_SPI);
//    //
//    //SPI 1 is used for the FLASH
//    MAP_SysCtlPeripheralDisable(SYSCTL_PERIPH_SSI1);
//
//}
//
///******************************************************************************
//* name:
//* description:
//* param description:
//* return value description:
//******************************************************************************/
//void
//LEDI2CEnable(void)
//{
//  if(bIs_LEDI2D_Enabled == false)
//  {
//    //
//    // Enable pin PB2 for I2C0 I2C0SCL
//    //
//    MAP_SysCtlPeripheralEnable(SYSCTL_PERIPH_I2C0);
//    // majik delay as there are things that need to settle.  Because the I2C is very low speed block this is twice as long as the other delays
//    MAP_SysCtlDelay(200);
//    //
//    // I2C Clk is on portB pin 2
//    //
//    MAP_GPIOPinTypeI2CSCL(GPIO_PORTB_BASE, GPIO_PIN_2);
//    MAP_GPIOPinConfigure(GPIO_PB2_I2C0SCL);
//    //
//    // I2C SDA is on portB pin 3
//    //
//    MAP_GPIOPinTypeI2C(GPIO_PORTB_BASE, GPIO_PIN_3);
//    MAP_GPIOPinConfigure(GPIO_PB3_I2C0SDA);
//    I2CMasterInitExpClk(INEEDMD_LED_I2C, MAP_SysCtlClockGet(), true);
//    I2CMasterEnable(INEEDMD_LED_I2C);
//      //  while(!SysCtlPeripheralReady(INEEDMD_LED_I2C));
//
//    bIs_LEDI2D_Enabled = true;
//  }
//  else
//  {
//    bIs_LEDI2D_Enabled = true;
//  }
//}
//
///******************************************************************************
//* name:
//* description:
//* param description:
//* return value description:
//******************************************************************************/
//void
//LEDI2CDisable(void)
//{
//  if(bIs_LEDI2D_Enabled == true)
//  {
//    //  while(!SysCtlPeripheralReady(SYSCTL_PERIPH_I2C0));
//    I2CMasterDisable(INEEDMD_LED_I2C);
//    MAP_SysCtlPeripheralDisable(SYSCTL_PERIPH_I2C0);
//    bIs_LEDI2D_Enabled = false;
//  }
//  else
//  {
//    bIs_LEDI2D_Enabled = false;
//  }
//}
//
///******************************************************************************
//* name: eBSP_LEDI2C_clock_set
//* description: sets the LED I2C clock speed to the current system speed
//* param description:
//* return value description:
//******************************************************************************/
//ERROR_CODE eBSP_LEDI2C_clock_set(void)
//{
//  ERROR_CODE eEC = ER_OK;
//
//  if(bIs_LEDI2D_Enabled == true)
//  {
//    I2CMasterDisable(INEEDMD_LED_I2C);
//    I2CMasterInitExpClk(INEEDMD_LED_I2C, MAP_SysCtlClockGet(), true);
//    I2CMasterEnable(INEEDMD_LED_I2C);
//  }else{/*do nothing*/}
//
//  return eEC;
//}
//
///******************************************************************************
//* name:
//* description:
//* param description:
//* return value description:
//******************************************************************************/
//void
//XTALControlPin(void)
//{
//    //
//    // set up the crystal control pin...
//    //
//    MAP_GPIOPinTypeGPIOOutput(GPIO_PORTD_BASE, INEEDMD_PORTD_XTAL_ENABLE);
//}
//
////*****************************************************************************
//// name:
//// description:
//// param description:
//// return value description:
////*****************************************************************************
//void USBPortEnable(void)
//{
//#ifdef USE_USBLIB
//  // Enable lazy stacking for interrupt handlers.
//  //
//  MAP_FPULazyStackingEnable();
//
//  // Enable the GPIO peripheral used for USB, and configure the USB
//  // pins.
//  //
//  MAP_SysCtlPeripheralEnable(SYSCTL_PERIPH_GPIOD);
//  MAP_GPIOPinTypeUSBAnalog(GPIO_PORTD_BASE, GPIO_PIN_4 | GPIO_PIN_5);
//
//  // Initialize the transmit and receive buffers.
//  //
//  USBBufferInit(&g_sTxBuffer);
//  USBBufferInit(&g_sRxBuffer);
//
//  // Set the USB stack mode to Device mode with VBUS monitoring.
//  //
//  USBStackModeSet(0, eUSBModeForceDevice, 0);
//#else //!USE_USBLIB
//  bool bUSB_plugged_in = false;
//  uint16_t i = 0;
//
////  if(bIs_USB_Enabled == false)
////  {
//    // USB block need the processor at full speed to complete the initialization.
//    set_system_speed(INEEDMD_CPU_SPEED_FULL_EXTERNAL);
//
//    //Enable the USB peripheral
//    //
//    MAP_SysCtlPeripheralEnable(SYSCTL_PERIPH_USB0);
//
//    ROM_FPULazyStackingEnable();
//
//    // Enable pins for USB0 USB0DP and USB0DM
//    //
//    MAP_SysCtlPeripheralEnable(SYSCTL_PERIPH_GPIOD);
//    MAP_GPIOPinTypeUSBAnalog(GPIO_PORTD_BASE, GPIO_PIN_5 | GPIO_PIN_4);
//
//    HWREG(NVIC_DIS0) = 0xffffffff;
//    HWREG(NVIC_DIS1) = 0xffffffff;
//
//    // reset the USB
//    //
//    MAP_SysCtlPeripheralReset(SYSCTL_PERIPH_USB0);
//
//    //Enable USB PLL
//    //
//    MAP_SysCtlUSBPLLEnable();
//
//    // Re-enable interrupts at NVIC level
//    eMaster_int_enable();
//
//    MAP_USBIntEnableControl(USB0_BASE, USB_INTCTRL_ALL);
//  //    MAP_USBIntEnableEndpoint(USB0_BASE, USB_INTEP_ALL);
//
//    MAP_USBDevConnect(USB0_BASE);
//
//    MAP_IntEnable(INT_USB0);
//
//    //Do a delay to potentially allow an external device that is attached attached
//    //to notify the dongle of a data connection. Exit the delay early if a data
//    //connection is detected within the timeout period otherwise continue.
//    bUSB_plugged_in = bIs_usb_physical_data_conn(false);
//    while(bUSB_plugged_in == false)
//    {
//      i += iHW_delay(1);
//      bUSB_plugged_in = bIs_usb_physical_data_conn(false);
//      if(bUSB_plugged_in == true)
//      {
//        break;
//      }else{/*do nothing*/}
//
//      if(i == USB_THREE_SEC_DATA_CONN_DELAY)
//      {
//        break;
//      }else{/*do nothing*/}
//    }
//
////    //set control variables
////    bIs_USB_Enabled = true;
////  }
////  else
////  {
////    return;
////  }
//#endif //USE_USBLIB
//}
//
////*****************************************************************************
//// name:
//// description:
//// param description:
//// return value description:
////*****************************************************************************
//void USBPortDisable(void)
//{
////  if(bIs_USB_Enabled == true)
////  {
//    //disable all interrupts
////    eMaster_int_disable();
//
//    //disable the USB0 interrupt
//    ROM_IntDisable(INT_USB0);
//
//    //disconnect the USB0 device
//    MAP_USBDevDisconnect(USB0_BASE);
//
//    //disable the interrupt controll
//    MAP_USBIntDisableControl(USB0_BASE, USB_INTCTRL_DISCONNECT |
//                                        USB_INTCTRL_CONNECT);
//
//    //turn off the USB PLL
//    MAP_SysCtlUSBPLLDisable();
//
//    // disable the entier USB0 peripheral
//    MAP_SysCtlPeripheralDisable(SYSCTL_PERIPH_USB0);
//
//    set_system_speed(INEEDMD_CPU_SPEED_HALF_INTERNAL);
//
//    //re-enable all interrupts
//    eMaster_int_enable();
//
//    //set control variables
//    bIs_USB_Enabled = false;
////  }
////  else
////  {
////    return;
////  }
//}
//
///******************************************************************************
//* name:
//* description:
//* param description:
//* return value description:
//******************************************************************************/
//void vUSBServiceInt(uint32_t uiUSB_int_flags)
//{
//
//  if((uiUSB_int_flags & USB_INTCTRL_SOF) == USB_INTCTRL_SOF)
//  {
//    bIs_USB_sof = true;
//  }
//
//  if((uiUSB_int_flags & USB_INTCTRL_DISCONNECT) == USB_INTCTRL_DISCONNECT)
//  {
//    bIs_USB_sof = false;
//  }
//}
//
///******************************************************************************
//* name:
//* description:
//* param description:
//* return value description:
//******************************************************************************/
//bool bIs_usb_physical_data_conn(bool bClear_Status)
//{
//  bool bWas_physical_data_conn;
//
//  eMaster_int_disable();
//
//  bWas_physical_data_conn = bIs_USB_sof;
//  if(bClear_Status == true)
//  {
//    bIs_USB_sof = false;
//  }else{/*do nothing*/}
//
//  //re-enable interrupts
//  eMaster_int_enable();
//
//  return bWas_physical_data_conn;
//}
//

//*****************************************************************************
// name:
// description:
// param description:
// return value description:
//*****************************************************************************
ERROR_CODE  eBSP_USB_is_physical_connection(void)
{
  ERROR_CODE eEC = ER_NOT_CONNECTED;
  uint32_t uiUSB_conn_pin_status = 0;

  uiUSB_conn_pin_status = GPIO_read(EK_TM4C123GXL_USB_DETECT);
  if(INEEDMD_USB_DET_PIN_SET == uiUSB_conn_pin_status)
  {
    eEC = ER_CONNECTED;
  }
  else
  {
    eEC = ER_NOT_CONNECTED;
  }

  return eEC;
}

//
////*****************************************************************************
//// name: eBSP_Systick_Init
//// description:
//// param description:
//// return value description:
////*****************************************************************************
//ERROR_CODE eBSP_Systick_Init(void)
//{
//  ERROR_CODE eEC = ER_OK;
//  uint32_t uiSys_clock_rate = 0;
//  uint32_t uiSys_clock_check = 0;
//
//  //Disable the sys tick
//  MAP_SysTickIntDisable();
//  MAP_SysTickDisable();
//
//  //get the current clock rate and set it to a 1ms value
////  if(uiCurrent_sys_speed == INEEDMD_CPU_SPEED_HALF_INTERNAL_OSC)
////  {
////    uiSys_clock_rate = 16000000;
////  }
////  else
////  {
//    uiSys_clock_rate = MAP_SysCtlClockGet();
////  }
//  uiSys_clock_rate = uiSys_clock_rate/1000;
//
//  //set the systick period
//  MAP_SysTickPeriodSet(uiSys_clock_rate);
//
//  //enable the sys tick
//  MAP_SysTickEnable();
//  MAP_SysTickIntEnable();
//
//  //verify the sys tick value was set
//  uiSys_clock_check = MAP_SysTickPeriodGet();
//  if(uiSys_clock_check == uiSys_clock_rate)
//  {
//    eEC = ER_OK;
//  }
//  else
//  {
//    eEC = ER_FAIL;
//  }
//
//  return eEC;
//}
//
///*
//* ConfigureSleepleep(void)
//*
//*This function sets up the behaviour of the cpu peripherals in sleep mode
//*
//*/
//void ConfigureSleep(void)
//{
//        //
//        // Which peripherals are enabled in sleep
//        // Peripherals should be enabled OR disabled
//        //SysCtlPeripheralSleepEnable(SYSCTL_PERIPH_ADC0);
//        SysCtlPeripheralSleepDisable(SYSCTL_PERIPH_ADC0);
//        //
//        //SysCtlPeripheralSleepEnable(SYSCTL_PERIPH_ADC1);
//        SysCtlPeripheralSleepDisable(SYSCTL_PERIPH_ADC1);
//        //
//        //SysCtlPeripheralSleepEnable(SYSCTL_PERIPH_CAN0);
//        SysCtlPeripheralSleepDisable(SYSCTL_PERIPH_CAN0);
//        //
//        //SysCtlPeripheralSleepEnable(SYSCTL_PERIPH_COMP0);
//        SysCtlPeripheralSleepDisable(SYSCTL_PERIPH_COMP0);
//        //
//        //SysCtlPeripheralSleepEnable(SYSCTL_PERIPH_GPIOA);
//        SysCtlPeripheralSleepDisable(SYSCTL_PERIPH_GPIOA);
//        //
//        //SysCtlPeripheralSleepEnable(SYSCTL_PERIPH_GPIOB);
//        SysCtlPeripheralSleepDisable(SYSCTL_PERIPH_GPIOB);
//        //
//        //SysCtlPeripheralSleepEnable(SYSCTL_PERIPH_GPIOC);
//        SysCtlPeripheralSleepDisable(SYSCTL_PERIPH_GPIOC);
//        //
//        //SysCtlPeripheralSleepEnable(SYSCTL_PERIPH_GPIOD);
//        SysCtlPeripheralSleepDisable(SYSCTL_PERIPH_GPIOD);
//        //
//        //SysCtlPeripheralSleepEnable(SYSCTL_PERIPH_GPIOE);
//        SysCtlPeripheralSleepDisable(SYSCTL_PERIPH_GPIOE);
//        //
//        //SysCtlPeripheralSleepEnable(SYSCTL_PERIPH_GPIOF);
//        SysCtlPeripheralSleepDisable(SYSCTL_PERIPH_GPIOF);
//        //
//        SysCtlPeripheralSleepEnable(SYSCTL_PERIPH_HIBERNATE);
//        //SysCtlPeripheralSleepDisable(SYSCTL_PERIPH_HIBERNATE);
//        //
//        //SysCtlPeripheralSleepEnable(SYSCTL_PERIPH_I2C0);
//        SysCtlPeripheralSleepDisable(SYSCTL_PERIPH_I2C0);
//        //
//        //SysCtlPeripheralSleepEnable(SYSCTL_PERIPH_I2C1);
//        SysCtlPeripheralSleepDisable(SYSCTL_PERIPH_I2C1);
//        //
//        //SysCtlPeripheralSleepEnable(SYSCTL_PERIPH_I2C2);
//        SysCtlPeripheralSleepDisable(SYSCTL_PERIPH_I2C2);
//        //
//        //SysCtlPeripheralSleepEnable(SYSCTL_PERIPH_I2C3);
//        SysCtlPeripheralSleepDisable(SYSCTL_PERIPH_I2C3);
//        //
//        //SysCtlPeripheralSleepEnable(SYSCTL_PERIPH_I2C4);
//        SysCtlPeripheralSleepDisable(SYSCTL_PERIPH_I2C4);
//        //
//        //SysCtlPeripheralSleepEnable(SYSCTL_PERIPH_EEPROM0);
//        SysCtlPeripheralSleepDisable(SYSCTL_PERIPH_EEPROM0);
//        //
//        //SysCtlPeripheralSleepEnable(SYSCTL_PERIPH_SSI0);
//        SysCtlPeripheralSleepDisable(SYSCTL_PERIPH_SSI0);
//        //
//        //SysCtlPeripheralSleepEnable(SYSCTL_PERIPH_SSI1);
//        SysCtlPeripheralSleepDisable(SYSCTL_PERIPH_SSI1);
//        //
//        SysCtlPeripheralSleepEnable(SYSCTL_PERIPH_TIMER0);
//        //SysCtlPeripheralSleepDisable(SYSCTL_PERIPH_TIMER0);
//        //
//        //SysCtlPeripheralSleepEnable(SYSCTL_PERIPH_TIMER1);
//        SysCtlPeripheralSleepDisable(SYSCTL_PERIPH_TIMER1);
//        //
//        //SysCtlPeripheralSleepEnable(SYSCTL_PERIPH_TIMER2);
//        SysCtlPeripheralSleepDisable(SYSCTL_PERIPH_TIMER2);
//        //
//        //SysCtlPeripheralSleepEnable(SYSCTL_PERIPH_TIMER3);
//        SysCtlPeripheralSleepDisable(SYSCTL_PERIPH_TIMER3);
//        //
//        //SysCtlPeripheralSleepEnable(SYSCTL_PERIPH_TIMER4);
//        SysCtlPeripheralSleepDisable(SYSCTL_PERIPH_TIMER4);
//        //
//        //SysCtlPeripheralSleepEnable(SYSCTL_PERIPH_TIMER5);
//        SysCtlPeripheralSleepDisable(SYSCTL_PERIPH_TIMER5);
//        //
//        //SysCtlPeripheralSleepEnable(SYSCTL_PERIPH_UART0);
//        SysCtlPeripheralSleepDisable(SYSCTL_PERIPH_UART0);
//        //
//        SysCtlPeripheralSleepEnable(SYSCTL_PERIPH_UART1);
//        //SysCtlPeripheralSleepDisable(SYSCTL_PERIPH_UART1);
//        //
//        //SysCtlPeripheralSleepEnable(SYSCTL_PERIPH_UART2);
//        SysCtlPeripheralSleepDisable(SYSCTL_PERIPH_UART2);
//        //
//        //SysCtlPeripheralSleepEnable(SYSCTL_PERIPH_UART3);
//        SysCtlPeripheralSleepDisable(SYSCTL_PERIPH_UART3);
//        //
//        //SysCtlPeripheralSleepEnable(SYSCTL_PERIPH_UART4);
//        SysCtlPeripheralSleepDisable(SYSCTL_PERIPH_UART4);
//        //
//        //SysCtlPeripheralSleepEnable(SYSCTL_PERIPH_UART5);
//        SysCtlPeripheralSleepDisable(SYSCTL_PERIPH_UART5);
//        //
//        //SysCtlPeripheralSleepEnable(SYSCTL_PERIPH_UART6);
//        SysCtlPeripheralSleepDisable(SYSCTL_PERIPH_UART6);
//        //
//        //SysCtlPeripheralSleepEnable(SYSCTL_PERIPH_UART7);
//        SysCtlPeripheralSleepDisable(SYSCTL_PERIPH_UART7);
//        //
//        //SysCtlPeripheralSleepEnable(SYSCTL_PERIPH_UDMA);
//        SysCtlPeripheralSleepDisable(SYSCTL_PERIPH_UDMA);
//        //
//        //SysCtlPeripheralSleepEnable(SYSCTL_PERIPH_USB0);
//        SysCtlPeripheralSleepDisable(SYSCTL_PERIPH_USB0);
//        //
//        //SysCtlPeripheralSleepEnable(SYSCTL_PERIPH_WDOG0);
//        SysCtlPeripheralSleepDisable(SYSCTL_PERIPH_WDOG0);
//        //
//        SysCtlPeripheralSleepEnable(SYSCTL_PERIPH_WDOG1);
//        //SysCtlPeripheralSleepDisable(SYSCTL_PERIPH_WDOG1);
//        //
//}
//
///******************************************************************************
//* name:
//* description:
//* param description:
//* return value description:
//******************************************************************************/
//void ConfigureDeepSleep(void)
//{
//	//
//	// Which peripherals are enabled in sleep
//	// Peripherals should be enabled OR disabled
//	//
//	//SysCtlPeripheralDeepSleepEnable(SYSCTL_PERIPH_ADC0);
//	SysCtlPeripheralSleepDisable(SYSCTL_PERIPH_ADC0);
//	//
//	//SysCtlPeripheralDeepSleepEnable(SYSCTL_PERIPH_ADC1);
//	SysCtlPeripheralDeepSleepDisable(SYSCTL_PERIPH_ADC1);
//	//
//	//SysCtlPeripheralDeepSleepEnable(SYSCTL_PERIPH_CAN0);
//	SysCtlPeripheralDeepSleepDisable(SYSCTL_PERIPH_CAN0);
//	//
//	//SysCtlPeripheralDeepSleepEnable(SYSCTL_PERIPH_COMP0);
//	SysCtlPeripheralDeepSleepDisable(SYSCTL_PERIPH_COMP0);
//	//
//	//SysCtlPeripheralDeepSleepEnable(SYSCTL_PERIPH_GPIOA);
//	SysCtlPeripheralDeepSleepDisable(SYSCTL_PERIPH_GPIOA);
//	//
//	//SysCtlPeripheralDeepSleepEnable(SYSCTL_PERIPH_GPIOB);
//	SysCtlPeripheralDeepSleepDisable(SYSCTL_PERIPH_GPIOB);
//	//
//	//SysCtlPeripheralDeepSleepEnable(SYSCTL_PERIPH_GPIOC);
//	SysCtlPeripheralDeepSleepDisable(SYSCTL_PERIPH_GPIOC);
//	//
//	//SysCtlPeripheralDeepSleepEnable(SYSCTL_PERIPH_GPIOD);
//	SysCtlPeripheralDeepSleepDisable(SYSCTL_PERIPH_GPIOD);
//	//
//	//SysCtlPeripheralDeepSleepEnable(SYSCTL_PERIPH_GPIOE);
//	SysCtlPeripheralDeepSleepDisable(SYSCTL_PERIPH_GPIOE);
//	//
//	//SysCtlPeripheralDeepSleepEnable(SYSCTL_PERIPH_GPIOF);
//	SysCtlPeripheralDeepSleepDisable(SYSCTL_PERIPH_GPIOF);
//	//
//	//SysCtlPeripheralDeepSleepEnable(SYSCTL_PERIPH_HIBERNATE);
//	SysCtlPeripheralDeepSleepDisable(SYSCTL_PERIPH_HIBERNATE);
//	//
//	//SysCtlPeripheralDeepSleepEnable(SYSCTL_PERIPH_I2C0);
//	SysCtlPeripheralDeepSleepDisable(SYSCTL_PERIPH_I2C0);
//	//
//	//SysCtlPeripheralDeepSleepEnable(SYSCTL_PERIPH_I2C1);
//	SysCtlPeripheralDeepSleepDisable(SYSCTL_PERIPH_I2C1);
//	//
//	//SysCtlPeripheralDeepSleepEnable(SYSCTL_PERIPH_I2C2);
//	SysCtlPeripheralDeepSleepDisable(SYSCTL_PERIPH_I2C2);
//	//
//	//SysCtlPeripheralDeepSleepEnable(SYSCTL_PERIPH_I2C3);
//	SysCtlPeripheralDeepSleepDisable(SYSCTL_PERIPH_I2C3);
//	//
//	//SysCtlPeripheralDeepSleepEnable(SYSCTL_PERIPH_I2C4);
//	SysCtlPeripheralDeepSleepDisable(SYSCTL_PERIPH_I2C4);
//	//
//	//SysCtlPeripheralDeepSleepEnable(SYSCTL_PERIPH_EEPROM0);
//	SysCtlPeripheralDeepSleepDisable(SYSCTL_PERIPH_EEPROM0);
//	//
//	//SysCtlPeripheralDeepSleepEnable(SYSCTL_PERIPH_SSI0);
//	SysCtlPeripheralDeepSleepDisable(SYSCTL_PERIPH_SSI0);
//	//
//	//SysCtlPeripheralDeepSleepEnable(SYSCTL_PERIPH_SSI1);
//	SysCtlPeripheralDeepSleepDisable(SYSCTL_PERIPH_SSI1);
//	//
//	SysCtlPeripheralDeepSleepEnable(SYSCTL_PERIPH_TIMER0);
//	//SysCtlPeripheralDeepSleepDisable(SYSCTL_PERIPH_TIMER0);
//	//
//	//SysCtlPeripheralDeepSleepEnable(SYSCTL_PERIPH_TIMER1);
//	SysCtlPeripheralDeepSleepDisable(SYSCTL_PERIPH_TIMER1);
//	//
//	//SysCtlPeripheralDeepSleepEnable(SYSCTL_PERIPH_TIMER2);
//	SysCtlPeripheralDeepSleepDisable(SYSCTL_PERIPH_TIMER2);
//	//
//	//SysCtlPeripheralDeepSleepEnable(SYSCTL_PERIPH_TIMER3);
//	SysCtlPeripheralDeepSleepDisable(SYSCTL_PERIPH_TIMER3);
//	//
//	//SysCtlPeripheralDeepSleepEnable(SYSCTL_PERIPH_TIMER4);
//	SysCtlPeripheralDeepSleepDisable(SYSCTL_PERIPH_TIMER4);
//	//
//	//SysCtlPeripheralDeepSleepEnable(SYSCTL_PERIPH_TIMER5);
//	SysCtlPeripheralDeepSleepDisable(SYSCTL_PERIPH_TIMER5);
//	//
//	//SysCtlPeripheralDeepSleepEnable(SYSCTL_PERIPH_UART0);
//	SysCtlPeripheralDeepSleepDisable(SYSCTL_PERIPH_UART0);
//	//
//	//SysCtlPeripheralDeepSleepEnable(SYSCTL_PERIPH_UART1);
//	SysCtlPeripheralDeepSleepDisable(SYSCTL_PERIPH_UART1);
//	//
//	//SysCtlPeripheralDeepSleepEnable(SYSCTL_PERIPH_UART2);
//	SysCtlPeripheralDeepSleepDisable(SYSCTL_PERIPH_UART2);
//	//
//	//SysCtlPeripheralDeepSleepEnable(SYSCTL_PERIPH_UART3);
//	SysCtlPeripheralDeepSleepDisable(SYSCTL_PERIPH_UART3);
//	//
//	//SysCtlPeripheralDeepSleepEnable(SYSCTL_PERIPH_UART4);
//	SysCtlPeripheralDeepSleepDisable(SYSCTL_PERIPH_UART4);
//	//
//	//SysCtlPeripheralDeepSleepEnable(SYSCTL_PERIPH_UART5);
//	SysCtlPeripheralDeepSleepDisable(SYSCTL_PERIPH_UART5);
//	//
//	//SysCtlPeripheralDeepSleepEnable(SYSCTL_PERIPH_UART6);
//	SysCtlPeripheralDeepSleepDisable(SYSCTL_PERIPH_UART6);
//	//
//	//SysCtlPeripheralDeepSleepEnable(SYSCTL_PERIPH_UART7);
//	SysCtlPeripheralDeepSleepDisable(SYSCTL_PERIPH_UART7);
//	//
//	//SysCtlPeripheralDeepSleepEnable(SYSCTL_PERIPH_UDMA);
//	SysCtlPeripheralDeepSleepDisable(SYSCTL_PERIPH_UDMA);
//	//
//	//SysCtlPeripheralDeepSleepEnable(SYSCTL_PERIPH_USB0);
//	SysCtlPeripheralDeepSleepDisable(SYSCTL_PERIPH_USB0);
//	//
//	//SysCtlPeripheralDeepSleepEnable(SYSCTL_PERIPH_WDOG0);
//	SysCtlPeripheralDeepSleepDisable(SYSCTL_PERIPH_WDOG0);
//	//
//	SysCtlPeripheralDeepSleepEnable(SYSCTL_PERIPH_WDOG1);
//	//SysCtlPeripheralDeepSleepDisable(SYSCTL_PERIPH_WDOG1);
//	//
//}

/******************************************************************************
* name: eBSP_ADC_Start
* description: Starts or stops the ADC depending on the parameter
* param description: bool - true: start the ADC
*                         - false: stop the ADC
* return value description: ERROR_CODE - ER_OK: pin to adc was set/cleared
*                                      - ER_FAIL: pin to adc was not set/cleared
******************************************************************************/
ERROR_CODE  eBSP_ADC_Start(bool bStart)
{
  ERROR_CODE eEC = ER_FAIL;
  uint32_t uiPin_Read;

  if(bStart == true)
  {
    GPIO_write(EK_TM4C123GXL_ADC_START, INEEDMD_ADC_START_PIN_SET);

    uiPin_Read = GPIO_read(EK_TM4C123GXL_ADC_START);
    if((uiPin_Read & INEEDMD_ADC_START_PIN) == INEEDMD_ADC_START_PIN_SET)
    {
      eEC = ER_OK;
    }
    else
    {
      eEC = ER_FAIL;
    }
  }
  else
  {
    GPIO_write(EK_TM4C123GXL_ADC_START, INEEDMD_ADC_START_PIN_CLEAR);

    uiPin_Read = GPIO_read(EK_TM4C123GXL_ADC_START);
    if((uiPin_Read & INEEDMD_ADC_START_PIN) == INEEDMD_ADC_START_PIN_CLEAR)
    {
      eEC = ER_OK;
    }
    else
    {
      eEC = ER_FAIL;
    }
  }

  return eEC;
}

/******************************************************************************
* name: eBSP_ADC_Hard_Reset
* description: do a hardware reset by pulling reset low
* param description:
*
* return value description: ERROR_CODE - ER_OK: reset successful
*                                      - ER_FAIL: reset fail
******************************************************************************/
ERROR_CODE eBSP_ADC_Hard_Reset(void)
{
  ERROR_CODE eEC = ER_FAIL;
  uint32_t uiPin_Read;
  //toggle reset pin
//  GPIOPinWrite(GPIO_PORTA_BASE, INEEDMD_PORTA_ADC_RESET_OUT_PIN, 0x00);
  GPIO_write(EK_TM4C123GXL_ADC_RESET, INEEDMD_ADC_RESET_PIN_CLEAR);
  uiPin_Read = GPIO_read(EK_TM4C123GXL_ADC_RESET);
  if((uiPin_Read & INEEDMD_ADC_RESET_PIN) == INEEDMD_ADC_RESET_PIN_CLEAR)
  {
    iHW_delay(3);

    //  GPIOPinWrite(GPIO_PORTA_BASE, INEEDMD_PORTA_ADC_RESET_OUT_PIN, INEEDMD_PORTA_ADC_RESET_OUT_PIN);
    GPIO_write(EK_TM4C123GXL_ADC_RESET, INEEDMD_ADC_RESET_PIN_SET);
    uiPin_Read = GPIO_read(EK_TM4C123GXL_ADC_RESET);
    if((uiPin_Read & INEEDMD_ADC_RESET_PIN) == INEEDMD_ADC_RESET_PIN_SET)
    {
      eEC = ER_OK;
      iHW_delay(3);
    }
    else
    {
      eEC = ER_FAIL;
    }
  }
  else
  {
    eEC = ER_FAIL;
  }

  return eEC;
}

/******************************************************************************
* name: eBSP_ADC_Power
* description: ads1198 power on sequence. toggles pwdn and reset, waits for device to start
*              wakes with continuous conversions enabled
*              call INEEDMD_ADC_Stop_Continuous_Conv or send SDATAC before attempting to read/write registers
* param description: bool - true: power on the ADC
*                         - false: power off the ADC
* return value description: ERROR_CODE - ER_OK
*                                      - ER_FAIL
******************************************************************************/
ERROR_CODE  eBSP_ADC_Power(bool bPower)
{
  ERROR_CODE eEC = ER_FAIL;

  if(bPower == true)
  {
    //disables clocking into Rx FIFO buffer
    //SSIAdvModeSet(INEEDMD_ADC_SPI, SSI_ADV_MODE_WRITE);

//    SSIEnable(INEEDMD_ADC_SPI);

    //power up and raise reset (active low pins)
    GPIO_write(EK_TM4C123GXL_ADC_POWER, INEEDMD_ADC_PWR_PIN_SET);
//    GPIOPinWrite(GPIO_PORTA_BASE, INEEDMD_PORTA_ADC_PWRDN_OUT_PIN, INEEDMD_PORTA_ADC_PWRDN_OUT_PIN);

    GPIO_write(EK_TM4C123GXL_ADC_RESET, INEEDMD_ADC_RESET_PIN_SET);
//    GPIOPinWrite(GPIO_PORTA_BASE, INEEDMD_PORTA_ADC_RESET_OUT_PIN, INEEDMD_PORTA_ADC_RESET_OUT_PIN);
    //Important - wait at least 2^16 device clocks before reset - 32ms using internal clock on ADS1198/ADC front end

    //todo: check pins were written to
    eEC = ER_OK;

  }
  else
  {

    //takes the ~rest line low putting the ADS1198 into reset
//    GPIOPinWrite(GPIO_PORTA_BASE, INEEDMD_PORTA_ADC_RESET_OUT_PIN, 0x00);
//    //takes the ~powerdn line low putting the ADS1198 into low power mode
//    GPIOPinWrite(GPIO_PORTA_BASE, INEEDMD_PORTA_ADC_PWRDN_OUT_PIN, 0x00);
//
//    bIs_adc_powered_on = false;

    eEC = ER_FAIL;

  }

  return eEC;
}

/******************************************************************************
* name: eBSP_ADC_Continuous_Conv
* description: sets continuous conversions.
* for false: if START pin is high or a START command received (if START pin is low)
*  conversions are put into outbound Tx(MISO) FIFO
*  when a RDATA command is received
*  Clock data out using ineedmd_adc_Receive_Conversion
*
* for true:If start pin is high or START command is received
*  conversions are automatically put into outbound Tx(MISO) FIFO when ready (DRDY goes low)
*  use INEEDMD_ADC_Receive_Conversion so shift data through MISO
* param description: bool - true:
*                         - false:
* return value description: type - value: value description
******************************************************************************/
ERROR_CODE eBSP_ADC_Continuous_Conv(bool bConversions)
{
  ERROR_CODE eEC = ER_FAIL;
  bool bDid_spi_trans = false;
  SPI_Transaction tSPI_transaction;
  uint8_t uiSPI_TX_Byte_buff = 0;
  uint8_t uiSPI_RX_Byte_buff = 0;

  //check if conversions should be started
  if(bConversions == false)
  {
    //conversions are to be halted
    //
    //set the CS low
//    GPIOPinWrite(GPIO_PORTA_BASE, INEEDMD_PORTA_ADC_nCS_PIN, 0x00);
    GPIO_write(EK_TM4C123GXL_ADC_nCS, INEEDMD_ADC_nCS_PIN_CLEAR);

    iHW_delay(3);

//    SSIDataPut(INEEDMD_ADC_SPI, ADS1198_SDATAC);
//    while(SSIBusy(INEEDMD_ADC_SPI)){}
    tSPI_transaction.count = sizeof(uiSPI_TX_Byte_buff);
    uiSPI_TX_Byte_buff = ADS1198_SDATAC;
    tSPI_transaction.txBuf = (void *)&uiSPI_TX_Byte_buff;
    tSPI_transaction.rxBuf = (void *)&uiSPI_RX_Byte_buff;

    bDid_spi_trans = SPI_transfer(tSPI_ADC_handle, &tSPI_transaction);
    if(bDid_spi_trans == true)
    {
      eEC = ER_OK;
    }
    else
    {
      eEC = ER_FAIL;
    }


    //when done set the CS high
//    GPIOPinWrite(GPIO_PORTA_BASE, INEEDMD_PORTA_ADC_nCS_PIN, INEEDMD_PORTA_ADC_nCS_PIN);
    GPIO_write(EK_TM4C123GXL_ADC_nCS, INEEDMD_ADC_nCS_PIN_SET);
  }
  else
  {
//    //conversions are to be started
//    //
//    //set the CS low
//    GPIOPinWrite(GPIO_PORTA_BASE, INEEDMD_PORTA_ADC_nCS_PIN, 0x00);
//    //2us at fullmspeed
//      iHW_delay(1);
//
//    SSIDataPut(INEEDMD_ADC_SPI, ADS1198_RDATAC);
//    while(SSIBusy(INEEDMD_ADC_SPI))
//    {
//    }
//    //when done set the CS high
//    GPIOPinWrite(GPIO_PORTA_BASE, INEEDMD_PORTA_ADC_nCS_PIN, INEEDMD_PORTA_ADC_nCS_PIN);
    eEC = ER_OK;
  }

  return eEC;
}


/******************************************************************************
* name: eBSP_ADC_SPI_Enable
* description: enables the SPI to the ADC
* param description:
*
* return value description: ERROR_CODE - ER_OK
*                                      - ER_FAIL
******************************************************************************/
ERROR_CODE eBSP_ADC_SPI_Enable(void)
{
  ERROR_CODE eEC = ER_FAIL;;

  SPI_Params_init(&tSPI_ADC_params);

  //
  // Configuring the SPI port and pins to talk to the analog front end
  // SPI0_BASE is mapped to INEEDMD_ADC_SPI
  //
//  MAP_SysCtlPeripheralEnable(SYSCTL_PERIPH_SSI0);
//  //no need for a majik delay as we are configuring the GPIO pins as well...
//  MAP_GPIOPinTypeGPIOOutput(GPIO_PORTA_BASE, INEEDMD_PORTA_ADC_PWRDN_OUT_PIN);
//  // power UP the ADC
//  MAP_GPIOPinWrite(GPIO_PORTA_BASE, INEEDMD_PORTA_ADC_PWRDN_OUT_PIN, INEEDMD_PORTA_ADC_PWRDN_OUT_PIN);
//  // Enable pin PA6 for GPIOOutput
//  MAP_GPIOPinTypeGPIOOutput(GPIO_PORTA_BASE, INEEDMD_PORTA_ADC_RESET_OUT_PIN);
//  // Enable pin PA0 for GPIOInput
//  MAP_GPIOPinTypeGPIOInput(GPIO_PORTA_BASE, INEEDMD_PORTA_ADC_INTERUPT_PIN);
//  // Enable pin PA1 for GPIOOutput
//  MAP_GPIOPinTypeGPIOOutput(GPIO_PORTA_BASE, INEEDMD_PORTA_ADC_START_PIN);
//  //set the nCS pin as a GPIO
//  MAP_GPIOPinTypeGPIOOutput(GPIO_PORTA_BASE, INEEDMD_PORTA_ADC_nCS_PIN);
  // Enable pin PA2 for SSI0 SSI0CLK
  //
//  MAP_GPIOPinConfigure(GPIO_PA2_SSI0CLK);
//  MAP_GPIOPinTypeSSI(GPIO_PORTA_BASE, GPIO_PIN_2);
//  //
//  // Enable pin PA5 for SSI0 SSI0TX
//  //
//  MAP_GPIOPinConfigure(GPIO_PA5_SSI0TX);
//  MAP_GPIOPinTypeSSI(GPIO_PORTA_BASE, GPIO_PIN_5);
//  //
//  // Enable pin PA3 for SSI0 SSI0FSS
//  //
//  //MAP_GPIOPinConfigure(GPIO_PA3_SSI0FSS);
//  //MAP_GPIOPinTypeSSI(GPIO_PORTA_BASE, GPIO_PIN_3);
//  //
//  // Enable pin PA4 for SSI0 SSI0RX
//  //
//  MAP_GPIOPinConfigure(GPIO_PA4_SSI0RX);
//  MAP_GPIOPinTypeSSI(GPIO_PORTA_BASE, GPIO_PIN_4);
//
//  MAP_SSIClockSourceSet(INEEDMD_ADC_SPI, SSI_CLOCK_PIOSC);

  //set SSI for 1MHz clock and 8 bit data, master mode
//  SSIConfigSetExpClk(INEEDMD_ADC_SPI, INEEDMD_SPI_CLK, SSI_FRF_MOTO_MODE_2, SSI_MODE_MASTER, 1000000, 8);
//  SSIEnable(INEEDMD_ADC_SPI);

  tSPI_ADC_params.bitRate = 1000000;
  tSPI_ADC_params.dataSize = 8;
  tSPI_ADC_params.mode = SPI_MASTER;
  tSPI_ADC_params.transferMode = SPI_MODE_BLOCKING;
  tSPI_ADC_params.frameFormat = SPI_POL1_PHA0;

  tSPI_ADC_handle = SPI_open(EK_TM4C123GXL_SPI_ADC, &tSPI_ADC_params);

  if(tSPI_ADC_handle == NULL)
  {
    eEC = ER_FAIL;
  }
  else
  {
    eEC = ER_OK;
  }

  return eEC;
}


////*****************************************************************************
//// name: eMaster_int_enable
//// description:
//// param description:
//// return value description:
////*****************************************************************************
//ERROR_CODE eMaster_int_enable(void)
//{
//  ERROR_CODE eEC = ER_OK;
//  MAP_IntMasterEnable();
//  return eEC;
//}

///******************************************************************************
//* name: eMaster_int_disable
//* description:
//* param description:
//* return value description:
//******************************************************************************/
ERROR_CODE eMaster_int_disable(void)
{
  ERROR_CODE eEC = ER_FAIL;
  //todo implement master disable for TI-RTOS
//  MAP_IntMasterDisable();
  return eEC;
}
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
