Hoxford/tyler-woogduh/application/ineedmd_command_protocol.c

//*****************************************************************************
//
// ineedmd_command_protocol.c - command protocol for ineedMD. Contains the api,
//  input, output and parsers.
//
// Copyright (c) notice
//
//*****************************************************************************
#ifndef __INEEDMD_COMMAND_PROTOCOL_C__
#define __INEEDMD_COMMAND_PROTOCOL_C__
/******************************************************************************
* includes ////////////////////////////////////////////////////////////////////////////////////////////////////////////////////////////////////////////////////
******************************************************************************/
#include <stdbool.h>
#include <stdint.h>
#include <stdio.h>
#include <string.h>
#include <stdarg.h>
#include <stdlib.h>

#include "inc/hw_types.h"
#include "inc/hw_memmap.h"
#include "inc/hw_gpio.h"
#include "inc/hw_nvic.h"
#include "driverlib/rom.h"
#include "driverlib/sysctl.h"
#include "driverlib/pin_map.h"
#include "driverlib/rom_map.h"
#include "driverlib/gpio.h"
#include "driverlib/uart.h"
#include "driverlib/timer.h"
#include "driverlib/interrupt.h"
#include "driverlib/adc.h"

#include "utils_inc/error_codes.h"
#include "board.h"

#include "drivers_inc/battery.h"

#include "app_inc/ineedmd_command_protocol.h"
#include "app_inc/ineedmd_waveform.h"
#include "app_inc/ineedmd_watchdog.h"
#include "app_inc/ineedmd_UI.h"
#include "drivers_inc/ineedmd_bluetooth_radio.h"
#include "drivers_inc/ineedmd_adc.h"
#include "drivers_inc/ineedmd_USB.h"
#include "utils_inc/proj_debug.h"

#include "app_inc/ineedmd_power_control.h"

#include "utils_inc/osal.h"

/******************************************************************************
* defines /////////////////////////////////////////////////////////////////////////////////////////////////////////////////////////////////////////////////////
******************************************************************************/
//Protocol frame defines
#define PROTOCOL_FRAME_MAX_LEN          128
#define PROTOCOL_FRAME_START_BYTE       0x9C
#define PROTOCOL_FRAME_END_BYTE         0xC9
#define PROTOCOL_FRAME_ACK_LEN          4
#define PROTOCOL_FRAME_NACK_LEN         4
#define PROTOCOL_FRAME_CMND_TYPE_INDEX  1
#define PROTOCOL_FRAME_CMND_LEN_INDEX   2
#define PROTOCOL_FRAME_CMND_ID_INDEX    3

#define STATUS_0X14_LEN 23
#define STATUS_0X17_LEN 24
#define STATUS_0X15_LEN 23
#define STATUS_LEN      18

//protocol connection defines
#define PROTOCOL_CONN_TIMEOUT_1MIN    60000
#define PROTOCOL_CONN_TIMEOUT_FOREVER 0

#ifdef DEBUG
  #define printf        vDEBUG
  #define PrintCommand  vCMND_ECHO_FRAME
  #define debug_out     vDEBUG
#else
//  #define printf(a, __VA_ARGS__)
  #define printf(a,...)
  #define PrintCommand(a,x)
//  #define debug_out(c,__VA_ARGS__)
  #define debug_out(c,...)
#endif //DEBUG

#define DFU_REQ_MAX_TEMP    1000
#define DFU_REQ_MIN_TEMP    340
#define DFU_REQ_EKG_HALT_TIMEOUT    100
#define DFU_REQ_EKG_SHTDWN_TIMEOUT    100

/******************************************************************************
* variables ///////////////////////////////////////////////////////////////////////////////////////////////////////////////////////////////////////////////////
******************************************************************************/
bool bIs_protocol_connection = false;
bool bDid_radio_rfd = false;
bool bDid_radio_send_frame = false;
bool bIs_radio_on = false;
bool bDid_ekg_halt = false;
bool bDid_ekg_shtdwn = false;

//static uint8_t uiINMD_Protocol_frame[INMD_FRAME_BUFF_SIZE];
////static uint16_t uiINMD_Protocol_frame_len = 0;
//
//static bool bIs_protocol_frame = false;
//
////static const int dataApplicable[7] = { 0, 1, 0, 1, 1, 1, 1 };
//static char NACK[NACK_FRAME_SIZE]; //this is a string
//static char ACK[ACK_FRAME_SIZE]; //this too is a string
////static const char status0X11[] = { 0x9C, 0x01, 0x11, 0x01, 0x64, 0x50, 0x0B, 0xB8, 0xD7, 0x68, 0x56, 0x00, 0xC0, 0x00, 0x00, 0x00, 0xC9 }; //reply for high voltage query.
////static const char status0x13[] = { 0x9C, 0x04, 0x20, 0x21, 0x22,0xC9 };
////static const char status0x14[] = { 0x9C, 0x04, 0x20, 0x21, 0x22, 0xC9 };
////static const char status0x15[] = { 0x9C, 0x03, 0x0E, 0x16, 0x03, 0x10, 0x0A, 0x9C, 0xC9, 0xC9, 0x0E, 0x2C, 0x9C, 0xC9 };

/******************************************************************************
* external variables //////////////////////////////////////////////////////////////////////////////////////////////////////////////////////////////////////////
******************************************************************************/

/******************************************************************************
* enums ///////////////////////////////////////////////////////////////////////////////////////////////////////////////////////////////////////////////////////
******************************************************************************/
typedef enum eINDM_Cmnd_Proto_msg
{
  CMND_MSG_NONE,
  CMND_MSG_WAKEUP,
  CMND_MSG_SLEEP,
  CMND_MSG_PROTOCOL_FRAME,
  CMND_MSG_INTERFACE_ESTABLISHED,
  CMND_MSG_PROTOCOL_INTERFACE_ESTABLISHED,
  CMND_MSG_PROTOCOL_INTERFACE_CLOSED,
}eINDM_Cmnd_Proto_msg;

typedef enum eINMD_protocol_packet_type
{
  DATAGRAM_TYPE_COMMAND = 0x01,
  DATAGRAM_TYPE_STATUS_INFO = 0x02,
  DATAGRAM_TYPE_DATA = 0x03,
  DATAGRAM_TYPE_REAL_TIME_DATA = 0x04,
  DATAGRAM_TYPE_STORED_DATA = 0x05
}eINMD_Cmnd_packet_type;

typedef enum eINMD_protocol_command_id
{
  COMMAND_ID_REQUEST_STATUS  = 0x11,
  COMMAND_ID_SET_STATUS = 0x12,
  COMMAND_ID_GET_DATA_SET_INFO = 0x13,
  COMMAND_ID_DATA_SET_TRANSFER = 0x14,
  COMMAND_ID_ERASE_DATA_SET = 0x15,
  COMMAND_ID_CAPTURE_DATA_SET = 0x16,
  COMMAND_ID_STREAM_DATA = 0x17,
  COMMAND_ID_REQUEST_TO_TEST = 0x18
}eINMD_protocol_command_id;

/******************************************************************************
* structures //////////////////////////////////////////////////////////////////////////////////////////////////////////////////////////////////////////////////
******************************************************************************/
extern Mailbox_Handle tTIRTOS_cmnd_protocol_mailbox;

typedef struct tProtocol_msg_struct
{
  eINDM_Cmnd_Proto_msg eMsg;
  uint8_t   uiCmnd_Frame[PROTOCOL_FRAME_MAX_LEN];
  uint32_t  uiCmnd_Frame_len;
}tProtocol_msg_struct;

/******************************************************************************
* external functions //////////////////////////////////////////////////////////////////////////////////////////////////////////////////////////////////////////
******************************************************************************/

//extern void check_for_update(void);
/******************************************************************************
* private function declarations ///////////////////////////////////////////////////////////////////////////////////////////////////////////////////////////////
******************************************************************************/
void       vRadio_connection_callback      (eRadio_connection_state eRadio_conn);
void       vRadio_change_settings_callback (eRadio_Settings eRadio_Setting);
void       vRadio_sent_frame_callback      (uint32_t uiCount);
void       vRadio_setup_callback(eRadio_setup_state eState);
void       vEKG_halt_request_callback(uint32_t uiData, bool bEKG_running);
void       vEKG_shtdwn_request_callback(uint32_t uiData, bool bEKG_on);
ERROR_CODE eIneedmd_send_ack(void);  //send protocol acknowledgement
ERROR_CODE eIneedmd_send_nack(void);  //send protocol fail acknowledgement
ERROR_CODE eParse_Protocol_Frame(uint8_t * pRcvd_protocol_frame, uint32_t uiRcvd_frame_len);
ERROR_CODE eValidatePacketType(eINMD_Cmnd_packet_type eProtocolFrameType);
ERROR_CODE eValidateCommandID(eINMD_Cmnd_packet_type eProtocolFrameType, eINMD_protocol_command_id szRecCommand);
ERROR_CODE eCommand_led_test(INMD_LED_COMMAND eInmd_LED_cmnd);

ERROR_CODE eCommand_enable_test_signal(uint8_t signal);
ERROR_CODE eCommand_stop_test_signal();
ERROR_CODE eCommand_DFU(void);
ERROR_CODE eCommand_reset_test();
ERROR_CODE eCommand_set_status(uint8_t* statusToSet);
ERROR_CODE eCommand_capture_data(uint8_t* duration);
ERROR_CODE eCommand_get_data_set_info(uint8_t* dataSet);
ERROR_CODE eCommand_transfer_data_set(uint8_t* dataSet);
ERROR_CODE eCommand_erase_data_set(uint8_t* dataSet);
ERROR_CODE eCommand_send_status();
ERROR_CODE eCommand_stream_data(uint8_t bRealTime);
////int debug_out(char * cOut_buff,...);

void writeDataToPort(unsigned char * cOut_buff, uint16_t uiLen);
ERROR_CODE eCheckAlarmBytes(const unsigned char *Frame, int noPosh, int *ackFlag);
ERROR_CODE eCheckTimeBytes(const unsigned char *Frame, int noPosh, int *ackFlag);
#ifdef PrintCommand
  void vCMND_ECHO_FRAME(const unsigned char * uiFrame, uint16_t uiFrame_len);
#endif

/******************************************************************************
* private functions ///////////////////////////////////////////////////////////////////////////////////////////////////////////////////////////////////////////
******************************************************************************/
void vRadio_connection_callback(eRadio_connection_state eRadio_conn)
{
  tINMD_protocol_req_notify tCmnd_Req_Notify;
  ERROR_CODE eEC = ER_FAIL;
  eIneedmd_cmnd_Proto_ReqNote_params_init(&tCmnd_Req_Notify);

  if(eRadio_conn == RADIO_CONN_NONE)
  {
    tCmnd_Req_Notify.eReq_Notify = CMND_NOTIFY_PROTOCOL_INTERFACE_TIME_OUT;
    eEC = ER_OK;
  }
  else if(eRadio_conn == RADIO_CONN_CONNECTED)
  {
    bIs_protocol_connection = true;
    tCmnd_Req_Notify.eReq_Notify = CMND_NOTIFY_PROTOCOL_INTERFACE_ESTABLISHED;
    eEC = ER_OK;
  }

  if(eEC == ER_OK)
  {
    eIneedmd_cmnd_Proto_Request_Notify(&tCmnd_Req_Notify);
  }
  return;
}

void vRadio_change_settings_callback(eRadio_Settings eRadio_Setting)
{
  if(eRadio_Setting == RADIO_SETTINGS_RFD)
  {
    bDid_radio_rfd = true;
  }else{/*do nothing*/}

  return;
}

void vRadio_sent_frame_callback(uint32_t uiCount)
{
  bDid_radio_send_frame = true;

  return;
}

void vRadio_setup_callback(eRadio_setup_state eState)
{
  if(eState == RDIO_SETUP_READY)
  {
    bIs_radio_on = true;
  }
  else if(eState == RDIO_SETUP_RADIO_READY_POWERED_OFF)
  {
    bIs_radio_on = false;
  }

}

void vEKG_halt_request_callback(uint32_t uiData, bool bEKG_running)
{
  if(bEKG_running == false)
  {
    bDid_ekg_halt = true;
  }
  else
  {
    bDid_ekg_halt = false;
  }

  return;
}

void vEKG_shtdwn_request_callback(uint32_t uiData, bool bEKG_on)
{
  if(bEKG_on == false)
  {
    bDid_ekg_shtdwn = true;
  }
  else
  {
    bDid_ekg_shtdwn = false;
  }

  return;
}

/******************************************************************************
* name: eIneedmd_send_ack
* description:
* param description: void
* return value description: ERROR_CODE - ER_OK:
*                                        ER_FAIL:
******************************************************************************/
ERROR_CODE eIneedmd_send_ack(void)
{
  ERROR_CODE eEC = ER_FAIL;
  uint8_t ACK_[PROTOCOL_FRAME_ACK_LEN] = {0x9c, 0x00, 0x04, 0xC9};
  tRadio_request tRequest;
  eEC = eIneedmd_radio_request_params_init (&tRequest);

  if(eEC == ER_OK)
  {
    bDid_radio_send_frame = false;

    tRequest.eRequest = RADIO_REQUEST_SEND_FRAME;
    memcpy(tRequest.uiBuff, ACK_, PROTOCOL_FRAME_ACK_LEN);
    tRequest.uiBuff_size = PROTOCOL_FRAME_ACK_LEN;
    tRequest.eTX_Priority = TX_PRIORITY_QUEUE;
    tRequest.vBuff_sent_callback = &vRadio_sent_frame_callback;
    eEC = eIneedmd_radio_request(&tRequest);
  }else{/*do nothing*/}

  if(eEC == ER_OK)
  {
    while(bDid_radio_send_frame == false)
    {
      Task_sleep(100);
    }
  }

  vDEBUG("ACK");

  return eEC;
}

/******************************************************************************
* name: eIneedmd_send_nack
* description:
* param description: void
* return value description: ERROR_CODE - ER_OK:
*                                        ER_FAIL:
******************************************************************************/
ERROR_CODE eIneedmd_send_nack(void)
{
  ERROR_CODE eEC = ER_FAIL;
  uint8_t NACK_[PROTOCOL_FRAME_NACK_LEN] = {0x9c, 0xFF, 0x04, 0xC9};
  tRadio_request tRequest;
  eEC = eIneedmd_radio_request_params_init (&tRequest);

  if(eEC == ER_OK)
  {
    bDid_radio_send_frame = false;
    tRequest.eRequest = RADIO_REQUEST_SEND_FRAME;
    memcpy(tRequest.uiBuff, NACK_, PROTOCOL_FRAME_NACK_LEN);
    tRequest.uiBuff_size = PROTOCOL_FRAME_NACK_LEN;
    tRequest.eTX_Priority = TX_PRIORITY_QUEUE;
    tRequest.vBuff_sent_callback = &vRadio_sent_frame_callback;
    eEC = eIneedmd_radio_request(&tRequest);
  }else{/*do nothing*/}

  while(bDid_radio_send_frame == false)
  {
    Task_sleep(100);
  }
  vDEBUG("NACK\n");
  //printf("NACK\n");

  return eEC;
}

//*****************************************************************************
// name:
// description:
// param description:
// return value description:
//*****************************************************************************
void writeDataToPort(unsigned char * cOut_buff, uint16_t uiLen)
{
  ERROR_CODE eEC = ER_FAIL;
  tRadio_request tRequest;

  eEC = eIneedmd_radio_request_params_init (&tRequest);
  if(eEC == ER_OK)
  {
    bDid_radio_send_frame = false;

    tRequest.eRequest = RADIO_REQUEST_SEND_FRAME;
    memcpy(tRequest.uiBuff, cOut_buff, uiLen);
    tRequest.uiBuff_size = uiLen;
    tRequest.eTX_Priority = TX_PRIORITY_QUEUE;
    tRequest.vBuff_sent_callback = &vRadio_sent_frame_callback;
    eEC = eIneedmd_radio_request(&tRequest);

    if(eEC == ER_OK)
    {
      while(bDid_radio_send_frame == false)
      {
        //todo: need timeout
        Task_sleep(1);
      }
//    ineedmd_radio_send_frame((uint8_t *)cOut_buff, uiLen);
    }else{/*do nothing*/}
  }

  return;
}

/******************************************************************************
* name: eParse_Protocol_Frame
* description:
* param description: uint8_t - pointer: pointer to the buffer containing the protocol frame
* return value description: ERROR_CODE - ER_OK:
******************************************************************************/
ERROR_CODE eParse_Protocol_Frame(uint8_t * pRcvd_protocol_frame, uint32_t uiRcvd_frame_len)
{
  ERROR_CODE eEC = ER_FAIL;
  eINMD_Cmnd_packet_type    eProtocolFrameType;//dataPacketType;// = ucProtocol_Frame[1];
  eINMD_protocol_command_id eProtocolFrameCommandID;//actCommand;    // = ucProtocol_Frame[3];

  //TODO: not needed?
  //unsigned char cntDataBytes;
  tUI_request tUI_request_params;
  tRadio_request tRadio_request_Params;

  eProtocolFrameType      = (eINMD_Cmnd_packet_type)   pRcvd_protocol_frame[PROTOCOL_FRAME_CMND_TYPE_INDEX];
  eProtocolFrameCommandID = (eINMD_protocol_command_id)pRcvd_protocol_frame[PROTOCOL_FRAME_CMND_ID_INDEX];

  //cntDataBytes = ucProtocolFrameLength - 5;

  eEC = eValidatePacketType(eProtocolFrameType);
  if(eEC == ER_OK)
  {
    eEC = eValidateCommandID(eProtocolFrameType, eProtocolFrameCommandID);
    if (eEC == ER_FAIL)
    {
      printf("\nCommand - %X is invalid for DataPacketType - %X!", eProtocolFrameCommandID, eProtocolFrameType);
      printf("\nSending NACK...");
      eIneedmd_send_nack();
    }
    else if (eEC == ER_INVALID)
    {
      printf("\nCommand - %X is currently not supported for DataPacketType - %X!", eProtocolFrameCommandID, eProtocolFrameType);
      printf("\nSending NACK...");
      eIneedmd_send_nack();
    }
    else
    {
      //command ID good, length and packet check passed
      switch (eProtocolFrameCommandID)
      {

        case COMMAND_ID_SET_STATUS: //status
        {

          eEC = eCommand_set_status(&pRcvd_protocol_frame[COMMAND_DATA_BYTE]);
          if(eEC == ER_OK)
          {
            eIneedmd_send_ack();
          }
          else
          {
            eIneedmd_send_nack();
            eEC = ER_OK;
          }
          break;
        }
        case COMMAND_ID_CAPTURE_DATA_SET: //capture data set
        {

          eEC = eCommand_capture_data(&pRcvd_protocol_frame[COMMAND_DATA_BYTE]);

          if(eEC == ER_OK)
          {
            eIneedmd_send_ack();
          }
          else
          {
            eIneedmd_send_nack();
            eEC = ER_OK;
          }
          break;
        }
        case COMMAND_ID_GET_DATA_SET_INFO: //get data set info
        {
          eEC = eCommand_get_data_set_info(&pRcvd_protocol_frame[COMMAND_DATA_BYTE]);
          if(eEC == ER_OK)
          {
            eIneedmd_send_ack();
          }
          else
          {
            eIneedmd_send_nack();
            eEC = ER_OK;
          }
          break;
        }
        case COMMAND_ID_DATA_SET_TRANSFER://data set transfer command  --  NAK or (ACK + respective data set corresponding to the id sent). For now, ACK.
        {
          eEC = eCommand_transfer_data_set(&pRcvd_protocol_frame[COMMAND_DATA_BYTE]);
          if(eEC == ER_OK)
          {
            eIneedmd_send_ack();
          }
          else
          {
            eIneedmd_send_nack();
            eEC = ER_OK;
          }
          break;
        }
        case COMMAND_ID_ERASE_DATA_SET://erase data set
        {

          //data set ID, 2bytes
          eEC = eCommand_erase_data_set(&pRcvd_protocol_frame[COMMAND_DATA_BYTE]);
          if(eEC == ER_OK)
          {
            eIneedmd_send_ack();
          }
          else
          {
            eIneedmd_send_nack();
            eEC = ER_OK;
          }
          break;
        }
        case COMMAND_ID_REQUEST_STATUS://get status.
        {
          eEC = eCommand_send_status();
          if(eEC == ER_OK)
          {
            eIneedmd_send_ack();
          }
          else
          {
            eIneedmd_send_nack();
            eEC = ER_OK;
          }
          

          break;
        }
        case COMMAND_ID_STREAM_DATA:
        {
          eEC = eCommand_stream_data(pRcvd_protocol_frame[COMMAND_DATA_BYTE]);
          if(eEC == ER_OK)
          {
            eIneedmd_send_ack();
          }
          else
          {
            eIneedmd_send_nack();
            eEC = ER_OK;
          }
          //todo: this if statement is just a catch to prevent a "statement is unreachable" warning
          //Remove the if statement when COMMAND_ID_STREAM_DATA is implemented
          if(eProtocolFrameCommandID == COMMAND_ID_STREAM_DATA)
          {
            printf("Parse cmnd SYS HALT, ACT command 0x17 not implemented yet");
            while(1){};
          }
          else
          {
//  todo: frameCnt was not set properly, this code to be implemented later
//          switch (ucProtocol_Frame[frameCnt - 1])
//          {
//          case 0xFF: //true
//            isRealStream = 1;
//            counter = 0;
//            printf("\nBegin real-time streaming -- TRUE... ");
//            //writeDataToPort(ACK);
//            printf("\nReceived request for Real time DataSet Transfer... ");
//            PrintCommand(status0x17, 24);
//            sprintf(replyToSend, "%X %X %X %X %X %X %X %X %X %X %X %X %X %X %X %X %X %X %X %X %X %X %X %X ",
//              status0x17[0], status0x17[1], status0x17[2], status0x17[3],
//              status0x17[4], status0x17[5], status0x17[6], status0x17[7],
//              status0x17[8], status0x17[9], status0x17[10], status0x17[11],
//              status0x17[12], status0x17[13], status0x17[14], status0x17[15], status0x17[16], status0x17[17],
//              status0x17[18], status0x17[19], status0x17[20], status0x17[21],
//              status0x17[22], status0x17[23]);
//            counter = 0;
//            while (isRealStream)
//            {
//
//              writeDataToPort(replyToSend);
//              /*if (WriteFile(hSerial, replyToSend, 24, &dwBytesWritten, NULL))
//              {
//                printf("\n Sending Real time data (%d) to COM port... ", ++counter);
//                printf("\nTotal Bytes Written (Live Streaming): %d", dwBytesWritten);
//                continue;
//              }
//              else
//              {
//                printf("\nWriteFile failed: %d", GetLastError());
//              }*/
//
//              //Sleep(1500); //this thread will sleep and continue it's work.
//            }
//            break;
//          case 0x00: //false
//              isRealStream = 0;
//              printf("\nStop real-time streaming....");
//            //writeDataToPort(ACK);
//              break;
//            /*default:
//            printf("\nMissing argument to indicate beginning of streaming real time! Sending NACK!");
//            writeDataToPort(NACK);*/
//              break;
//          default:
//              printf("\nMissing argument 'TRUE/FALSE'!");
//              printf("\nSending NACK!");
//              writeDataToPort(NACK);
//              break;
//          }
          }

          break;
        }
        //todo: magic numbers
        case COMMAND_ID_REQUEST_TO_TEST://request to send test signal.
        {
          //printf("Received Request to Test");
          if(pRcvd_protocol_frame[COMMAND_DATA_BYTE] == EKG_TEST_PAT)
          {
            printf("Received test signal request...");
            eEC = eCommand_enable_test_signal((char)pRcvd_protocol_frame[5]);
            if(eEC == ER_OK)
            {
              eIneedmd_send_ack();
            }
            else
            {
              eIneedmd_send_nack();
              eEC = ER_OK;
            }
          }
          else if(pRcvd_protocol_frame[COMMAND_DATA_BYTE] == LED_TEST_PATTERN)
          {
            printf("Received LED test request");
            eEC = eCommand_led_test((INMD_LED_COMMAND)pRcvd_protocol_frame[5]);

            //Check if the UI request was successful
            if(eEC == ER_OK)
            {
              eIneedmd_send_ack();
            }
            else
            {
              eIneedmd_send_nack();
              eEC = ER_OK;
            }
            eEC = ER_OK;
          }
          else if(pRcvd_protocol_frame[COMMAND_DATA_BYTE] == STOP_EKG_TEST_PAT)
          {
            eEC = eCommand_stop_test_signal();
            if(eEC == ER_OK)
            {
              eIneedmd_send_ack();
            }
            else
            {
              eIneedmd_send_nack();
              eEC = ER_OK;
            }
          }
          else if(pRcvd_protocol_frame[COMMAND_DATA_BYTE] == REQ_FOR_DFU)
          {
            eEC = eCommand_DFU();
            if(eEC == ER_OK)
            {
              eIneedmd_send_ack();
              eEC = ER_FAIL;    //tell radio to not expect any more commands
            }
            else
            {
              eIneedmd_send_nack();
              eEC = ER_OK;
            }
            /*
            eEC = eIneedmd_UI_params_init(&tUI_request_params);
            eIneedmd_UI_params_init(&tUI_request_params);
            printf("Performing DFU...");
            eIneedmd_send_ack();
            //todo: add new DFU sequence enum to the params
            eIneedmd_UI_request(&tUI_request_params);
            Task_sleep(500);

            //todo: implement check for update function
  //          check_for_update();
            //todo: add new REBOOT sequence enum to the params
            eIneedmd_UI_request(&tUI_request_params);
            Task_sleep(500);
            ineedmd_watchdog_doorbell();
            */
          }
          else if(pRcvd_protocol_frame[COMMAND_DATA_BYTE] == REQ_FOR_RESET)
          {
            eEC = eCommand_reset_test();
            if(eEC == ER_OK)
            {
              eIneedmd_send_ack();
              ineedmd_watchdog_doorbell();
              eEC = ER_FAIL;
            }
            else
            {
              eIneedmd_send_nack();
              eEC = ER_OK;
            }
            /*
            eIneedmd_radio_request_params_init(&tRadio_request_Params);
            printf("Performing RESET..");
            //give the watchdog a long timeout timer
            ineedmd_watchdog_feed();

            //todo: add new RESTART sequence enum to the params
            eIneedmd_UI_request(&tUI_request_params);

            //set the radio to factory defaults
            tRadio_request_Params.eRequest = RADIO_REQUEST_CHANGE_SETTINGS;
            tRadio_request_Params.eSetting = RADIO_SETTINGS_RFD;
            tRadio_request_Params.vChange_setting_callback = vRadio_change_settings_callback;
            eEC = eIneedmd_radio_request(&tRadio_request_Params);
            if(eEC == ER_OK)
            {
              while(bDid_radio_rfd == false)
              {
                Task_sleep(500);
              }
            }else{}

            if(eEC == ER_OK)
            {
              eIneedmd_send_ack();
              //Reset the system
              ineedmd_watchdog_doorbell();

              //Should never get there, loop just in case
              while(1){};
            }
            else
            {
              eIneedmd_send_nack();
            }
            */
          }
          else
          {
            eIneedmd_send_nack();
            break;
          }
          printf("Done");
          break;
        } //end test request switch
      }//end command type switch
    }//end command validate else/if
  }//end error code check
  else          //packet type not valid
  {
    printf("\nInvalid type of packet received!");
    printf("\nSending NACK!");
    eIneedmd_send_nack();
  }

  return eEC;
}

/******************************************************************************
* name: eValidatePacketType
* description: validates datagram packet type byte.
* param description: const unsigned - char: packet type byte
* return value description: ERROR_CODE - ER_OK: datagram packet type is valid
*                                        ER_FAIL: datagram packet type is invalid
******************************************************************************/
ERROR_CODE eValidatePacketType(eINMD_Cmnd_packet_type eProtocolFrameType)
{
  ERROR_CODE eEC = ER_FAIL;

  if((eProtocolFrameType == DATAGRAM_TYPE_COMMAND) |\
     (eProtocolFrameType == DATAGRAM_TYPE_STATUS_INFO) |\
     (eProtocolFrameType == DATAGRAM_TYPE_DATA) |\
     (eProtocolFrameType == DATAGRAM_TYPE_REAL_TIME_DATA) |\
     (eProtocolFrameType == DATAGRAM_TYPE_STORED_DATA))
  {
    eEC = ER_OK;
  }
  else
  {
    eEC = ER_FAIL;
  }

  return eEC;
}

/******************************************************************************
* name: eSearchArrCmd
* description: determines the command from the recieved protocol datagram
* param description: eINMD_Cmnd_packet_type - enum: the command packet type
*                    eINMD_protocol_command_id - enum: the recieved command id
* return value description: ERROR_CODE - ER_OK: The command id is valid for the packet type
*                                        ER_FAIL: The command id is not valid for the packet type
*                                        ER_NOT_ENABLED: the packet type or command ide is currently not supported
******************************************************************************/
ERROR_CODE eValidateCommandID(eINMD_Cmnd_packet_type eProtocolFrameType, eINMD_protocol_command_id szRecCommand)
{
  ERROR_CODE eEC = ER_FAIL;

  switch(eProtocolFrameType)
  {
    case DATAGRAM_TYPE_COMMAND:
      if((szRecCommand == COMMAND_ID_REQUEST_STATUS)    |\
         (szRecCommand == COMMAND_ID_SET_STATUS)        |\
         (szRecCommand == COMMAND_ID_GET_DATA_SET_INFO) |\
         (szRecCommand == COMMAND_ID_DATA_SET_TRANSFER) |\
         (szRecCommand == COMMAND_ID_ERASE_DATA_SET)    |\
         (szRecCommand == COMMAND_ID_CAPTURE_DATA_SET)  |\
         (szRecCommand == COMMAND_ID_STREAM_DATA)       |\
         (szRecCommand == COMMAND_ID_REQUEST_TO_TEST))
      {
        eEC = ER_OK;
      }
      break;
    case DATAGRAM_TYPE_STATUS_INFO:
    case DATAGRAM_TYPE_DATA:
    case DATAGRAM_TYPE_REAL_TIME_DATA:
    case DATAGRAM_TYPE_STORED_DATA:
    default:
      eEC = ER_NOT_ENABLED;
      break;
  }

  return eEC;
}


/******************************************************************************
* name: eCommand_enable_test_signal
* description: enables test signal
* param description: char signal
* signal can be one of the following test signals:
*       EKG_TEST_PAT      0x01
*       TRIANGLE_TEST_PAT 0x00
*       SQUARE_TEST_PAT   0x01
*       WAVEFORM_TEST_PAT 0x02
* return value description: ERROR_CODE - ER_OK: The command id is valid for the packet type
*                                        ER_FAIL: The command id is not valid for the packet type
*                                        ER_NOT_ENABLED: the packet type or command is currently not supported
******************************************************************************/
ERROR_CODE eCommand_enable_test_signal(uint8_t signal)
{
  vDEBUG("Test Signal request received\n");
  ERROR_CODE eEC = ER_FAIL;
  switch(signal)
  {
    case TRIANGLE_TEST_PAT:
      break;
    case SQUARE_TEST_PAT:
      break;
    case WAVEFORM_TEST_PAT:
      break;
    default:
      break;
  }
  return eEC;
}


/******************************************************************************
* name: eCommand_stop_test_signal
* description: stops test signal generation
* param description: none
* return value description: ERROR_CODE - ER_OK: The command id is valid for the packet type
*                                        ER_FAIL: The command id is not valid for the packet type
*                                        ER_NOT_ENABLED: the packet type or command is currently not supported
******************************************************************************/
ERROR_CODE eCommand_stop_test_signal()
{
  vDEBUG("Stop Test request received\n");
  ERROR_CODE eEC = ER_FAIL;
  return eEC;
}

/******************************************************************************
* name: eCommand_DFU
* description: puts device into DFU mode, requests UI sequence
* param description: none
* return value description: ERROR_CODE - ER_OK: The command id is valid for the packet type
*                                        ER_FAIL: The command id is not valid for the packet type
*                                        ER_NOT_ENABLED: the packet type or command is currently not supported
******************************************************************************/
ERROR_CODE eCommand_DFU(void)
{
  vDEBUG("DFU request received\n");
  ERROR_CODE eEC = ER_FAIL;
  ERROR_CODE eEC_safety_checks = ER_FAIL;
  ERROR_CODE eEC_sys_prep = ER_FAIL;
  tINMD_EKG_req tEKG_req;
  eEKG_Task_state eEKG_state;
  tUSB_req tUSB_request;
  tUI_request tUI_req;
  tRadio_request tRadio_req;
  int iSupply_Voltage = 0;
  int iUnit_Temp = 0;
  uint32_t uiEKG_halt_timeout = 0;
  uint32_t uiEKG_shtdwn_timeout = 0;

  //Perform safety checks//////////////
  //
  //Check if EKG is in a patient monitoring state
  eEKG_state = eIneedmd_EKG_get_task_state();
  if(eEKG_state == EKG_TASK_MONITOR)
  {
    eEC_safety_checks = ER_FAIL;
  }
  else
  {
    eEC_safety_checks = ER_OK;
  }

  //Check the current battery voltage
  if(eEC_safety_checks == ER_OK)
  {
    iSupply_Voltage = uiPower_Control_Get_Supply_Voltage();
    if((iSupply_Voltage == 0)   |\
       (iSupply_Voltage == -1)  |\
       (iSupply_Voltage <= 3300))
    {
      eEC_safety_checks = ER_FAIL;
    }
    else
    {
      eEC_safety_checks = ER_OK;
    }
  }

  //Check the current system temperature
  if(eEC_safety_checks == ER_OK)
  {
    iUnit_Temp = iADC_get_unit_temperature();
    if((iUnit_Temp >=  DFU_REQ_MAX_TEMP) |\
       (iUnit_Temp <=  DFU_REQ_MIN_TEMP))
    {
      eEC_safety_checks = ER_FAIL;
    }
    else
    {
      eEC_safety_checks = ER_OK;
    }
  }

  //Check if the safety checks passed
  if(eEC_safety_checks == ER_FAIL)
  {
    //safety checks failed, set the error code to not ready to perform DFU yet
    eEC = ER_NOT_READY;
  }
  else
  {
    //Safety check passed, perform system prep
    //
    //Get the current EKG state
    eEKG_state = eIneedmd_EKG_get_task_state();
    //check if the EKG is in a "running" state
    if(eEKG_state == EKG_TASK_NONE)
    {
      //ekg not even started, nothing to shutdown
      eEC_sys_prep = ER_OK;
    }
    else if(eEKG_state != EKG_TASK_IDLE)
    {

      eIneedmd_EKG_request_param_init(&tEKG_req);
      tEKG_req.eReq_ID = EKG_REQUEST_EKG_HALT;
      tEKG_req.vEKG_read_callback = &vEKG_halt_request_callback;
      eEC = eIneedmd_EKG_request(&tEKG_req);
      if(eEC == ER_OK)
      {
        //wait for the EKG task to finish halting
        while(bDid_ekg_halt == false)
        {
          Task_sleep(100);
          uiEKG_halt_timeout++;
          if(uiEKG_halt_timeout >= DFU_REQ_EKG_HALT_TIMEOUT)
          {
            eEC_sys_prep = ER_FAIL;
            break;
          }

          //Get the current EKG state
          eEKG_state = eIneedmd_EKG_get_task_state();
        }
        eEC_sys_prep = ER_OK;
      }
      else
      {
        eEC_sys_prep = ER_FAIL;
      }
    }

    //If EKG is in an idle state, request it to shut down completly
    if(eEKG_state == EKG_TASK_IDLE)
    {
      eIneedmd_EKG_request_param_init(&tEKG_req);
      tEKG_req.eReq_ID = EKG_REQUEST_EKG_SHUTDOWN;
      tEKG_req.vEKG_read_callback = &vEKG_shtdwn_request_callback;
      eEC = eIneedmd_EKG_request(&tEKG_req);
      if(eEC == ER_OK)
      {
        //wait for the EKG task to finish shutting down
        while(bDid_ekg_shtdwn == false)
        {
          Task_sleep(100);
          uiEKG_shtdwn_timeout++;
          if(uiEKG_shtdwn_timeout >= DFU_REQ_EKG_SHTDWN_TIMEOUT)
          {
            eEC_sys_prep = ER_FAIL;
            break;
          }
        }
        eEC_sys_prep = ER_OK;
      }
      else
      {
        //EKG request to shut down failed, set the error code
        eEC_sys_prep = ER_FAIL;
      }
    }

    //turn on the USB interface
    if(eEC_sys_prep == ER_OK)
    {
      eUSB_request_params_init(&tUSB_request);
      tUSB_request.eRequest = USB_REQUEST_FORCE_ENABLE;
      eEC = eUSB_request(&tUSB_request);
      if(eEC == ER_OK)
      {
        eEC_sys_prep = ER_OK;
      }
      else
      {
        eEC_sys_prep = ER_FAIL;
      }
    }

    if(eEC_sys_prep == ER_OK)
    {
      ineedmd_watchdog_barkcollar();
      eEC_sys_prep = ER_OK;
    }
  }

  //check if safety and system checks passed
  if((eEC_safety_checks == ER_OK) & \
     (eEC_sys_prep == ER_OK))
  {
    //put the system into DFU

    eIneedmd_UI_params_init(&tUI_req);
    tUI_req.uiUI_element = (INMD_UI_ELEMENT_HEART_LED | INMD_UI_ELEMENT_COMMS_LED | INMD_UI_ELEMENT_POWER_LED);
    tUI_req.eComms_led_sequence = COMMS_LED_DFU;
    tUI_req.eHeart_led_sequence = HEART_LED_DFU;
    tUI_req.ePower_led_sequence = POWER_LED_DFU;
    eIneedmd_UI_request(&tUI_req);

    eIneedmd_send_ack();

    //todo: protocol interface shutdown, note: procol interface shutdown may not be needed since ack'ing a DFU command the remote device should assume protocol connection will terminate

    eIneedmd_radio_request_params_init (&tRadio_req);
    tRadio_req.eRequest = RADIO_REQUEST_POWER_OFF;
    eEC = eIneedmd_radio_request(&tRadio_req);

    Task_sleep(1000);

    ROM_IntMasterDisable();
    ROM_SysTickIntDisable();
    ROM_SysTickDisable();
    uint32_t ui32SysClock;
    ROM_SysCtlClockSet(SYSCTL_SYSDIV_4 | SYSCTL_USE_PLL | SYSCTL_OSC_MAIN |
    SYSCTL_XTAL_16MHZ);
    ui32SysClock = ROM_SysCtlClockGet();
    ROM_SysCtlPeripheralEnable(SYSCTL_PERIPH_GPIOD);
    ROM_GPIOPinTypeUSBAnalog(GPIO_PORTD_BASE, GPIO_PIN_4 | GPIO_PIN_5);
    ROM_SysTickPeriodSet(ROM_SysCtlClockGet() / 100);
    HWREG(NVIC_DIS0) = 0xffffffff;
    HWREG(NVIC_DIS1) = 0xffffffff;
    HWREG(NVIC_DIS2) = 0xffffffff;
    HWREG(NVIC_DIS3) = 0xffffffff;
    HWREG(NVIC_DIS4) = 0xffffffff;
    int ui32Addr;
    for(ui32Addr = NVIC_PRI0; ui32Addr <= NVIC_PRI34; ui32Addr+=4)
    {
      HWREG(ui32Addr) = 0;
    }
    HWREG(NVIC_SYS_PRI1) = 0;
    HWREG(NVIC_SYS_PRI2) = 0;
    HWREG(NVIC_SYS_PRI3) = 0;
    ROM_SysCtlPeripheralEnable(SYSCTL_PERIPH_USB0);
    ROM_SysCtlPeripheralReset(SYSCTL_PERIPH_USB0);
    ROM_SysCtlUSBPLLEnable();
    ROM_SysCtlDelay(ui32SysClock*2 / 3);
    ROM_IntMasterEnable();
    ROM_UpdateUSB(0);
    while(1){}
  }
  else
  {
    //safety and system checks failed restore the system to previoius operation mode


    eEC = ER_FAIL;
  }


  //system restore
  return eEC;
}

/******************************************************************************
* name: eCommand_reset_test
* description: resets device, requests UI sequence
* param description: none
* return value description: ERROR_CODE - ER_OK: The command id is valid for the packet type
*                                        ER_FAIL: The command id is not valid for the packet type
*                                        ER_NOT_ENABLED: the packet type or command is currently not supported
******************************************************************************/
ERROR_CODE eCommand_reset_test()
{
  ERROR_CODE eEC = ER_FAIL;
  tRadio_request tRadio_request_Params;
  tUI_request tUI_request_params;
  eIneedmd_radio_request_params_init(&tRadio_request_Params);
  printf("Performing RESET..");
  //give the watchdog a long timeout timer
  ineedmd_watchdog_feed();

  //todo: add new RESTART sequence enum to the params
  eIneedmd_UI_request(&tUI_request_params);

  //set the radio to factory defaults
  tRadio_request_Params.eRequest = RADIO_REQUEST_CHANGE_SETTINGS;
  tRadio_request_Params.eSetting = RADIO_SETTINGS_RFD;
  tRadio_request_Params.vChange_setting_callback = vRadio_change_settings_callback;
  eEC = eIneedmd_radio_request(&tRadio_request_Params);

  if(eEC == ER_OK)
  {
    while(bDid_radio_rfd == false)
    {
      Task_sleep(500);
    }
  }else{}//do nothing

  return eEC;
}




/******************************************************************************
* name: eCommand_set_status
* description: sets device status based on statusToSet
* param description: statusToSet - pointer to status to set. should point to command packet
* return value description: ERROR_CODE - ER_OK: The command id is valid for the packet type
*                                        ER_FAIL: The command id is not valid for the packet type
*                                        ER_NOT_ENABLED: the packet type or command is currently not supported
******************************************************************************/
ERROR_CODE eCommand_set_status(uint8_t* statusToSet)
{
  vDEBUG("status set request received\n");
  //TODO: check if statusToSet is valid
  //TODO: set staus
  ERROR_CODE eEC = ER_FAIL;
  return eEC;
}

ERROR_CODE eCommand_capture_data(uint8_t* time)
{
  vDEBUG("capture request received\n");
  //TODO: check time/duration info
  ERROR_CODE eEC = ER_FAIL;
  return eEC;
}

ERROR_CODE eCommand_get_data_set_info(uint8_t* dataSet)
{
  vDEBUG("data set info request received\n");
  ERROR_CODE eEC = ER_FAIL;
  return eEC;
}

ERROR_CODE eCommand_transfer_data_set(uint8_t* dataSet)
{
  vDEBUG("transfer data request received\n");
  ERROR_CODE eEC = ER_FAIL;
  return eEC;
}

ERROR_CODE eCommand_erase_data_set(uint8_t* dataSet)
{
  vDEBUG("erase data set request received\n");
  ERROR_CODE eEC = ER_FAIL;
  return eEC;
}

ERROR_CODE eCommand_send_status()
{
  vDEBUG("status request received\n");
  ERROR_CODE eEC = ER_FAIL;
  //TODO: uint32_t?
  unsigned char* ucProtocol_Frame_resp;
  ucProtocol_Frame_resp = malloc(STATUS_LEN);
  uint16_t OutGoingPacket_len = 0;
  if(ucProtocol_Frame_resp != NULL)
  {
    OutGoingPacket_len = 0;
    ucProtocol_Frame_resp[OutGoingPacket_len++] = 0x9c;
    ucProtocol_Frame_resp[OutGoingPacket_len++] = 0x02;
    ucProtocol_Frame_resp[OutGoingPacket_len++] = 0x12;
    ucProtocol_Frame_resp[OutGoingPacket_len++] = 0x04; // hard coding the version number
    ucProtocol_Frame_resp[OutGoingPacket_len++] = 0x00; //todo: implement battery voltage function ineedmd_get_battery_voltage();
    ucProtocol_Frame_resp[OutGoingPacket_len++] = (char) (0xff & 0x00);//todo: implement unit temp function ineedmd_get_unit_tempoerature());

    ucProtocol_Frame_resp[OutGoingPacket_len++] = 0x00;  // operating mode  - no information to add yet
    ucProtocol_Frame_resp[OutGoingPacket_len++] = 0x00;  // capture settings 1  - no information to add yet
    ucProtocol_Frame_resp[OutGoingPacket_len++] = 0x00;  // capture settings 2  - no information to add yet
    ucProtocol_Frame_resp[OutGoingPacket_len++] = 0x00;  // Time 4 - no information to add yet
    ucProtocol_Frame_resp[OutGoingPacket_len++] = 0x00;  // Time 3 - no information to add yet
    ucProtocol_Frame_resp[OutGoingPacket_len++] = 0x00;  // Time 2 - no information to add yet
    ucProtocol_Frame_resp[OutGoingPacket_len++] = 0x00;  // Time 1 - no information to add yet
    ucProtocol_Frame_resp[OutGoingPacket_len++] = 0x00;  // Alarm 4  - no information to add yet
    ucProtocol_Frame_resp[OutGoingPacket_len++] = 0x00;  // Alarm 3  - no information to add yet
    ucProtocol_Frame_resp[OutGoingPacket_len++] = 0x00;  // Alarm 2  - no information to add yet
    ucProtocol_Frame_resp[OutGoingPacket_len++] = 0x00;  // Alarm 1  - no information to add yet

    ucProtocol_Frame_resp[OutGoingPacket_len++] = 0xc9;

    PrintCommand(ucProtocol_Frame_resp, ucProtocol_Frame_resp[2]); //this is just to display on our side, what reply we are sending.
    printf("Sending status record...");

    if(OutGoingPacket_len > 0x20)
    {
      printf("Packet len > 0x20! SYS HALT");
      while(1){};
    }else{}
    writeDataToPort(ucProtocol_Frame_resp, OutGoingPacket_len);
    free(ucProtocol_Frame_resp);
    eEC = ER_OK;
  }
  return eEC;
}

ERROR_CODE eCommand_stream_data(uint8_t realTime)
{
  vDEBUG("stream data request received\n");
  ERROR_CODE eEC = ER_FAIL;
  if(realTime == 0xFF)
  {
    eEC = ER_FAIL;
  }
  else if (realTime == 0x00)
  {
    eEC = ER_FAIL;
  }
  else
  {
    eEC = ER_FAIL;
  }

  return eEC;
}

ERROR_CODE eCommand_led_test(INMD_LED_COMMAND eInmd_LED_cmnd)
{
  vDEBUG("LED Test request received\n");
  ERROR_CODE eEC = ER_FAIL;
  tUI_request tUI_request_params;

  if(eInmd_LED_cmnd >= INMD_LED_CMND_LIMIT)
  {
    eEC = ER_PARAM;
  }
  else
  {
    eEC = eIneedmd_UI_params_init(&tUI_request_params);
    if(eEC == ER_OK)
    {
      switch(eInmd_LED_cmnd)
      {
        case INMD_LED_CMND_LED_OFF:
          printf("LED_OFF");
          tUI_request_params.uiUI_element = (INMD_UI_ELEMENT_HEART_LED | INMD_UI_ELEMENT_COMMS_LED | INMD_UI_ELEMENT_POWER_LED);
          tUI_request_params.eHeart_led_sequence = HEART_LED_UI_OFF;
          tUI_request_params.eComms_led_sequence = COMMS_LED_UI_OFF;
          tUI_request_params.ePower_led_sequence = POWER_LED_UI_OFF;
          break;
        case INMD_LED_CMND_POWER_ON_BATT_LOW:
          printf("POWER_ON_BATT_LOW");
          tUI_request_params.uiUI_element = (INMD_UI_ELEMENT_HEART_LED | INMD_UI_ELEMENT_COMMS_LED | INMD_UI_ELEMENT_POWER_LED);
          tUI_request_params.eHeart_led_sequence = HEART_LED_UI_OFF;
          tUI_request_params.eComms_led_sequence = COMMS_LED_UI_OFF;
          tUI_request_params.ePower_led_sequence = POWER_LED_POWER_ON_25to50;
          break;
        case INMD_LED_CMND_POWER_ON_BATT_GOOD:
          printf("POWER_ON_BATT_GOOD");
          tUI_request_params.uiUI_element = (INMD_UI_ELEMENT_HEART_LED | INMD_UI_ELEMENT_COMMS_LED | INMD_UI_ELEMENT_POWER_LED);
          tUI_request_params.eHeart_led_sequence = HEART_LED_UI_OFF;
          tUI_request_params.eComms_led_sequence = COMMS_LED_UI_OFF;
          tUI_request_params.ePower_led_sequence = POWER_LED_POWER_ON_90to100;
          break;
        case INMD_LED_CMND_BATT_CHARGING:
          printf("BATT_CHARGING");
          tUI_request_params.uiUI_element = (INMD_UI_ELEMENT_HEART_LED | INMD_UI_ELEMENT_COMMS_LED | INMD_UI_ELEMENT_POWER_LED);
          tUI_request_params.eHeart_led_sequence = HEART_LED_UI_OFF;
          tUI_request_params.eComms_led_sequence = COMMS_LED_UI_OFF;
          tUI_request_params.ePower_led_sequence = POWER_LED_POWER_ON_CHARGE_50to90;
          break;
        case INMD_LED_CMND_BATT_CHARGING_LOW:
          printf("BATT_CHARGING_LOW");
          tUI_request_params.uiUI_element = (INMD_UI_ELEMENT_HEART_LED | INMD_UI_ELEMENT_COMMS_LED | INMD_UI_ELEMENT_POWER_LED);
          tUI_request_params.eHeart_led_sequence = HEART_LED_UI_OFF;
          tUI_request_params.eComms_led_sequence = COMMS_LED_UI_OFF;
          tUI_request_params.ePower_led_sequence = POWER_LED_POWER_ON_CHARGE_0to25;
          break;
        case INMD_LED_CMND_LEAD_LOOSE:
          printf("LEAD_LOOSE");
          tUI_request_params.uiUI_element = (INMD_UI_ELEMENT_HEART_LED | INMD_UI_ELEMENT_COMMS_LED | INMD_UI_ELEMENT_POWER_LED);
          tUI_request_params.eHeart_led_sequence = HEART_LED_LEAD_OFF_NO_DATA;
          tUI_request_params.eComms_led_sequence = COMMS_LED_UI_OFF;
          tUI_request_params.ePower_led_sequence = POWER_LED_UI_OFF;
          break;
        case INMD_LED_CMND_LEAD_GOOD_UPLOADING:
          printf("LEAD_GOOD_UPLOADING");
          tUI_request_params.uiUI_element = (INMD_UI_ELEMENT_HEART_LED | INMD_UI_ELEMENT_COMMS_LED | INMD_UI_ELEMENT_POWER_LED);
          tUI_request_params.eHeart_led_sequence = HEART_LED_LEAD_ON;
          tUI_request_params.eComms_led_sequence = COMMS_LED_UI_OFF;
          tUI_request_params.ePower_led_sequence = POWER_LED_UI_OFF;
          break;
        case INMD_LED_CMND_DIG_FLATLINE:
          printf("DIG_FLATLINE");
          tUI_request_params.uiUI_element = (INMD_UI_ELEMENT_HEART_LED | INMD_UI_ELEMENT_COMMS_LED | INMD_UI_ELEMENT_POWER_LED);
          tUI_request_params.eHeart_led_sequence = HEART_LED_DIGITAL_FLATLINE;
          tUI_request_params.eComms_led_sequence = COMMS_LED_UI_OFF;
          tUI_request_params.ePower_led_sequence = POWER_LED_UI_OFF;
          break;
        case INMD_LED_CMND_BT_CONNECTED:
          printf("BT_CONNECTED");
          //todo: update once 3 led
          tUI_request_params.uiUI_element = (INMD_UI_ELEMENT_HEART_LED | INMD_UI_ELEMENT_COMMS_LED);// | INMD_UI_ELEMENT_POWER_LED);
          tUI_request_params.eHeart_led_sequence = HEART_LED_UI_OFF;
          tUI_request_params.eComms_led_sequence = COMMS_LED_BLUETOOTH_CONNECTION_SUCESSFUL;
          tUI_request_params.ePower_led_sequence = POWER_LED_UI_OFF;
          break;
        case INMD_LED_CMND_BT_ATTEMPTING:
          printf("BT_ATTEMPTING");
          //todo: update once 3 led
          tUI_request_params.uiUI_element = (INMD_UI_ELEMENT_HEART_LED | INMD_UI_ELEMENT_COMMS_LED);// | INMD_UI_ELEMENT_POWER_LED);
          tUI_request_params.eHeart_led_sequence = HEART_LED_UI_OFF;
          tUI_request_params.eComms_led_sequence = COMMS_LED_BLUETOOTH_PAIRING;
          tUI_request_params.ePower_led_sequence = POWER_LED_UI_OFF;
          break;
        case INMD_LED_CMND_BT_FAILED:
          printf("BT_FAILED");
          //todo: update once 3 led
          tUI_request_params.uiUI_element = (INMD_UI_ELEMENT_HEART_LED | INMD_UI_ELEMENT_COMMS_LED);// | INMD_UI_ELEMENT_POWER_LED);
          tUI_request_params.eHeart_led_sequence = HEART_LED_UI_OFF;
          tUI_request_params.eComms_led_sequence = COMMS_LED_BLUETOOTH_PAIRING_FAILIED;
          tUI_request_params.ePower_led_sequence = POWER_LED_UI_OFF;
          break;
        case INMD_LED_CMND_USB_CONNECTED:
          printf("USB_CONNECTED");
          //todo: update once 3 led
          tUI_request_params.uiUI_element = (INMD_UI_ELEMENT_HEART_LED | INMD_UI_ELEMENT_COMMS_LED);// | INMD_UI_ELEMENT_POWER_LED);
          tUI_request_params.eHeart_led_sequence = HEART_LED_UI_OFF;
          tUI_request_params.eComms_led_sequence = COMMS_LED_USB_CONNECTION_SUCESSFUL;
          tUI_request_params.ePower_led_sequence = POWER_LED_UI_OFF;
          break;
        case INMD_LED_CMND_USB_FAILED:
          printf("USB_FAILED");
          //todo: update once 3 led
          tUI_request_params.uiUI_element = (INMD_UI_ELEMENT_HEART_LED | INMD_UI_ELEMENT_COMMS_LED);// | INMD_UI_ELEMENT_POWER_LED);
          tUI_request_params.eHeart_led_sequence = HEART_LED_UI_OFF;
          tUI_request_params.eComms_led_sequence = COMMS_LED_USB_CONNECTION_FAILED;
          tUI_request_params.ePower_led_sequence = POWER_LED_UI_OFF;
          break;
        case INMD_LED_CMND_DATA_TRANSFER:
          printf("DATA_TRANSFER");
          //todo: update once 3 led
          tUI_request_params.uiUI_element = (INMD_UI_ELEMENT_HEART_LED | INMD_UI_ELEMENT_COMMS_LED);// | INMD_UI_ELEMENT_POWER_LED);
          tUI_request_params.eHeart_led_sequence = HEART_LED_UI_OFF;
          tUI_request_params.eComms_led_sequence = COMMS_LED_DATA_TRANSFERING_FROM_DONGLE;
          tUI_request_params.ePower_led_sequence = POWER_LED_UI_OFF;
          break;
        case INMD_LED_CMND_TRANSFER_DONE:
          printf("TRANSFER_DONE");
          //todo: update once 3 led
          tUI_request_params.uiUI_element = (INMD_UI_ELEMENT_HEART_LED | INMD_UI_ELEMENT_COMMS_LED);// | INMD_UI_ELEMENT_POWER_LED);
          tUI_request_params.eHeart_led_sequence = HEART_LED_UI_OFF;
          tUI_request_params.eComms_led_sequence = COMMS_LED_DATA_TRANSFER_SUCESSFUL;
          tUI_request_params.ePower_led_sequence = POWER_LED_UI_OFF;
          break;
        case INMD_LED_CMND_STORAGE_WARNING:
          printf("STORAGE_WARNING");
          tUI_request_params.uiUI_element = (INMD_UI_ELEMENT_HEART_LED | INMD_UI_ELEMENT_COMMS_LED);// | INMD_UI_ELEMENT_POWER_LED);
          tUI_request_params.eHeart_led_sequence = HEART_LED_UI_OFF;
          tUI_request_params.eComms_led_sequence = COMMS_LED_DONGLE_STORAGE_WARNING;
          tUI_request_params.ePower_led_sequence = POWER_LED_UI_OFF;
          break;
        case INMD_LED_CMND_ERASING:
          printf("ERASING");
          tUI_request_params.uiUI_element = (INMD_UI_ELEMENT_HEART_LED | INMD_UI_ELEMENT_COMMS_LED);// | INMD_UI_ELEMENT_POWER_LED);
          tUI_request_params.eHeart_led_sequence = HEART_LED_UI_OFF;
          tUI_request_params.eComms_led_sequence = COMMS_LED_ERASING_STORED_DATA;
          tUI_request_params.ePower_led_sequence = POWER_LED_UI_OFF;
          break;
        case INMD_LED_CMND_ERASE_DONE:
          printf("ERASE_DONE");
          tUI_request_params.uiUI_element = (INMD_UI_ELEMENT_HEART_LED | INMD_UI_ELEMENT_COMMS_LED);// | INMD_UI_ELEMENT_POWER_LED);
          tUI_request_params.eHeart_led_sequence = HEART_LED_UI_OFF;
          tUI_request_params.eComms_led_sequence = COMMS_LED_ERASE_COMPLETE;
          tUI_request_params.ePower_led_sequence = POWER_LED_UI_OFF;
          //todo: set UI request params
          break;
        case INMD_LED_CMND_DFU_MODE:
          printf("DFU_MODE");
          //todo: set UI request params
          break;
        case INMD_LED_CMND_MV_CAL:
          printf("MV_CAL");
          //todo: set UI request params
          break;
        case INMD_LED_CMND_TRI_WVFRM:
          printf("TRI_WVFRM");
          //todo: set UI request params
          break;
        case INMD_LED_CMND_REBOOT:
          printf("REBOOT");
          eEC =  eIneedmd_UI_request(&tUI_request_params);
          break;
        case INMD_LED_CMND_HIBERNATE:
          printf("HIBERNATE");
          //todo: set UI request params
          //todo: implement battery check function
          //check_battery();
          break;
        case INMD_LED_CMND_LEADS_ON:
          printf("LEADS_ON");
          //todo: set UI request params
          break;
        case INMD_LED_CMND_MEMORY_TEST:
          printf("MEMORY_TEST");
          //todo: set UI request params
          break;
        case INMD_LED_CMND_COM_BUS_TEST:
          printf("COM_BUS_TEST");
          //todo: set UI request params
          break;
        case INMD_LED_CMND_CPU_CLOCK_TEST:
          printf("CPU_CLOCK_TEST");
          //todo: set UI request params
          break;
        case INMD_LED_CMND_FLASH_TEST:
          printf("FLASH_TEST");
          //todo: set UI request params
          break;
        case INMD_LED_CMND_TEST_PASS:
          printf("TEST_PASS");
          //todo: set UI request params
          break;
        default:
          printf("Unrecongnized Sequence - No Soup For You");
          eEC = ER_FAIL;
          break;
      }

      if(eEC == ER_OK)
      {
        eEC =  eIneedmd_UI_request(&tUI_request_params);
      }
      else
      {
        eEC = ER_UNKNOWN_PARAM;
      }
    }else{/*do nothing*/}
  }
  return eEC;
}

////*****************************************************************************
//// name:
//// description:
//// param description:
//// return value description:
////*****************************************************************************
//int iIneedmd_Rcv_cmnd_frame(uint8_t * uiCmnd_Frame, uint16_t uiCmnd_Frame_len)
//{
//  int iEC = 0;
//  void * vDid_copy = NULL;
//  memset(uiINMD_Protocol_frame, 0x00, INMD_FRAME_BUFF_SIZE);
//
//  if(uiCmnd_Frame_len >= INMD_FRAME_BUFF_SIZE)
//  {
//    iEC = -1;
//  }
//  else
//  {
//    vDid_copy = memcpy(uiINMD_Protocol_frame, uiCmnd_Frame, uiCmnd_Frame_len);
//    if(vDid_copy != NULL)
//    {
//      bIs_protocol_frame = true;
////      uiINMD_Protocol_frame_len = uiCmnd_Frame_len;
//    }
//    else
//    {
//      iEC = -2;
//    }
//  }
//  return iEC;
//}
//
////*****************************************************************************
//// name:
//// description:
//// param description:
//// return value description:
////*****************************************************************************
//int iIneedmd_Send_cmnd_frame(uint8_t * uiCmnd_Frame, uint16_t uiCmnd_Frame_len)
//{
//  return 1;
//}
//
////*****************************************************************************
//// name:
//// description:
//// param description:
//// return value description:
////*****************************************************************************
//bool iIneedmd_is_protocol_frame(void)
//{
//  bool bWas_frame;
//
//  bWas_frame = bIs_protocol_frame;
//  bIs_protocol_frame = false;
//
//  return bWas_frame;
//}

/******************************************************************************
* public functions ////////////////////////////////////////////////////////////////////////////////////////////////////////////////////////////////////////////
******************************************************************************/

/******************************************************************************
* name: eIneedmd_cmnd_Proto_ReqNote_params_init
* description: initalizes the tINMD_protocol_request parameters to default values
* param description: tINMD_protocol_request - pointer: pointer to the structure
*                      to be initalized that will be passed to the request notify funcion
*
* return value description: ERROR_CODE - ER_OK: params initalized
*                                        ER_FAIL: params failed init
*                                        ER_PARAM: pointer to parameter
*                                          stucture passed in is invalid
******************************************************************************/
ERROR_CODE eIneedmd_cmnd_Proto_ReqNote_params_init(tINMD_protocol_req_notify * ptParams)
{
  ERROR_CODE eEC = ER_FAIL;

  if(ptParams == NULL)
  {
    eEC = ER_PARAM;
  }
  else
  {
    ptParams->eReq_Notify = CMND_REQUEST_NONE;
    ptParams->uiCmnd_Frame = NULL;
    ptParams->uiFrame_Len = 0;
  }

  if((ptParams->eReq_Notify != CMND_REQUEST_NONE) |\
     (ptParams->uiCmnd_Frame != NULL)             |\
     (ptParams->uiFrame_Len != 0))
  {
    eEC = ER_FAIL;
  }
  else
  {
    eEC = ER_OK;
  }
  return eEC;
}

/******************************************************************************
* name: eIneedmd_cmnd_Proto_Request_Notify
* description:
* param description: tINMD_protocol_req_notify - pointer pointer to the structure
*                      that will be passed to the request notify funcion
* return value description: ERROR_CODE - ER_OK: request/notification accepted
*                                        ER_FAIL: request/notification not accepted
*                                        ER_PARAM: pointer to parameter stucture
*                                         passed in is invalid
*                                        ER_SIZE: command frame length is too large.
*                                        ER_LEN - command frame length is wrong.
*                                        ER_COMMAND - command is malformed.
*                                        ER_INVALID - command pointer is invalid
******************************************************************************/
ERROR_CODE eIneedmd_cmnd_Proto_Request_Notify(tINMD_protocol_req_notify * ptParams)
{
  ERROR_CODE eEC = ER_FAIL;
  tProtocol_msg_struct tProtocol_msg;
  bool bDid_msg_post = false;
  uint8_t uiProto_start_byte = 0;
  uint8_t uiProto_end_byte = 0;
  uint8_t uiProto_frame_len = 0;

  if(ptParams == NULL)
  {
    eEC = ER_PARAM;
  }
  else
  {
    switch(ptParams->eReq_Notify)
    {
      case CMND_REQUEST_WAKEUP:
        tProtocol_msg.eMsg = CMND_MSG_WAKEUP;
        eEC = ER_OK;
        break;
      case CMND_REQUEST_SLEEP:
        if(bIs_radio_on == true)
        {
          tProtocol_msg.eMsg = CMND_MSG_SLEEP;
          eEC = ER_OK;
        }
        else
        {
          eEC = ER_SKIP;
        }
        break;
      case CMND_REQUEST_RCV_PROTOCOL_FRAME:
        //Check if the frame length is greather then the max frame length size
        if(ptParams->uiFrame_Len > PROTOCOL_FRAME_MAX_LEN)
        {
          //Frame length exceedes limit
          //
          eEC = ER_SIZE;
#ifdef DEBUG
          vDEBUG("eIneedmd_cmnd_Proto_Request_Notify SYS_HALT, proto frame size to large");
          while(1){};
#endif
        }
        else
        {
          //Frame length is within the limit
          //
          //Check if the command frame pointer is valid
          if(ptParams->uiCmnd_Frame == NULL)
          {
            //Command frame pointer is invalid
            //
            eEC = ER_INVALID;
          }
          else
          {
            //Command frame pointer is valid
            //
            uiProto_start_byte = ptParams->uiCmnd_Frame[0];
            uiProto_end_byte = ptParams->uiCmnd_Frame[(ptParams->uiFrame_Len - 1)];
            uiProto_frame_len = ptParams->uiCmnd_Frame[2];
            //Check if the command frame is properly formed
            if((uiProto_start_byte == PROTOCOL_FRAME_START_BYTE) & \
               (uiProto_frame_len  == ptParams->uiFrame_Len)     & \
               (uiProto_end_byte   == PROTOCOL_FRAME_END_BYTE))
            {
              //frame was properly formed
              //
              //post command message to task
              tProtocol_msg.eMsg = CMND_MSG_PROTOCOL_FRAME;
              tProtocol_msg.uiCmnd_Frame_len = ptParams->uiFrame_Len;
              memcpy(&tProtocol_msg.uiCmnd_Frame[0], ptParams->uiCmnd_Frame, ptParams->uiFrame_Len);
              eEC = ER_OK;
            }
            else
            {
              //frame is malformed
              //
              eEC = ER_COMMAND;
            }
          }
        }
        break;
      case CMND_NOTIFY_INTERFACE_ESTABLISHED:
        break;
      case CMND_NOTIFY_PROTOCOL_INTERFACE_ESTABLISHED:
        //notify task that protocol interface was established
        tProtocol_msg.eMsg = CMND_MSG_PROTOCOL_INTERFACE_ESTABLISHED;
        eEC = ER_OK;
        break;
      case CMND_NOTIFY_PROTOCOL_INTERFACE_TIME_OUT:
        break;
      case CMND_NOTIFY_PROTOCOL_INTERFACE_CLOSED:
        tProtocol_msg.eMsg = CMND_MSG_WAKEUP;
        eEC = ER_OK;
        break;
      default:
        break;
    }
  }

  if(eEC == ER_OK)
  {
    bDid_msg_post = Mailbox_post(tTIRTOS_cmnd_protocol_mailbox, &tProtocol_msg, BIOS_WAIT_FOREVER);
    if(bDid_msg_post == true)
    {
      eEC = ER_OK;
    }
    else
    {
      eEC = ER_FAIL;
    }
  }
  else if(eEC == ER_SKIP)
  {
    eEC = ER_OK;

  }else{/*do nothing*/}

  return eEC;
}

//*****************************************************************************
// name:
// description:
// param description:
// return value description:
//*****************************************************************************
void vIneedmd_command_task(UArg a0, UArg a1)
{
  ERROR_CODE eEC = ER_OK;
  tProtocol_msg_struct tProtocol_msg;
  tRadio_request tRadio_request;
  uint32_t uiMsg_size = sizeof(tProtocol_msg_struct);
  uint32_t uiMbox_size = 0;
  tINMD_protocol_req_notify tCmnd_Req_Notify;

  uiMbox_size = Mailbox_getMsgSize(tTIRTOS_cmnd_protocol_mailbox);
  if(uiMsg_size != uiMbox_size)
  {
    vDEBUG("vIneedmd_command_task SYS HALT, invalid mailbox msg size!");
    while(1){};
  }else{/*do nothing*/}

  eIneedmd_cmnd_Proto_ReqNote_params_init(&tCmnd_Req_Notify);
  tCmnd_Req_Notify.eReq_Notify = CMND_REQUEST_WAKEUP;
  eIneedmd_cmnd_Proto_Request_Notify(&tCmnd_Req_Notify);

  while(1)
  {
    if(Mailbox_pend(tTIRTOS_cmnd_protocol_mailbox, &tProtocol_msg, BIOS_WAIT_FOREVER) == true)
    {
      switch(tProtocol_msg.eMsg)
      {
        case CMND_MSG_WAKEUP:
        {
          //Perform wakeup procedure
          eIneedmd_radio_request_params_init (&tRadio_request);
          tRadio_request.eRequest = RADIO_REQUEST_POWER_ON;
          tRadio_request.vSetup_state_callback = &vRadio_setup_callback;
          eEC = eIneedmd_radio_request(&tRadio_request);
          if(eEC == ER_NOT_READY)
          {
            Task_sleep(500);
            eIneedmd_cmnd_Proto_ReqNote_params_init(&tCmnd_Req_Notify);
            tCmnd_Req_Notify.eReq_Notify = CMND_REQUEST_WAKEUP;
            eIneedmd_cmnd_Proto_Request_Notify(&tCmnd_Req_Notify);
          }
          else if(eEC == ER_OK)
          {
            while(bIs_radio_on == false)
            {
              Task_sleep(10);
            }
            vDEBUG("Proto cmndr, waiting for proto connection");
            eIneedmd_radio_request_params_init (&tRadio_request);
            tRadio_request.eRequest = RADIO_REQUEST_WAIT_FOR_CONNECTION;
            tRadio_request.uiTimeout = PROTOCOL_CONN_TIMEOUT_FOREVER;
            tRadio_request.vConnection_status_callback = &vRadio_connection_callback;
            eIneedmd_radio_request(&tRadio_request);
          }
          break;
        }
        case CMND_MSG_SLEEP:
          eIneedmd_radio_request_params_init (&tRadio_request);
          tRadio_request.eRequest = RADIO_REQUEST_POWER_OFF;
          tRadio_request.vSetup_state_callback = &vRadio_setup_callback;
          eEC = eIneedmd_radio_request(&tRadio_request);
          if(eEC == ER_NOT_READY)
          {
            Task_sleep(100);
            eIneedmd_cmnd_Proto_ReqNote_params_init(&tCmnd_Req_Notify);
            tCmnd_Req_Notify.eReq_Notify = CMND_REQUEST_SLEEP;
            eIneedmd_cmnd_Proto_Request_Notify(&tCmnd_Req_Notify);
          }
          break;
        case CMND_MSG_PROTOCOL_FRAME:
          vDEBUG("Proto cmndr, got proto frame");
          eEC = eParse_Protocol_Frame(tProtocol_msg.uiCmnd_Frame, tProtocol_msg.uiCmnd_Frame_len);

          if(eEC == ER_OK)
          {
            eIneedmd_radio_request_params_init (&tRadio_request);
            tRadio_request.eRequest = RADIO_REQUEST_RECEIVE_FRAME;
            eIneedmd_radio_request(&tRadio_request);
          }

          break;
        case CMND_MSG_INTERFACE_ESTABLISHED:
          break;
        case CMND_MSG_PROTOCOL_INTERFACE_ESTABLISHED:
          //perform protocol interface established procedure
          //
          vDEBUG("Proto cmndr, proto intf estab");
          //Tell the radio to go into receive mode
          //
          eIneedmd_radio_request_params_init (&tRadio_request);
          tRadio_request.eRequest = RADIO_REQUEST_RECEIVE_FRAME;
          eIneedmd_radio_request(&tRadio_request);
          break;
        case CMND_MSG_PROTOCOL_INTERFACE_CLOSED:
          break;
        default:
          break;
      }
    }
  }
}

#ifdef PrintCommand
void vCMND_ECHO_FRAME(const unsigned char * uiFrame, uint16_t uiFrame_len)
{
#ifdef DEBUG
  uint16_t uiIndex = 0, uiSend_index = 0;

//  uint8_t uiSend_Frame[256]; //todo: magic number warning!
  char * cSend_Frame = calloc((uiFrame_len * 3), sizeof(char));
  char cHex_format[] = "%.2x ";

  for(uiIndex = 0; uiIndex <= (uiFrame_len - 1); uiIndex++)
  {
    uiSend_index += snprintf((char *)&cSend_Frame[uiSend_index], 512, cHex_format, uiFrame[uiIndex]);
  }

  debug_out((char *)cSend_Frame);

  free(cSend_Frame);
#endif // DEBUG
}
#endif

#endif //__INEEDMD_COMMAND_PROTOCOL_C__
