Hoxford/tyler-woogduh/drivers/ineedmd_adc.c

/******************************************************************************
*
* ineedmd_adc.c - the adc driver code for EKG monitoring
* Copyright (c) notice
*
******************************************************************************/
#ifndef __INEEDMD_ADC_C__
#define __INEEDMD_A__
/******************************************************************************
* includes
******************************************************************************/
#include <stdio.h>
#include <stdbool.h>
#include <stdint.h>
#include <string.h>

#include <inc/hw_ints.h>
#include "inc/hw_types.h"
#include "inc/hw_memmap.h"
#include "inc/hw_gpio.h"
#include "driverlib/sysctl.h"
#include "driverlib/pin_map.h"
#include "driverlib/rom_map.h"
#include "driverlib/ssi.h"
#include "driverlib/gpio.h"
#include "driverlib/adc.h"

#include "utils_inc/error_codes.h"
#include "drivers_inc/ineedmd_adc.h"
#include "board.h"
#include "app_inc/ineedmd_power_modes.h"
#include "utils_inc/osal.h"

/******************************************************************************
* defines /////////////////////////////////////////////////////////////////////////////////////////////////////////////////////////////////////////////////////
******************************************************************************/

/******************************************************************************
* variables ///////////////////////////////////////////////////////////////////////////////////////////////////////////////////////////////////////////////////
******************************************************************************/
bool bIs_adc_powered_on = false;
/******************************************************************************
* external variables //////////////////////////////////////////////////////////////////////////////////////////////////////////////////////////////////////////
******************************************************************************/

/******************************************************************************
* enums ///////////////////////////////////////////////////////////////////////////////////////////////////////////////////////////////////////////////////////
******************************************************************************/

/******************************************************************************
* structures //////////////////////////////////////////////////////////////////////////////////////////////////////////////////////////////////////////////////
******************************************************************************/

static Hwi_Handle tADC_uPtemp_hwi;

/******************************************************************************
* external functions //////////////////////////////////////////////////////////////////////////////////////////////////////////////////////////////////////////
******************************************************************************/
extern Void ADCIsr(UArg a0);

/******************************************************************************
* private function declarations ///////////////////////////////////////////////////////////////////////////////////////////////////////////////////////////////
******************************************************************************/

//void ineedmd_adc_Hard_Reset();

/******************************************************************************
* private functions ///////////////////////////////////////////////////////////////////////////////////////////////////////////////////////////////////////////
******************************************************************************/

#ifdef NOT_NOW


//TODO: add function prototypes to header file
//TODO: include directory for delay function
//TODO: set shorter timebases for delay functions




/********************************************************************************
* send single byte command to ADC
*
* ensure device is not in continuous conversion mode
* using INEEDMD_ADC_Stop_Continuous_Conv() prior to calling this function
*
********************************************************************************/
void ineedmd_adc_Send_Command(uint32_t command)
{
  //put in write only mode
  //SSIAdvModeSet(INEEDMD_ADC_SPI, SSI_ADV_MODE_WRITE);
  //send single byte command

  //set the CS low
  GPIOPinWrite(GPIO_PORTA_BASE, INEEDMD_PORTA_ADC_nCS_PIN, 0x00);
  //2us at fullmspeed
   iHW_delay(1);

  SSIDataPut(INEEDMD_ADC_SPI, command);
  while(SSIBusy(INEEDMD_ADC_SPI))
  {
  }
  //when done set the CS high
  GPIOPinWrite(GPIO_PORTA_BASE, INEEDMD_PORTA_ADC_nCS_PIN, INEEDMD_PORTA_ADC_nCS_PIN);
}

//********************************************************************************
//returns the contents of the register specified by "address"
//
//see ads1198.h for register definitions
//
//ensure device is not in continuous conversion mode
//using INEEDMD_ADC_Stop_Continuous_Conv() prior to calling this function
//********************************************************************************
uint32_t ineedmd_adc_Register_Read(uint32_t address)
{
#ifdef USE_ENHANCED_ineedmd_adc_Register_Read
  //Write only SPI mode is enabled
  //SSIAdvModeSet(INEEDMD_ADC_SPI, SSI_ADV_MODE_WRITE);
  //setup bytes for a register read command
  ERROR_CODE eEC = ER_OK;
  uint32_t iEC = 0;
  uint16_t iDelay_ct = 0;
  uint32_t txData[2];
  uint32_t rxData;
  txData[0] = (RREG | address);   //mask with read command
  txData[1] = 0x00;        //read n + 1 bytes (1)

  int i;

  //set the CS low
  GPIOPinWrite(GPIO_PORTA_BASE, INEEDMD_PORTA_ADC_nCS_PIN, 0x00);
  //2us at fullmspeed
//  MAP_SysCtlDelay(60);
  iHW_delay(1);

  //send SPI command to tell ADC to output register content
  iEC = 0;
  iDelay_ct = 0;
  for(i = 0; i < 2; i++)
  {
    while(iEC == 0)
    {
      iEC = SSIDataPutNonBlocking(INEEDMD_ADC_SPI, txData[i]);
      if(iEC == 0)
      {
        iHW_delay(1);
        iDelay_ct++;
        if(iDelay_ct == 10)
        {
          eEC = ER_TIMEOUT;
          break;
        }
        else
        {
          eEC = ER_OK;
        }
      }
    }

    iDelay_ct = 0;
    iEC = SSIBusy(INEEDMD_ADC_SPI);
    while(iEC == 0)
    {
      iEC = SSIBusy(INEEDMD_ADC_SPI);
      if(iEC == 0)
      {
        iHW_delay(1);
        iDelay_ct++;
        if(iDelay_ct == 10)
        {
          eEC = ER_TIMEOUT;
          break;
        }
        else
        {
          eEC = ER_OK;
        }
      }
    }

    if(eEC != ER_OK)
    {
      break;
    }
  }

  //flush receive FIFO
  uint32_t flush = 0;
  while(SSIDataGetNonBlocking(SSI0_BASE, &flush))
  {
  }

  //enable R/W mode - data can be clocked into rx FIFO
  //SSIAdvModeSet(INEEDMD_ADC_SPI, SSI_ADV_MODE_READ_WRITE);

  if(eEC == ER_OK)
  {
    //send NOP to clock data in to FIFO
    SSIDataPut(INEEDMD_ADC_SPI, ADS1198_NOP);
    //wait for the NOP to clear out of the FIFO
    iEC = SSIBusy(INEEDMD_ADC_SPI);
    iDelay_ct = 0;
    while(iEC == 1)
    {
      iEC = SSIBusy(INEEDMD_ADC_SPI);
      if(iEC == 0)
      {
        iHW_delay(1);
        iDelay_ct++;
        if(iDelay_ct == 10)
        {
          eEC = ER_TIMEOUT;
          break;
        }
        else
        {
          eEC = ER_OK;
        }
      }
    }
  }

  //read FIFO
  if(eEC == ER_OK)
  {
    iEC = 0;
    iDelay_ct = 0;
    while(iEC == 0)
    {
      iEC = SSIDataGetNonBlocking(INEEDMD_ADC_SPI, &rxData);
      if(iEC == 0)
      {
        iHW_delay(1);
        iDelay_ct++;
        if(iDelay_ct == 10)
        {
          eEC = ER_TIMEOUT;
          break;
        }
        else
        {
          eEC = ER_OK;
        }
      }
      else
      {
        //delay and read the SSI again to verify that there was data on the bus and there was not a false positive
        iHW_delay(1);
        iEC = SSIDataGetNonBlocking(INEEDMD_ADC_SPI, &rxData);
      }
    }
  }

  //mask the receive buffer to isolate only the needed bits
  rxData &= 0x00FF;

  //when done set the CS high
  GPIOPinWrite(GPIO_PORTA_BASE, INEEDMD_PORTA_ADC_nCS_PIN, INEEDMD_PORTA_ADC_nCS_PIN);
  //CS
  //put back into write only mode
  //SSIAdvModeSet(INEEDMD_ADC_SPI, SSI_ADV_MODE_WRITE);
  return rxData;
#else
  //Write only SPI mode is enabled
  //SSIAdvModeSet(INEEDMD_ADC_SPI, SSI_ADV_MODE_WRITE);
  //setup bytes for a register read command
  uint32_t txData[2];
  txData[0] = (RREG | address);   //mask with read command
  txData[1] = 0x00;       //read n + 1 bytes (1)

  int i;

  //set the CS low
  GPIOPinWrite(GPIO_PORTA_BASE, INEEDMD_PORTA_ADC_nCS_PIN, 0x00);
  //2us at fullmspeed
  MAP_SysCtlDelay(60);


  //send SPI command to tell ADC to output register content
  for(i = 0; i < 2; i++)
  {
    SSIDataPut(INEEDMD_ADC_SPI, txData[i]);
    while(SSIBusy(INEEDMD_ADC_SPI))
    {
    }
  }

  //flush receive FIFO
  uint32_t flush;
  while(SSIDataGetNonBlocking(SSI0_BASE, &flush))
  {
  }

  //enable R/W mode - data can be clocked into rx FIFO
  //SSIAdvModeSet(INEEDMD_ADC_SPI, SSI_ADV_MODE_READ_WRITE);

  //send NOP to clock data in to FIFO
  SSIDataPut(INEEDMD_ADC_SPI, ADS1198_NOP);
  while(SSIBusy(INEEDMD_ADC_SPI))
      {
      }

  //read FIFO
  uint32_t rxData;
  SSIDataGet(INEEDMD_ADC_SPI, &rxData);
  rxData &= 0x00FF;

  //when done set the CS high
  GPIOPinWrite(GPIO_PORTA_BASE, INEEDMD_PORTA_ADC_nCS_PIN, INEEDMD_PORTA_ADC_nCS_PIN);
  //CS
  //put back into write only mode
  //SSIAdvModeSet(INEEDMD_ADC_SPI, SSI_ADV_MODE_WRITE);
  return rxData;
#endif
}

//********************************************************************************
//writes the value to register address in ads1198
//
//see ads1198.h for register definitions
//
//ensure device is not in continuous conversion mode
//using INEEDMD_ADC_Stop_Continuous_Conv() prior to calling this function
//********************************************************************************
void ineedmd_adc_Register_Write(uint32_t address, uint32_t value)
{
  //Write only SPI mode is enabled
  //SSIAdvModeSet(INEEDMD_ADC_SPI, SSI_ADV_MODE_WRITE);
  //setup bytes for a register write command
  uint32_t txData[3];
  txData[0] = (WREG | address);   //mask with read command
  txData[1] = 0x00;        //write n + 1 bytes (1)
  txData[2] = ineedmd_adc_Register_Read(address);  //get current value of register
  txData[2] |= value;                //mask with new value
  int i;

  //set the CS low
  GPIOPinWrite(GPIO_PORTA_BASE, INEEDMD_PORTA_ADC_nCS_PIN, 0x00);
  //2us at fullmspeed
  MAP_SysCtlDelay(60);


  //send write command followed by data
  for(i = 0; i < 3; i++)
  {
    SSIDataPut(INEEDMD_ADC_SPI, txData[i]);
    while(SSIBusy(INEEDMD_ADC_SPI))
    {
    }
  }

  //when done set the CS high
  GPIOPinWrite(GPIO_PORTA_BASE, INEEDMD_PORTA_ADC_nCS_PIN, INEEDMD_PORTA_ADC_nCS_PIN);

}

//********************************************************************************
//start the internal voltage reference at 2.7V
//sets PD_REFBUF bit in CONFIG3 register
//
//ensure device is not in continuous conversion mode
//using INEEDMD_ADC_Stop_Continuous_Conv() prior to calling this function
//********************************************************************************
void ineedmd_adc_Start_Internal_Reference()
{
  uint32_t val = ineedmd_adc_Register_Read(CONFIG3);
  val |= PD_REFBUF;

  //set the CS low
  GPIOPinWrite(GPIO_PORTA_BASE, INEEDMD_PORTA_ADC_nCS_PIN, 0x00);
  //2us at fullmspeed
  MAP_SysCtlDelay(60);


  ineedmd_adc_Register_Write(CONFIG3, val);
  //wait for reference to start
    //todo proper delay not sleep
    sleep_for_tenths(10);

  //when done set the CS high
  GPIOPinWrite(GPIO_PORTA_BASE, INEEDMD_PORTA_ADC_nCS_PIN, INEEDMD_PORTA_ADC_nCS_PIN);

}

//********************************************************************************
//raise start pin to begin ADC conversions
//DRDY will indicate conversion result is ready
//********************************************************************************
void ineedmd_adc_Start_High()
{
  GPIOPinWrite(GPIO_PORTA_BASE, INEEDMD_PORTA_ADC_START_PIN, INEEDMD_PORTA_ADC_START_PIN);
}

//send RDATA command
////
//ensure device is not in continuous conversion mode
//using ineedmd_adc_Stop_Continuous_Conv() prior to calling this function
//
//start pin must be high
//********************************************************************************
void ineedmd_adc_Request_Data()
{


  ineedmd_adc_Send_Command(ADS1198_RDATA);

}

//********************************************************************************
//read a full conversion
//call after ineedmd_adc_DRDY_PIN goes high
//takes a pointer to an array of integers
//fills array with received data from ADC
//********************************************************************************
void ineedmd_adc_Receive_Data(char* data)
{
  //enable read to clock data into rx FIFO
  //SSIAdvModeSet(INEEDMD_ADC_SPI, SSI_ADV_MODE_READ_WRITE);
  //flush receive FIFO
  uint32_t flush;


  //when set the CS low
  GPIOPinWrite(GPIO_PORTA_BASE, INEEDMD_PORTA_ADC_nCS_PIN, 0x00);
  //2us at fullmspeed
  MAP_SysCtlDelay(60);

  while(SSIDataGetNonBlocking(SSI0_BASE, &flush))
  {
  }
  uint32_t dat;
  int i;
  //read 19 bytes of data
  for(i = 0; i < INEEDMD_ADC_DATA_SIZE; i++)
  {
    //send NOP to clock data into Rx FIFO
    SSIDataPut(INEEDMD_ADC_SPI, ADS1198_NOP);
    while(SSIBusy(INEEDMD_ADC_SPI))
    {
    }
    //read Rx FIFO
    SSIDataGet(INEEDMD_ADC_SPI, &dat);
    data[i] = dat;
  }
  while(SSIDataGetNonBlocking(SSI0_BASE, &flush))
    {
    }
  //SSIAdvModeSet(INEEDMD_ADC_SPI, SSI_ADV_MODE_WRITE);

  //when done set the CS high
  GPIOPinWrite(GPIO_PORTA_BASE, INEEDMD_PORTA_ADC_nCS_PIN, INEEDMD_PORTA_ADC_nCS_PIN);


}
#endif //NOT_NOW

/******************************************************************************
* public functions ////////////////////////////////////////////////////////////////////////////////////////////////////////////////////////////////////////////
******************************************************************************/

#ifdef NOT_NOW

ERROR_CODE eIneedmd_adc_Power_status(void)
{
  ERROR_CODE eEC = ER_OFF;

  if(bIs_adc_powered_on == true)
  {
    eEC = ER_ON;
  }
  else
  {
    eEC = ER_OFF;
  }

  return eEC;
}

//********************************************************************************
//Stops the internal voltage reference at 2.7V
//sets PD_REFBUF bit in CONFIG3 register
//
//ensure device is not in continuous conversion mode
//using INEEDMD_ADC_Stop_Continuous_Conv() prior to calling this function
//********************************************************************************
void ineedmd_adc_Stop_Internal_Reference()
{
}

//*****************************************************************************
// name:
// description:
// param description:
// return value description:
//*****************************************************************************
void switch_on_adc_for_lead_detection(void)
{
  //switch on the SPI port
  EKGSPIEnable();

  GPIOPinWrite(GPIO_PORTA_BASE, INEEDMD_PORTA_ADC_nCS_PIN, INEEDMD_PORTA_ADC_nCS_PIN);

  //when done set the CS high
  ineedmd_adc_Start_Low();
  //power on ADC, disable continuous conversions
  ineedmd_adc_Power_On();
  //turn off continuous conversion for register read/writes
  ineedmd_adc_Stop_Continuous_Conv();

  //id = INEEDMD_ADC_Get_ID();
  ineedmd_adc_Enable_Lead_Detect();
  //increase comparator threshold for lead off detect
  uint32_t regVal = ineedmd_adc_Register_Read(LOFF);
  ineedmd_adc_Register_Write(LOFF, (regVal | ILEAD_OFF0 | ILEAD_OFF1));
  //check that we can read the device if not reset

  //start conversions
  ineedmd_adc_Start_Internal_Reference();
  ineedmd_adc_Start_High();

  return;
}

//*****************************special register read functions*******************

//********************************************************************************
//read ID register of ADS1198
//
//ensure device is not in continuous conversion mode
//using INEEDMD_ADC_Stop_Continuous_Conv() prior to calling this function
//********************************************************************************
uint32_t ineedmd_adc_Get_ID()
{
  return ineedmd_adc_Register_Read(ADS1198_ID_ADDRESS);


}

//********************************************************************************
//manually check if any of the leads are off
//lower 16 bits of data indicates which leads are off (if any)
//data format:
//[0x0000] [ 8P 7P 6P 5P 4P 3P 2P 1P ] [ 8N 7N 6N 5N 4N 3N 2N 1N ]
//returns 0 if all leads on
//
//ensure device is not in continuous conversion mode
//using INEEDMD_ADC_Stop_Continuous_Conv() prior to calling this function
//********************************************************************************
uint32_t ineedmd_adc_Check_Lead_Off()
{
  uint32_t leadStat = 0;

  leadStat |= ineedmd_adc_Register_Read(LOFF_STATN);
  leadStat |= (ineedmd_adc_Register_Read(LOFF_STATP) << 8);
  //mask lower 16bits
  leadStat &= 0xFFFF;

  return leadStat;
}

//********************************************************************************
//checks if Right Leg Drive was connected during power up
//returns 0 if RLD connected
//returns 1 if RLD disconnected
//
//ensure device is not in continuous conversion mode
//using INEEDMD_ADC_Stop_Continuous_Conv() prior to calling this function
//********************************************************************************
uint32_t ineedmd_adc_Check_RLD_Lead()
{

  uint32_t statRLD = ineedmd_adc_Register_Read(CONFIG3);
  //mask unwanted bits
  statRLD &= RLD_STAT;
  return statRLD;
}

//********************************************************************************
//checks if lead off status matches the update device condition
//returns 0 if no update required
//returns 1 if update required
//
//ensure device is not in continuous conversion mode
//using INEEDMD_ADC_Stop_Continuous_Conv() prior to calling this function
//********************************************************************************
int ineedmd_adc_Check_Update()
{
  uint32_t leadStat = ineedmd_adc_Check_Lead_Off();
  if(leadStat == UPDATE_DEVICE_CONDITION)
  {
    return 1;
  }
  else
  {
    return 0;
  }
}

/********************************************************************************
 * Sets up the test generation mode.
 *
 * returns 0 if no update required
 * returns 1 if update required
 *
 * Parameters are -
 * TEST_MODE_NORMAL_FREQUENCY | TEST_MODE_FAST_FREQUENCY to set up the frequency of the waveform
 * TEST_MODE_NOMINAL_VOLTAGE | TEST_MODE_HIGH_VOLTAGE to set up the output voltage
 *
 * ineedmd_adc_Test_Mode_Disable() cancels the test mode and resets the MUX
********************************************************************************/
int ineedmd_adc_Test_Mode_Enable(int test_signal_frequency, int test_signal_voltage)
{
  //Set up the test signal to on - at the frequency we want, and at the voltage we want
  ineedmd_adc_Register_Write(TEST_REGISTER, ( TEST_MODE_ENABLE | test_signal_frequency | test_signal_voltage));
  //set up the gain to the default so we don't damage the frontend
  ineedmd_adc_gain_set (GAIN_6_X);
  //set up the input mux to pass the test signals to the ADC
  ineedmd_adc_mux_set (MUX_TEST);
  return 1;
}
/* End Test mode enable */

/********************************************************************************
 * Configures the pins and functionaloty for the WTC and switches it on
********************************************************************************/
int ineedmd_adc_WTC_Enable()
{
  //Power up and configure the Wilson current mirror - A
  ineedmd_adc_Register_Write(WCT1, ( POWER_UP_WTCA | WTC_A_CHANNEL ));
  //Power up and configure the Wilson current mirror - A and B
  ineedmd_adc_Register_Write(WCT2, ( POWER_UP_WTCB | WTC_B_CHANNEL | POWER_UP_WTCC | WTC_C_CHANNEL ));
  return 1;
}
/* End ineedmd_adc_WTC_Enable */

/********************************************************************************
 * Configures the pins and functionaloty for the WTC and switches it on
********************************************************************************/
int ineedmd_adc_WTC_Disable()
{
  //Power up and configure the Wilson current mirror - A
  ineedmd_adc_Register_Write(WCT1, POWER_DOWN_WTC );
  //Power up and configure the Wilson current mirror - A and B
  ineedmd_adc_Register_Write(WCT2, POWER_DOWN_WTC );
  return 1;
}
/* End ineedmd_adc_WTC_Disable */

int ineedmd_adc_RLA_Enable()
{
   uint32_t config3_initial_value;

  //set up the WTC amp feeder
  ineedmd_adc_Register_Write(WCT1, ( EKG_V6 | EKG_V5 | EKG_V4 | EKG_V3 | EKG_LA | EKG_LL | EKG_V2 | EKG_V1 ));
  //set up the WTC amp feeder
  ineedmd_adc_Register_Write(WCT2, (  EKG_RA1 ));

  //read the config register
  config3_initial_value = ineedmd_adc_Register_Read(CONFIG3);
  //set the rld buffer to on
  ineedmd_adc_Register_Write(CONFIG3, ( config3_initial_value ^  PD_RLD ));
    return 1;
}
/* End ineedmd_adc_RLA_Enable */


int ineedmd_adc_RLA_Disable()
{
  uint32_t config3_initial_value;

  //Disconnect the RLD leads
  ineedmd_adc_Register_Write(WCT1, ( RLD_NO_LEAD ));
  //Disconnect the RLD leads
  ineedmd_adc_Register_Write(WCT2, ( RLD_NO_LEAD ));
  //read the config register
  config3_initial_value = ineedmd_adc_Register_Read(CONFIG3);
  //switch off the drive buffer
  ineedmd_adc_Register_Write(CONFIG3, (  config3_initial_value | !PD_RLD ));
  return 1;
}
/* End ineedmd_adc_RLA_Disable */

/********************************************************************************
 * Configures the pins and functionaloty for the WTC and switches it on
********************************************************************************/

/********************************************************************************
 * Sets the Gain position of all the channels to the same position
 *
 ******************************************************************************/
int ineedmd_adc_gain_set(int gain_position)
{
   int initial_gain_position;

   //read the initial position of the mux
   initial_gain_position = ineedmd_adc_Register_Read(CH1SET);
   ineedmd_adc_Register_Write(CH1SET, ( (initial_gain_position & 0x8f) | gain_position));

   initial_gain_position = ineedmd_adc_Register_Read(CH2SET);
   ineedmd_adc_Register_Write(CH2SET, ( (initial_gain_position & 0x8f) | gain_position));

   initial_gain_position = ineedmd_adc_Register_Read(CH3SET);
   ineedmd_adc_Register_Write(CH3SET, ( (initial_gain_position & 0x8f) | gain_position));

   initial_gain_position = ineedmd_adc_Register_Read(CH4SET);
   ineedmd_adc_Register_Write(CH4SET, ( (initial_gain_position & 0x8f) | gain_position));

   initial_gain_position = ineedmd_adc_Register_Read(CH5SET);
   ineedmd_adc_Register_Write(CH5SET, ( (initial_gain_position & 0x8f) | gain_position));

   initial_gain_position = ineedmd_adc_Register_Read(CH6SET);
   ineedmd_adc_Register_Write(CH6SET, ( (initial_gain_position & 0x8f) | gain_position));

   initial_gain_position = ineedmd_adc_Register_Read(CH7SET);
   ineedmd_adc_Register_Write(CH7SET, ( (initial_gain_position & 0x8f) | gain_position));

   initial_gain_position = ineedmd_adc_Register_Read(CH8SET);
   ineedmd_adc_Register_Write(CH8SET, ( (initial_gain_position & 0x8f) | gain_position));

   return 1;
}
/* End ineedmd_adc_mux_set */

/********************************************************************************
 * Sets the MUX position of all the channels to the same position
 *
 ******************************************************************************/
int ineedmd_adc_mux_set(int mux_position)
{
   int initial_mux_position;

   //read the initial position of the mux
   initial_mux_position = ineedmd_adc_Register_Read(CH1SET);
   ineedmd_adc_Register_Write(CH1SET, ( (initial_mux_position & 0xF8) | mux_position));

   initial_mux_position = ineedmd_adc_Register_Read(CH2SET);
   ineedmd_adc_Register_Write(CH2SET, ( (initial_mux_position & 0xF8) | mux_position));

   initial_mux_position = ineedmd_adc_Register_Read(CH3SET);
   ineedmd_adc_Register_Write(CH3SET, ( (initial_mux_position & 0xF8) | mux_position));

   initial_mux_position = ineedmd_adc_Register_Read(CH4SET);
   ineedmd_adc_Register_Write(CH4SET, ( (initial_mux_position & 0xF8) | mux_position));

   initial_mux_position = ineedmd_adc_Register_Read(CH5SET);
   ineedmd_adc_Register_Write(CH5SET, ( (initial_mux_position & 0xF8) | mux_position));

   initial_mux_position = ineedmd_adc_Register_Read(CH6SET);
   ineedmd_adc_Register_Write(CH6SET, ( (initial_mux_position & 0xF8) | mux_position));

   initial_mux_position = ineedmd_adc_Register_Read(CH7SET);
   ineedmd_adc_Register_Write(CH7SET, ( (initial_mux_position & 0xF8) | mux_position));

   initial_mux_position = ineedmd_adc_Register_Read(CH8SET);
   ineedmd_adc_Register_Write(CH8SET, ( (initial_mux_position & 0xF8) | mux_position));

   return 1;
}
/* End ineedmd_adc_mux_set */

/******************************************************************************
* set the adc sampling rate
* 0 = 8kSPS
* 1 = 4k
* 2 = 2k
* 3 = 1k
* 4 = 500
* 5 = 250
* 6 = 125
*
* ensure device is not in continuous conversion mode
* using INEEDMD_ADC_Stop_Continuous_Conv() prior to calling this function
******************************************************************************/
void ineedmd_adc_Set_Sample_Rate(uint32_t SPS)
{

  //if out of bounds, default to 500 SPS
  if(SPS > 6)
  {
    SPS = 4;
  }
  //mask SPS value with current CONFIG1 register to preserve other settings
  SPS |= ineedmd_adc_Register_Read(CONFIG1);
  //write new SPS value
  ineedmd_adc_Register_Write(CONFIG1, SPS);
}

//********************************************************************************
//Enable lead off detection
//
//Uses default configuration:
//  Current source detection
//  DC excititation signal
//  4nA current magnitude
//  95% Positive / 5% negative for comparator threshold
//********************************************************************************
void ineedmd_adc_Enable_Lead_Detect()
{
  ineedmd_adc_Register_Write(LOFF, FLEAD_OFF0 | FLEAD_OFF1);
  ineedmd_adc_Register_Write(CONFIG4, PD_LOFF_COMP);
  ineedmd_adc_Register_Write(LOFF_SENSP, 0xFFFF);
  ineedmd_adc_Register_Write(LOFF_SENSN, 0xFFFF);

  //increase comparator threshold for lead off detect
  uint32_t regVal = ineedmd_adc_Register_Read(LOFF);
  ineedmd_adc_Register_Write(LOFF, (regVal | ILEAD_OFF0 | ILEAD_OFF1 | COMP_TH1 | COMP_TH2 ));
}

//configure to use 3 lead setup
//turns off unused channels
//
//ensure device is not in continuous conversion mode
//using INEEDMD_ADC_Stop_Continuous_Conv() prior to calling this function
//********************************************************************************
void ineedmd_adc_3_Lead_Config()
{

}

//configure to use 12 lead setup
//turns on all channels
//
//ensure device is not in continuous conversion mode
//using INEEDMD_ADC_Stop_Continuous_Conv() prior to calling this function
//********************************************************************************
void ineedmd_adc_12_Lead_Config()
{

}

#endif //NOT_NOW

/******************************************************************************
* name: iADC_get_unit_tempoerature
* description: returns the current system temperature in tenths of a degree
*              fahrenheit resolution.
* param description: none
*
* return value description: int - 0: temperature not read
*                               - -1: temperature read failure
*                               - integer: temperature in tenths of a degree fahrenheit
******************************************************************************/
int iADC_get_unit_temperature(void)
{
  uint32_t TempValueC = 720;
//  uint32_t temp_adc_return_value;
//
//  eBSP_TemperatureMeasureADCEnable();
//
//  ADCProcessorTrigger(TEMPERATURE_ADC, 3);
//  //
//  // Wait for conversion to be completed.
//  //
//  while(!ADCIntStatus(TEMPERATURE_ADC, 3, false))
//  {
//  }
//  //
//  // Clear the ADC interrupt flag.
//  //
//  ADCIntClear(TEMPERATURE_ADC, 3);
//  //
//  // Read ADC Value.
//  //
//  ADCSequenceDataGet(TEMPERATURE_ADC, 3, &temp_adc_return_value);
//
//  eBSP_TemperatureMeasureADCDisable();
//  TempValueC = ((1475 * 1023) - (2250 * temp_adc_return_value)) / 10230;

  return (int)TempValueC;

}

//*****************************************************************************
// name: iADC_setup
// description: sets up the A to D converter driver
// param description: none
// return value description: 1 if success
//*****************************************************************************
ERROR_CODE eADC_setup(void)
{
  Error_Block eb;
  ERROR_CODE eEC = ER_FAIL;
  uint32_t regVal;

  /* Install interrupt handler */
//  tADC_uPtemp_hwi = Hwi_create(INT_ADC1SS0, ADCIsr, NULL, &eb);
//  if (tADC_uPtemp_hwi == NULL) {
//      System_abort("Can't create USB Hwi");
//  }

  eEC = eBSP_ADC_SPI_Enable();

  if(eEC == ER_OK)
  {
    eEC = eBSP_ADC_Start(false);
  }

  if(eEC == ER_OK)
  {
    //power on ADC, disable continuous conversions
    eEC = eBSP_ADC_Power(true);
  }

  if(eEC == ER_OK)
  {
    eEC = eBSP_ADC_Hard_Reset();
  }


  if(eEC == ER_OK)
  {
    //turn off continuous conversion for register read/writes
    eEC = eBSP_ADC_Continuous_Conv(false);
  }

#ifdef NOT_YET
  ineedmd_adc_Enable_Lead_Detect();

  //increase comparator threshold for lead off detect
  regVal = ineedmd_adc_Register_Read(LOFF);
  ineedmd_adc_Register_Write(LOFF, (regVal | ILEAD_OFF0 | ILEAD_OFF1));

  //start conversions
  ineedmd_adc_Start_Internal_Reference();
  ineedmd_adc_Start_High();
#endif
  return eEC;
}

#endif //#define __INEEDMD_A__
