Hoxford/tyler-woogduh/drivers/USBMSCD.c

/*
 * Copyright (c) 2014, Texas Instruments Incorporated
 * All rights reserved.
 *
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
 * *  Redistributions of source code must retain the above copyright
 *    notice, this list of conditions and the following disclaimer.
 *
 * *  Redistributions in binary form must reproduce the above copyright
 *    notice, this list of conditions and the following disclaimer in the
 *    documentation and/or other materials provided with the distribution.
 *
 * *  Neither the name of Texas Instruments Incorporated nor the names of
 *    its contributors may be used to endorse or promote products derived
 *    from this software without specific prior written permission.
 *
 * THIS SOFTWARE IS PROVIDED BY THE COPYRIGHT HOLDERS AND CONTRIBUTORS "AS IS"
 * AND ANY EXPRESS OR IMPLIED WARRANTIES, INCLUDING, BUT NOT LIMITED TO,
 * THE IMPLIED WARRANTIES OF MERCHANTABILITY AND FITNESS FOR A PARTICULAR
 * PURPOSE ARE DISCLAIMED. IN NO EVENT SHALL THE COPYRIGHT OWNER OR
 * CONTRIBUTORS BE LIABLE FOR ANY DIRECT, INDIRECT, INCIDENTAL, SPECIAL,
 * EXEMPLARY, OR CONSEQUENTIAL DAMAGES (INCLUDING, BUT NOT LIMITED TO,
 * PROCUREMENT OF SUBSTITUTE GOODS OR SERVICES; LOSS OF USE, DATA, OR PROFITS;
 * OR BUSINESS INTERRUPTION) HOWEVER CAUSED AND ON ANY THEORY OF LIABILITY,
 * WHETHER IN CONTRACT, STRICT LIABILITY, OR TORT (INCLUDING NEGLIGENCE OR
 * OTHERWISE) ARISING IN ANY WAY OUT OF THE USE OF THIS SOFTWARE,
 * EVEN IF ADVISED OF THE POSSIBILITY OF SUCH DAMAGE.
 */

/*
 *  ======== USBMSCD.c ========
 */

/* XDCtools Header files */
//#include <xdc/std.h>
//#include <xdc/runtime/Error.h>
//#include <xdc/runtime/System.h>

#include "utils_inc/error_codes.h"

/* BIOS Header files */
//#include <ti/sysbios/BIOS.h>
//#include <ti/sysbios/fatfs/diskio.h>
//#include <ti/sysbios/gates/GateMutexPri.h>
//#include <ti/sysbios/hal/Hwi.h>
//#include <ti/sysbios/knl/Clock.h>
//#include <ti/sysbios/knl/Semaphore.h>

/* TI-RTOS driver header files */
#include <ti/drivers/SDSPI.h>

#include "utils_inc/proj_debug.h"
#include "utils_inc/osal.h"

#include <stdint.h>

/* driverlib Header files */
#include <inc/hw_ints.h>
#include <inc/hw_types.h>
#include <driverlib/udma.h>

/* usblib Header files */
#include <usblib/usb-ids.h>
#include <usblib/usblib.h>
#include <usblib/usbhid.h>
#include <usblib/device/usbdevice.h>
#include <usblib/device/usbdmsc.h>

/* Example/Board Header files */
#include "USBMSCD.h"
#include "board.h"

/* Static variables and handles */

void (* vUSB_MSCD_change_cb)(void) = NULL;

/* Typedefs */

/* Static variables and handles */
static volatile USBMSD_USBState eUSBMSD_state;

static volatile struct {
    unsigned int drive;
} driveInformation;

static GateMutex_Handle gateUSBWait;
static Semaphore_Handle semUSB_Disconnected;
static Hwi_Handle hwi;

#pragma DATA_SECTION(DMAControlTable, ".dma");
#pragma DATA_ALIGN(DMAControlTable, 1024)
static tDMAControlTable DMAControlTable[64];
static tMSCInstance MSCInstance;

/* Function prototypes */
/*
 * There is no need to have a callback function at the moment as all the
 * callbacks to the required functions are already called in a Hwi context.
 * The callback handler is kept commented out so that it can be easily enabled
 * for future developement.
 */
static unsigned int cbMSCHandler(void *cbData, unsigned int event,
                                 unsigned int eventMsg, void *eventMsgPtr);
void vUSB_Disconnect_callback(void);
static void close(void *drv);
extern void USBMSCD_hwiHandler(UArg arg0);
//static unsigned int numBlocks(void *drv);
static uint32_t numBlocks(void *drv);
static uint32_t blockSize(void *drv);
static void *open(unsigned int drv);
//static unsigned int read(void *drv,
static uint32_t     read(void *drv,
                         unsigned char *data,
                         unsigned int sector,
                         unsigned int blockCount);
//static unsigned int write(void *drv,
static uint32_t     write(void *drv,
                          unsigned char *data,
                          unsigned int sector,
                          unsigned int blockCount);
void USBMSCD_init(void);

/* Extern'd functions from the SD Driver */
//extern DSTATUS SDSPI_diskInitialize(unsigned char drv);
extern DSTATUS SDSPITiva_diskInitialize(unsigned char drv);
//extern DRESULT SDSPI_diskRead(unsigned char drv, unsigned char *buff,
//                              unsigned int sector, unsigned char count);
extern DRESULT SDSPITiva_diskRead(unsigned char drv, unsigned char *buff,
                              unsigned int sector, unsigned char count);
//extern DRESULT SDSPI_diskWrite(unsigned char drv, const unsigned char *buff,
//                               unsigned int sector, unsigned char count);
extern DRESULT SDSPITiva_diskWrite(unsigned char drv, const unsigned char *buff,
                               unsigned int sector, unsigned char count);
//extern DRESULT SDSPI_diskIOctrl(unsigned char drv, unsigned char ctrl, void *buff);
extern DRESULT SDSPITiva_diskIOctrl(unsigned char drv, unsigned char ctrl, void *buff);

/* The languages supported by this device. */
const unsigned char langDescriptor[] =
{
    4,
    USB_DTYPE_STRING,
    USBShort(USB_LANG_EN_US)
};

/* The manufacturer string. */
const unsigned char manufacturerString[] =
{
    (17 + 1) * 2,
    USB_DTYPE_STRING,
    'T', 0, 'e', 0, 'x', 0, 'a', 0, 's', 0, ' ', 0, 'I', 0, 'n', 0, 's', 0,
    't', 0, 'r', 0, 'u', 0, 'm', 0, 'e', 0, 'n', 0, 't', 0, 's', 0,
};

/* The product string. */
const unsigned char productString[] =
{
    (19 + 1) * 2,
    USB_DTYPE_STRING,
    'M', 0, 'a', 0, 's', 0, 's', 0, ' ', 0, 'S', 0, 't', 0, 'o', 0, 'r', 0,
    'a', 0, 'g', 0, 'e', 0, ' ', 0, 'D', 0, 'e', 0, 'v', 0, 'i', 0, 'c', 0,
    'e', 0
};

/* The serial number string. */
const unsigned char serialNumberString[] =
{
    (8 + 1) * 2,
    USB_DTYPE_STRING,
    '1', 0, '2', 0, '3', 0, '4', 0, '5', 0, '6', 0, '7', 0, '8', 0
};

/* The interface description string. */
const unsigned char dataInterfaceString[] =
{
    (19 + 1) * 2,
    USB_DTYPE_STRING,
    'B', 0, 'u', 0, 'l', 0, 'k', 0, ' ', 0, 'D', 0, 'a', 0, 't', 0,
    'a', 0, ' ', 0, 'I', 0, 'n', 0, 't', 0, 'e', 0, 'r', 0, 'f', 0,
    'a', 0, 'c', 0, 'e', 0
};

/* The configuration description string. */
const unsigned char configString[] =
{
    (23 + 1) * 2,
    USB_DTYPE_STRING,
    'B', 0, 'u', 0, 'l', 0, 'k', 0, ' ', 0, 'D', 0, 'a', 0, 't', 0,
    'a', 0, ' ', 0, 'C', 0, 'o', 0, 'n', 0, 'f', 0, 'i', 0, 'g', 0,
    'u', 0, 'r', 0, 'a', 0, 't', 0, 'i', 0, 'o', 0, 'n', 0
};

/* The descriptor string table. */
const unsigned char * const stringDescriptors[] =
{
    langDescriptor,
    manufacturerString,
    productString,
    serialNumberString,
    dataInterfaceString,
    configString
};

#define STRINGDESCRIPTORSCOUNT (sizeof(stringDescriptors) / \
                                sizeof(unsigned char *))

tUSBDMSCDevice MSCDevice =
{
    USB_VID_TI_1CBE,               //const uint16_t ui16VID;
    USB_PID_MSC,                   //const uint16_t ui16PID;
    "TI      ",                    //const uint8_t pui8Vendor[8];
    "Mass Storage    ",            //const uint8_t pui8Product[16];
    "1.00",                        //const uint8_t pui8Version[4];
    0x01F4,                           //const uint16_t ui16MaxPowermA;  500
    USB_CONF_ATTR_SELF_PWR,        //const uint8_t ui8PwrAttributes;
    stringDescriptors,             //const uint8_t * const *ppui8StringDescriptors;
    STRINGDESCRIPTORSCOUNT,        //const uint32_t ui32NumStringDescriptors;
    /*
     * Set of callback functions that are called directly by the interrupt
     * service routine
     */
                                   //const tMSCDMedia sMediaFunctions;
    {
        open,                      //void *(*pfnOpen)(uint32_t ui32Drive);
        close,                     //void (*pfnClose)(void *pvDrive);
        read,                      //uint32_t (*pfnBlockRead)(void *pvDrive, uint8_t *pui8Data, uint32_t ui32Sector, uint32_t ui32NumBlocks);
        write,                     //uint32_t (*pfnBlockWrite)(void *pvDrive, uint8_t *pui8Data, uint32_t ui32Sector, uint32_t ui32NumBlocks);
        numBlocks,                 //uint32_t (*pfnNumBlocks)(void *pvDrive);
        blockSize,                 //uint32_t (*pfnBlockSize)(void *pvDrive);
    },
    &cbMSCHandler,                 //const tUSBCallback pfnEventCallback;
//    &MSCInstance                   //tMSCInstance sPrivateData;
};

/*
 *  ======== cbMSCHandler ========
 *  Callback handler for the USB stack.
 *
 *  Callback handler call by the USB stack to notify us on what has happened in
 *  regards to the keyboard.
 *
 *  @param(cbData)          A callback pointer provided by the client.
 *
 *  @param(event)           Identifies the event that occurred in regards to
 *                          this device.
 *
 *  @param(eventMsgData)    A data value associated with a particular event.
 *
 *  @param(eventMsgPtr)     A data pointer associated with a particular event.
 *
 */
static unsigned int cbMSCHandler(void *cbData, unsigned int event,
                                 unsigned int eventMsg, void *eventMsgPtr)
{
    /* Determine what event has happened */
    switch (event) {
        case USB_EVENT_CONNECTED:
          eUSBMSD_state = USBMSD_STATE_IDLE;
          if(vUSB_MSCD_change_cb != NULL)
          {
            vUSB_MSCD_change_cb();
          }
            break;

        case USB_EVENT_DISCONNECTED:
          Semaphore_post(semUSB_Disconnected);
            break;

        case USBD_MSC_EVENT_WRITING:
            break;

        case USBD_MSC_EVENT_READING:
            break;

        case USBD_MSC_EVENT_IDLE:
        default:
            break;
    }

    return (0);
}

/*
 *  ======== close ========
 */
static void close(void *drv)
{
  /* Nothing needs to be done here */
  return;
}

/*
 *  ======== USBMSCD_hwiHandler ========
 *  This function calls the USB library's device interrupt handler.
 */
void USBMSCD_hwiHandler(UArg arg0)
{
  USB0DeviceIntHandler();

  return;
}

void vUSB_hardware_int_callback(void)
{
  ERROR_CODE eEC = ER_FAIL;

  GPIO_clearInt(EK_TM4C123GXL_USB_DETECT);

  //read the USB connection pin to determin which semaphore to post
  eEC = eBSP_USB_is_physical_connection();
  if(eEC == ER_CONNECTED)
  {
    /* Set MSD state to unconfigured */
    eUSBMSD_state = USBMSD_STATE_UNCONFIGURED;

    GPIO_enableInt(EK_TM4C123GXL_USB_DETECT, GPIO_INT_FALLING);

  }
  else
  {
    /* Set MSD state to none */
    eUSBMSD_state = USBMSD_STATE_NONE;
    GPIO_enableInt(EK_TM4C123GXL_USB_DETECT, GPIO_INT_RISING);

  }

  if(vUSB_MSCD_change_cb != NULL)
  {
    vUSB_MSCD_change_cb();
  }
  return;
}

/*
 *  ======== numBlocks ========
 */
static uint32_t numBlocks(void *drv)
{
  unsigned int sectorCount;

  SDSPITiva_diskIOctrl(driveInformation.drive, GET_SECTOR_COUNT,
                  &sectorCount);
  return (sectorCount);
}

static uint32_t blockSize(void *drv)
{
  uint32_t uiDisk_Blk_size = 0;

//  SDSPITiva_diskIOctrl(driveInformation.drive, GET_BLOCK_SIZE,
  SDSPITiva_diskIOctrl(driveInformation.drive, GET_SECTOR_SIZE,
                  &uiDisk_Blk_size);

  return uiDisk_Blk_size;
}

/*
 *  ======== open ========
 */
static void *open(unsigned int drv)
{
  DSTATUS status;

  /* SD Card needs to get initialized */
  status = SDSPITiva_diskInitialize(drv);
  if (status != 0)
  {
    return (NULL);
  }

  /* Drive is not initialized, save status flags */
  driveInformation.drive = drv;

  return ((void *)&driveInformation);
}

/*
 *  ======== read ========
 */
static uint32_t read(void *drv, unsigned char *data, unsigned int sector, unsigned int blockCount)
{

  if (SDSPITiva_diskRead(driveInformation.drive, data,
                     sector, blockCount) == RES_OK) {
      return (blockCount * 512);
  }

  return (0);
}

/*
 *  ======== write ========
 */
static uint32_t write(void *drv, unsigned char *data, unsigned int sector, unsigned int blockCount)
{
    if (SDSPITiva_diskWrite(driveInformation.drive, data,
                        sector, blockCount) == RES_OK) {
        return (blockCount * 512); /* Fixed to 512 by the USB CDC driver */
    }

    return (0);
}

/******************************************************************************
* name: eUSB_MassStorage_waitForConnect
* description:
* param description: type - value: value description (in order from left to right)
*                    bool - true: do action when set to true
* return value description: ERROR_CODE - ER_CONNECTED: if USB was connected in the timout period
*                                      - ER_NOT_CONNECTED: if USB was not connected in the timeout period
*
******************************************************************************/

ERROR_CODE eUSB_MassStorage_data_connection(void)
{
  ERROR_CODE eEC = ER_FAIL;

  if(eUSBMSD_state == USBMSD_STATE_IDLE)
  {
    eEC = ER_CONNECTED;
  }
  else
  {
    eEC = ER_NOT_CONNECTED;
  }

  return eEC;
}

USBMSD_USBState  eUSB_MassStorage_state(void)
{
  return eUSBMSD_state;
}

ERROR_CODE eUSB_MSCD_register_cb(void (* vUSB_MSCD_change_callback)(void))
{
  ERROR_CODE eEC = ER_FAIL;
  if(vUSB_MSCD_change_callback != NULL)
  {
    vUSB_MSCD_change_cb = vUSB_MSCD_change_callback;
    eEC = ER_OK;
  }
  else
  {
    eEC = ER_FAIL;
  }

  return eEC;
}

ERROR_CODE eUSB_MSCD_check_physical_connection(void)
{
  ERROR_CODE eEC = ER_FAIL;

  //read the USB physical connect pin to determine if already physically plugged in
  eEC = eBSP_USB_is_physical_connection();
//  if(eEC == ER_CONNECTED)
//  {
//    /* Set MSD state to unconfigured */
//    eUSBMSD_state = USBMSD_STATE_UNCONFIGURED;
//
//    GPIO_enableInt(EK_TM4C123GXL_USB_DETECT, GPIO_INT_FALLING);
//    Semaphore_post(semUSB_Phys_Connected);
//  }
//  else
//  {
//    /* Set MSD state to none */
//    eUSBMSD_state = USBMSD_STATE_NONE;
//    GPIO_enableInt(EK_TM4C123GXL_USB_DETECT, GPIO_INT_RISING);
//  }

  return eEC;
}


/*
 *  ======== USBMSCD_init ========
 */
void USBMSCD_init(void)
{
    Error_Block eb;
    ERROR_CODE eEC = ER_FAIL;
    Semaphore_Params semParams;

    uDMAControlBaseSet(&DMAControlTable[0]);

    Error_init(&eb);

    Semaphore_Params_init(&semParams);
    semParams.mode = Semaphore_Mode_BINARY;

    /* Install interrupt handler */
    hwi = Hwi_create(INT_USB0, USBMSCD_hwiHandler, NULL, &eb);
    if (hwi == NULL) {
        System_abort("Can't create USB Hwi");
    }

    gateUSBWait = GateMutex_create(NULL, &eb);
    if (gateUSBWait == NULL) {
        System_abort("Could not create USB Wait gate");
    }

    /* Set up the GPIO callbacks for USB */
    GPIO_setupCallbacks(&Board_gpioCallbacks0);

    //read the USB physical connect pin to determine if already physically plugged in
    eEC = eBSP_USB_is_physical_connection();
    if(eEC == ER_CONNECTED)
    {
      /* Set MSD state to unconfigured */
      eUSBMSD_state = USBMSD_STATE_UNCONFIGURED;

      GPIO_enableInt(EK_TM4C123GXL_USB_DETECT, GPIO_INT_FALLING);

      if(vUSB_MSCD_change_cb != NULL)
      {
        vUSB_MSCD_change_cb();
      }
    }
    else
    {
      /* Set MSD state to none */
      eUSBMSD_state = USBMSD_STATE_NONE;
      GPIO_enableInt(EK_TM4C123GXL_USB_DETECT, GPIO_INT_RISING);
    }

    /* Set the USB stack mode to Device mode with VBUS monitoring */
    USBStackModeSet(0, eUSBModeDevice, 0);

    /*
     * Pass our device information to the USB HID device class driver,
     * initialize the USB controller and connect the device to the bus.
     */
    if (!USBDMSCInit(0, &MSCDevice)) {
        System_abort("Error initializing the MSC device");
    }
}
