Hoxford/tyler-woogduh/drivers/drivers_inc/ineedmd_led.h

/******************************************************************************
*
* ineedmd_led.h - LED driver include file
* Copyright (c) notice
*
******************************************************************************/
#ifndef __INEEDMD_LED_H__
#define __INEEDMD_LED_H__
/******************************************************************************
* includes ////////////////////////////////////////////////////////////////////////////////////////////////////////////////////////////////////////////////////
******************************************************************************/

/******************************************************************************
*public defines ///////////////////////////////////////////////////////////////////////////////////////////////////////////////////////////////////////////////
******************************************************************************/
#define INEEDMD_I2C_ADDRESS_LED_DRIVER  0x1b
#define INEEDMD_LED_OFF                 0x00
#define INEEDMD_LED1_RED_ENABLE         0x01
#define INEEDMD_LED1_BLUE_ENABLE        0x02
#define INEEDMD_LED1_GREEN_ENABLE       0x04
#define INEEDMD_LED2_RED_ENABLE         0x20
#define INEEDMD_LED2_BLUE_ENABLE        0x40
#define INEEDMD_LED2_GREEN_ENABLE       0x80

#define INEEDMD_LED1_RED_ILEVEL         0x00
#define INEEDMD_LED1_BLUE_ILEVEL        0x01
#define INEEDMD_LED1_GREEN_ILEVEL       0x02

#define INEEDMD_LED2_RED_ILEVEL         0x05
#define INEEDMD_LED2_BLUE_ILEVEL        0x06
#define INEEDMD_LED2_GREEN_ILEVEL       0x07
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
