Hoxford/tyler-woogduh/(commit log)

2014-07-18 demo 01
    [board.obj, ineedmd_bluetooth_radio.obj, ineedmd_led.obj, innedmd_adc.obj, main.obj, tm4c1233h6pm_startup_ccs.obj]
2014-07-18 POC 02
    [board.obj, ineedmd_bluetooth_radio.obj, ineedmd_led.obj, innedmd_adc.obj, main.obj, tm4c1233h6pm_startup_ccs.obj]
2014-07-18 ported in master code to playground project
    [board.obj, ineedmd_bluetooth_radio.obj, ineedmd_led.obj, innedmd_adc.obj, main.obj, tm4c1233h6pm_startup_ccs.obj]
2014-07-18 Merge branch 'master' of https://github.com/Hoxford/tyler-woogduh
    Conflicts:
    playground/USB-DFU_LED_PATIENT_OFF/Debug__TI/board.obj
    playground/USB-DFU_LED_PATIENT_OFF/Debug__TI/main.obj
    playground/USB-DFU_LED_PATIENT_OFF/Debug__TI/tm4c1233h6pm_startup_ccs.obj
2014-07-18 added changes and tried to get it to wake up when short removed.
    [board.c, ineedmd_bluetooth_radio.c, main.c, tm4c1233h6pm_startup_ccs.c]
2014-07-22 started battery driver low voltage detect
2014-07-22 finishing off the ADC read setup and the header setting some boundary conditions.
2014-07-24 added a playground project for the file system
    [helloWorld.cfg]
2014-07-28 added proper test project that starts Ti-RTOS and usues the File System
    [hello.cfg, helloWorld.cfg]
2014-07-29 radio driver changes, more stable
2014-07-29 changed the BT radio setup code AGAIN for stability, also added python command functions test script
    [board.c, board.h, commandFunctions.py, ineedmd_bluetooth_radio.c, ineedmd_bluetooth_radio.h]
2014-07-29 started adding radio driver to protocol interface handling
2014-07-30 switch serial from mac to win
2014-07-30 Work on the file system
    [build.cfg, helloWorld_pem4f.cfg, hello_pem4f.cfg]
2014-08-05 added non clock dependant uart code , added radio config code to use gpio to control radio command mode
2014-08-07 finalized the command mode via gpio to the radio, added a debug frame to string code to output raw bytes received bit BT to the radio to the debug port,
2014-08-08 dfu proc when usb data cable plugged in and device reset, device dfu request implemented
    [board.c, board.h, error_codes.h, ineedmd_bluetooth_radio.c, ineedmd_bluetooth_radio.h, ineedmd_command_protocol.c, ineedmd_watchdog.c, ineedmd_watchdog.h]
2014-08-09 added error_code to project, added watchdog,
    [board.c, board.h, error_codes.h, ineedmd_bluetooth_radio.c, ineedmd_watchdog.c, ineedmd_watchdog.h, main.c]
2014-08-13 Added DMA to uart. Added additional error codes.
    [board.c, board.h, error_codes.h, ineedmd_bluetooth_radio.c, main.c, tm4c1233h6pm_startup_ccs.c]
2014-08-13 added additional DMA functionality, beginning DMA interrupt analysis
2014-08-14 more DMA functionality, added buffers, polling, interrupt handling
2014-08-15 added more DMA functionality, this build still misses a CTS interrupt
2014-08-16 Added "manual" polling and clearing of interrupts. Added more iWrap command frame functionality.
2014-08-18 added additional error handling
    [board.c, ineedmd_bluetooth_radio.c]
2014-08-19 added more DMA functionality, begin going back to old method of talking to the radio
2014-08-28 ported in changes from ineedmd rel03 new LED sequences new IneedMD commands Radio force command mode
2014-08-29 added EOT radio uart interrupt fixed hard fault when DMA disabled added some debug messages completed the project debug independent HAL
    [board.c, board.h, ineedmd_bluetooth_radio.c, main.c, proj_debug.c, tm4c1233h6pm_startup_ccs.c]
2014-09-05 added high speed uart and uart compensation code, added debug gpio toggle PD1
2014-09-05 added high speed uart code to BT radio. Sawtooth waveform now a "smooth" output.
2014-09-08 Fixed sys reset during idle issue, cleaned up code for readability, added watchdog timer ISR, added beginnings of detecting USB while in super loop
    [battery.c, board.c, board.h, ineedmd_bluetooth_radio.c, ineedmd_watchdog.c, main.c, tm4c1233h6pm_startup_ccs.c]
2014-09-08 Added temperature ADC, and added real data into the return status command
2014-09-09 led show changes
2014-09-09 Added radio RFD feature to reset and DFU INMD protocol commands for firmware rollback compatibility, added some USBLIB files and code (currently not enabled)
    [board.c, ineedmd_bluetooth_radio.c, ineedmd_bluetooth_radio.h, ineedmd_command_protocol.c, ineedmd_watchdog.c, main.c, tm4c1233h6pm_startup_ccs.c]
2014-09-09 system now responsive to led test patterns requests, sys properly sleeps
2014-09-09 Update for proper calculation of battery voltage and setting the I2C speed properly.
2014-09-09 Change the SPI busses so that they are running on the PSIOC clock
2014-09-09 Correction to default clock speed
    [board.c]
2014-09-09 fixed board init... with clock set before i2c has been configured. The clost set function reconfigures the i2c clock. so calling it before the block is inited caused an exception
    [board.c]
2014-09-10 added radio low batt event handling, system low battery halt state, enhanced battery measurement code,
2014-09-11 added real time clock, added timer and peripheral speed correction when sys speed changes, DO NOT USE THIS BUILD, this is a back commit only. Code doesn't not behave when speed is changed.
    [board.c, board.h, clock.c, ineedmd_power_modes.c, main.c, tm4c1233h6pm_startup_ccs.c]
2014-09-11 Did cosmetic changes for placement of include files, removed implementation of sleep_for_tenths() which is primarily used in the UI, removing sleep_for_tenths also fixed the systick issue and was the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
    [battery.c, board.c, board.h, clock.c, ineedmd_UI.c, ineedmd_adc.c, ineedmd_command_protocol.c]
2014-09-11 added non-blocking UI code framework
2014-09-12 added more led sequences
2014-09-12 LED_PATTER ADDITIONS
2014-09-12 corrected command receive nack error
    [board.c, ineedmd_UI.c, ineedmd_adc.c, ineedmd_bluetooth_radio.c, ineedmd_bluetooth_radio.h, ineedmd_command_protocol.c, ineedmd_led.c, ineedmd_power_modes.c]
2014-09-12 update to the LED test code
2014-09-12 Implemented the LED colours
2014-09-12 enhanced framework for LED test commands in inmd protocol handling
2014-09-12 fixed and overwrite in ineedmd_led
    [ineedmd_led.c]
2014-09-13 update led CODE AND TIMING
2014-09-13 corrected HW delay function to have proper 1ms tick. corrected some static timeouts to better compensate,
    [board.c, ineedmd_bluetooth_radio.c, main.c]
2014-09-13 added pink led's
2014-09-17 added additional LED sequences, added non blocking ui requests to the protocol analyzer, moved and enhanced sleep and hold functions, made the "I'm alive" statements in the super loop easier to read,
2014-09-19 added RTOS to project and start of integration
    [app.cfg, app_pem4f.cfg, build.cfg]
2014-09-25 added uart5 for debug, added rtos friendly sys speed, began modifying bluetooth radio driver for RTOS friendly read and writes
    [app.cfg]
2014-10-07 Added messaging to UI, added the beginnings of LED sequences
    [app.cfg]
2014-10-07 Ported in LED code and UI framework
    [app.cfg]
2014-10-09 Added API and connectivity detection for the radio
    [app.cfg]
2014-10-10 Added protocol analyzer framework
    [app.cfg]
2014-10-14 Continued with protocol analyzer framework. added enum states and rtos friendly functions
2014-10-15 added the beginnings of protocol connection handling
    [app.cfg]
2014-10-16 Added protocol connection response framework, added radio receive interrupt handling
    [app.cfg]
2014-10-16 Added led sequences. Updated driver for flashing patterns
2014-10-16 Can now get and break protocol connection, protocol framework in place.
2014-10-17 Added design documents, radio now boots much faster, added SPI driver framework
    [10050 P3.3 Assy, ineedMD Mechanical.SLDASM, 10050 P3.4 Assy, ineedMD Mechanical.SLDDRW, 10050 P3.5 Assy, ineedMD Mechanical.SLDDRW, 10050 P3.6 Assy, ineedMD Mechanical.SLDDRW, 10051 P3.3 Bottom.SLDPRT, 10052 P3.3 Top.SLDPRT, 10053 P3.4 Light Pipe.SLDPRT, 10055 P3.4 Foam Cushion.SLDPRT]
2014-10-21 Added beginnings of EKG waveform, added beginnings of USB mass storage
    [app.cfg]
2014-10-23 Device now seen and intractable with as a USB mass storage drive in windows
    [app.cfg]
2014-10-25 USB detect and mass storage fully implemented, added fw design doc USB and A to D sections.
    [app.cfg]
2014-10-28 Command parser - added function stubs for commands command_protocol.h - made enum for led patterns explicit fixed BLOOTHOOTH -> BLUETOOTH UI.c, eIneedmd_UIRequest -> added ER_OK checks ineedmd_led.c 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
    [EK_TM4C123GXL.c, USBMSCD.c, USBMSCD.h, board.c, board.h, ineedmd_UI.c, ineedmd_USB.c]
